MuratovAS/KiCadLibrary/Design/file-fAozOVlaFB.png

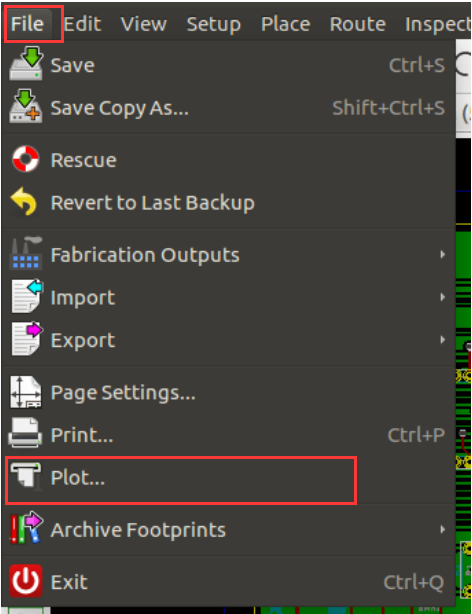
Design/file-fAozOVlaFB.png
