MuratovAS/KiCadLibrary/Design/file-UGBUPNOf6w.png

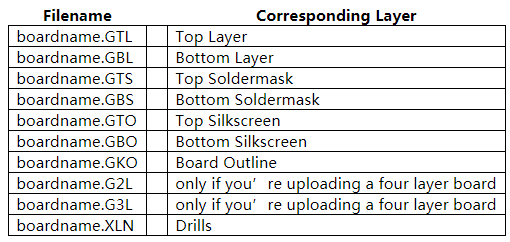
Design/file-UGBUPNOf6w.png
