MuratovAS/KiCadLibrary/Design/FjrqlNe.png

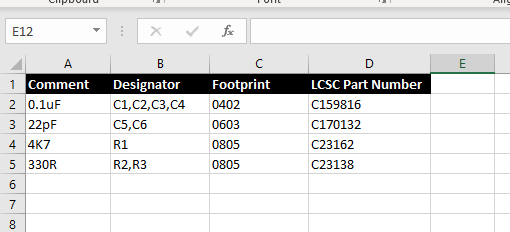
Design/FjrqlNe.png
