MuratovAS/KiCadLibrary/Design/image-20200629161657281.png

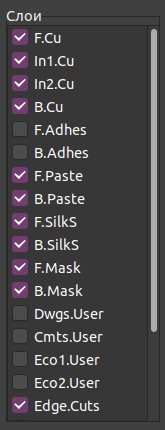
Design/image-20200629161657281.png
