MuratovAS/KiCadLibrary/Design/image-20200629163002211.png

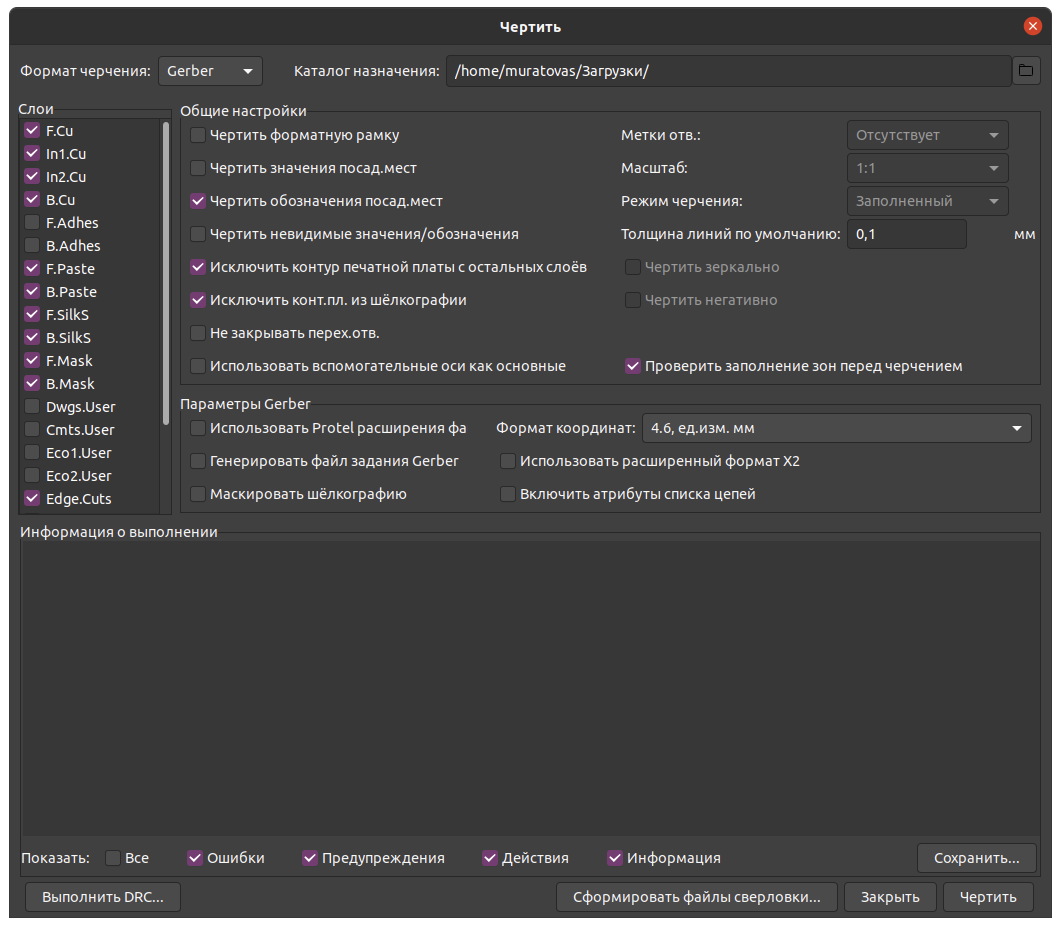
Design/image-20200629163002211.png
