MuratovAS/KiCadLibrary/Design/image-20200629163720507.png

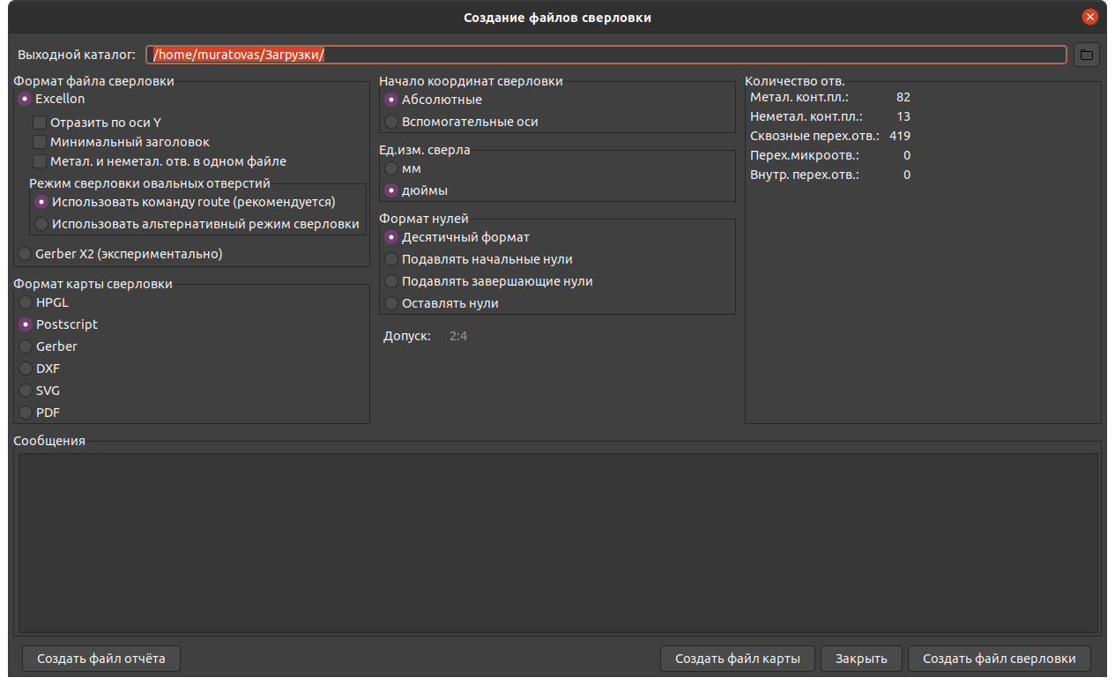
Design/image-20200629163720507.png
