MuratovAS/KiCadLibrary/Design/image-20200629165521541.png

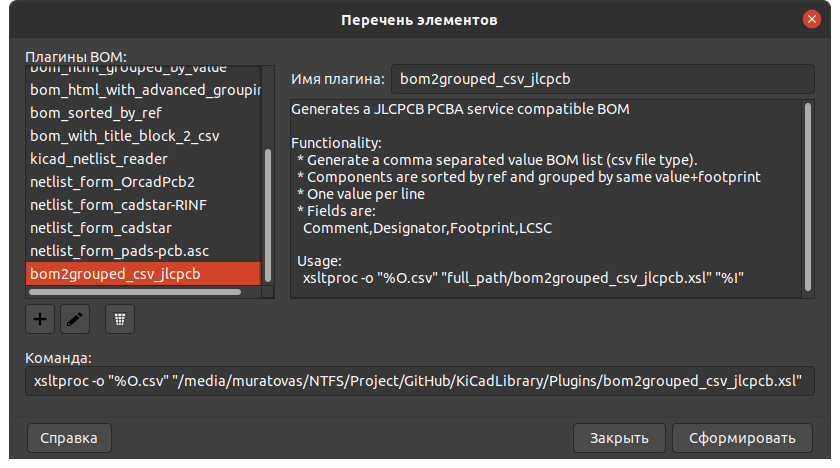
Design/image-20200629165521541.png
