MuratovAS/KiCadLibrary/Design/image-20200629165741140.png

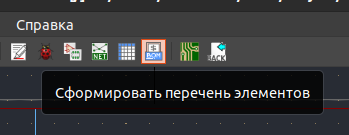
Design/image-20200629165741140.png
