MuratovAS/KiCadLibrary/Design/image-20200629170337778.png

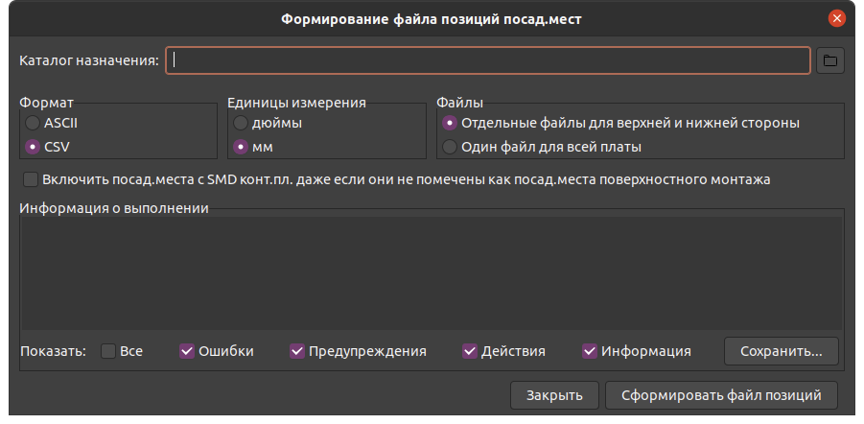
Design/image-20200629170337778.png
