MuratovAS/KiCadLibrary/Design/JpazXtn.png

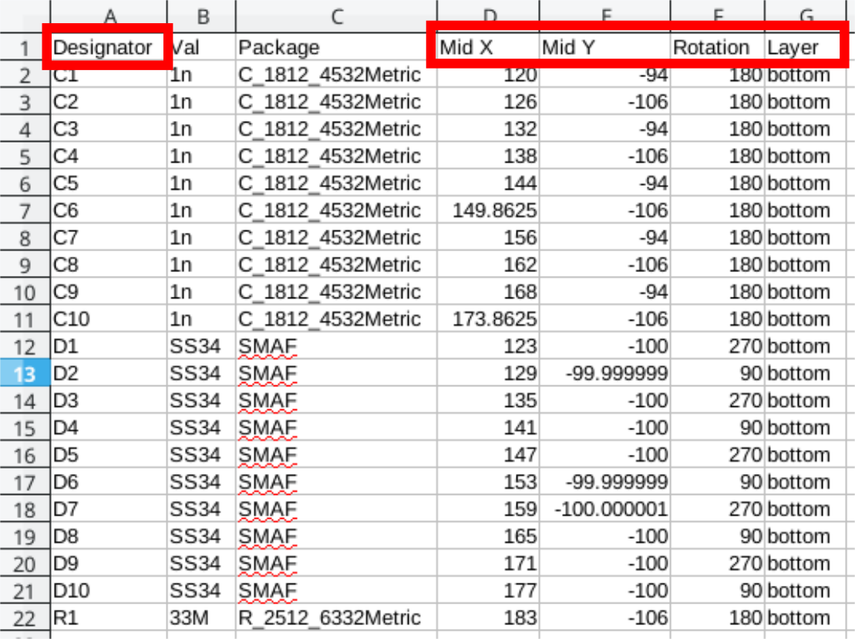
Design/JpazXtn.png
