MuratovAS/KiCadLibrary/MAS_3DModel/BUS_PCI_Express_Mini_cardFull.step

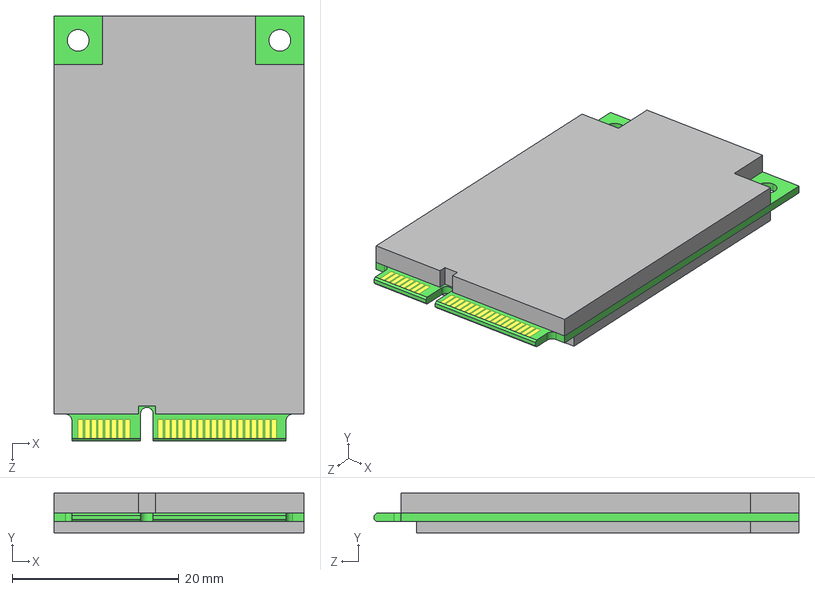
[picture p16: CAD file, 2023-09-08]
MAS_3DModel/BUS_PCI_Express_Mini_cardFull.step
30.0 x 4.75 x 51.0 mm
