MuratovAS/KiCadLibrary/MAS_3DModel/W9751G6NB.stp

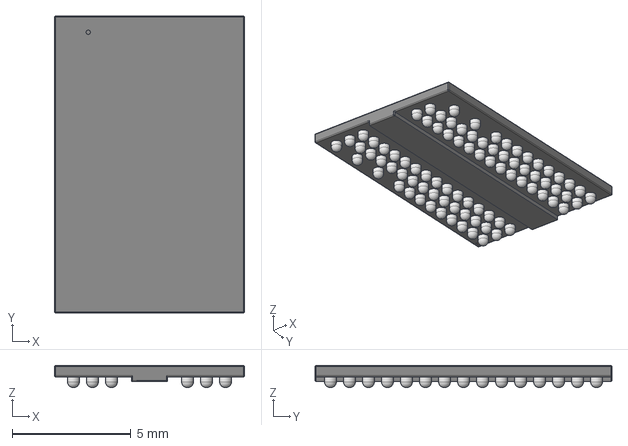
[picture p17: CAD file, 2026-10-26]
MAS_3DModel/W9751G6NB.stp
8.00 x 12.5 x 0.93 mm
