MuratovAS/KiCadLibrary/MAS_3DModel/CONB127P-2R-16W_TH.STEP

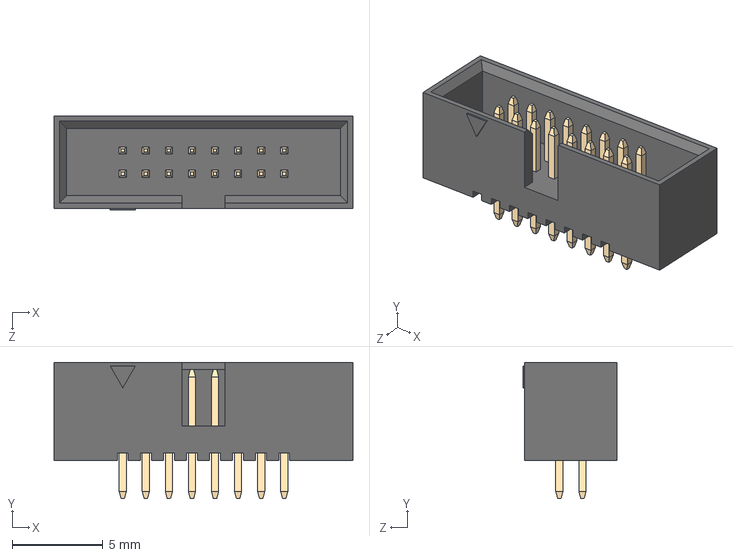
[picture p18: CAD file, 2026-10-22]
MAS_3DModel/CONB127P-2R-16W_TH.STEP
16.5 x 7.50 x 5.20 mm
