MuratovAS/KiCadLibrary/MAS_3DModel/CONB127P-2R-20W_TH.STEP

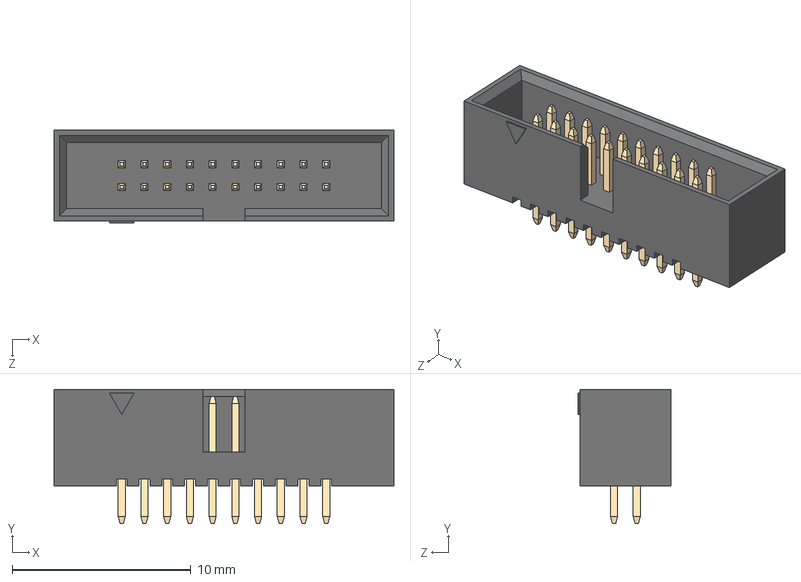
[picture p19: CAD file, 2026-10-22]
MAS_3DModel/CONB127P-2R-20W_TH.STEP
19.0 x 7.50 x 5.20 mm
