MuratovAS/KiCadLibrary/MAS_3DModel/CONB127P-2R-14W_TH.STEP

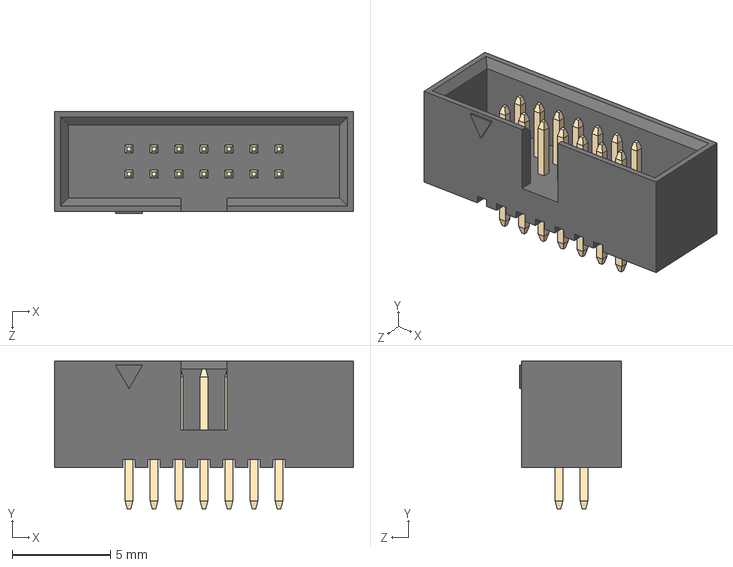
[picture p20: CAD file, 2026-10-22]
MAS_3DModel/CONB127P-2R-14W_TH.STEP
15.2 x 7.50 x 5.20 mm
