MuratovAS/KiCadLibrary/MAS_3DModel/CONB127P-2R-26W_TH.STEP

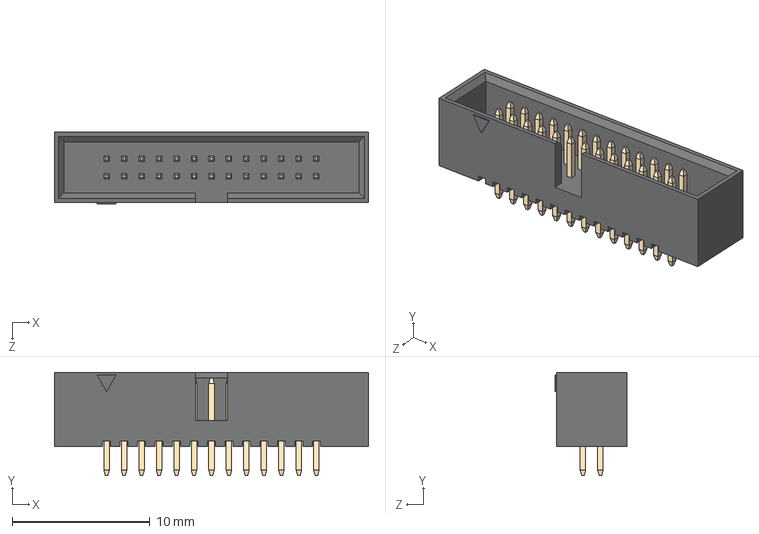
[picture p21: CAD file, 2026-10-22]
MAS_3DModel/CONB127P-2R-26W_TH.STEP
22.8 x 7.50 x 5.20 mm
