MuratovAS/KiCadLibrary/MAS_3DModel/MP_Wurth_WP-BUCF_7461086.stp

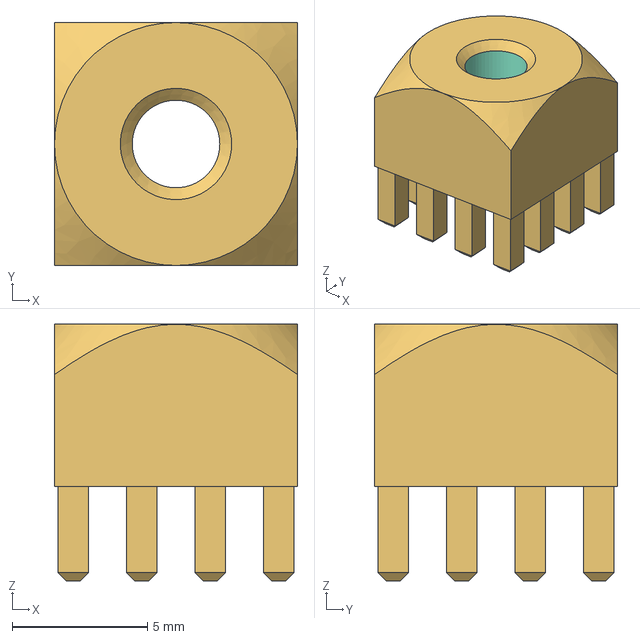
[picture p22: CAD file, 2026-10-15]
MAS_3DModel/MP_Wurth_WP-BUCF_7461086.stp
9.00 x 9.00 x 9.50 mm
