MuratovAS/KiCadLibrary/MAS_3DModel/SIP-8.stp

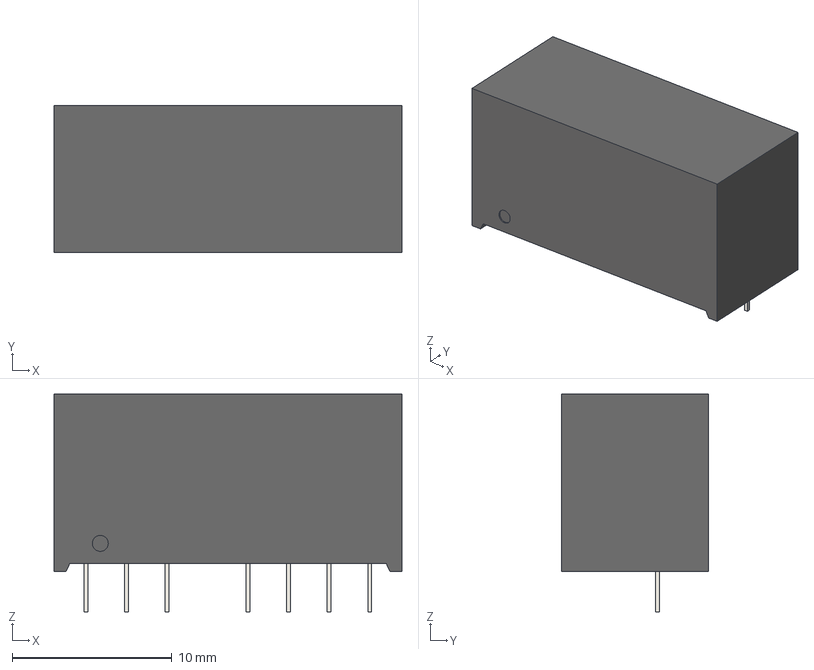
[picture p23: CAD file, 2026-09-12]
MAS_3DModel/SIP-8.stp
21.8 x 9.20 x 13.6 mm
SIP-8
SIP-001
SIP-002
SIP-003
SIP-004
SIP-005
SIP-006
SIP-007
