MuratovAS/KiCadLibrary/MAS_3DModel/TSSOP-28_7.5x10.5mm_P0.65mm.stp

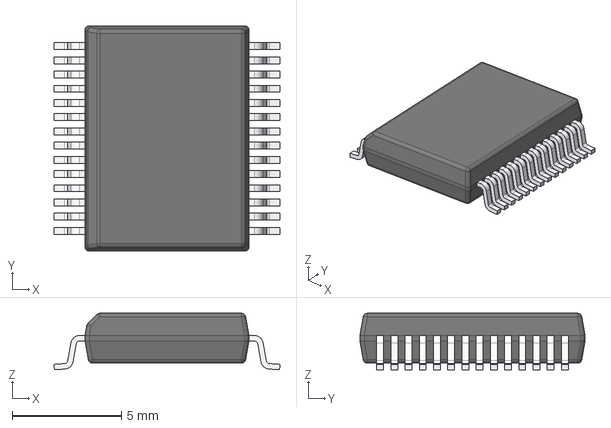
[picture p24: CAD file, 2026-09-12]
MAS_3DModel/TSSOP-28_7.5x10.5mm_P0.65mm.stp
10.3 x 10.3 x 2.59 mm
LEAD x 28
