MuratovAS/KiCadLibrary/MAS_3DModel/DG381-3.81-02P-14-00AH.STEP

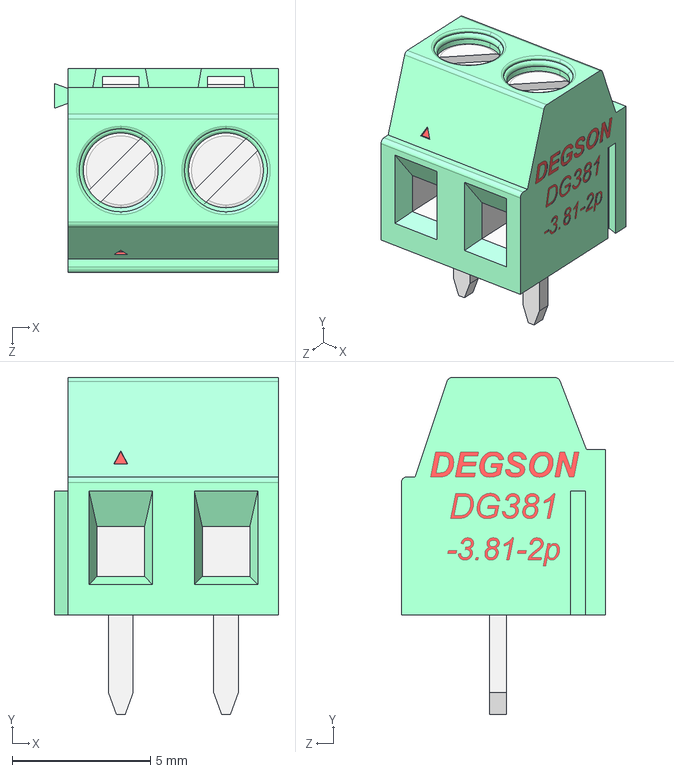
[picture p25: CAD file, 2026-08-06]
MAS_3DModel/DG381-3.81-02P-14-00AH.STEP
8.12 x 12.2 x 7.40 mm
