MuratovAS/KiCadLibrary/MAS_3DModel/15EDGRC-3.81-11P.stp

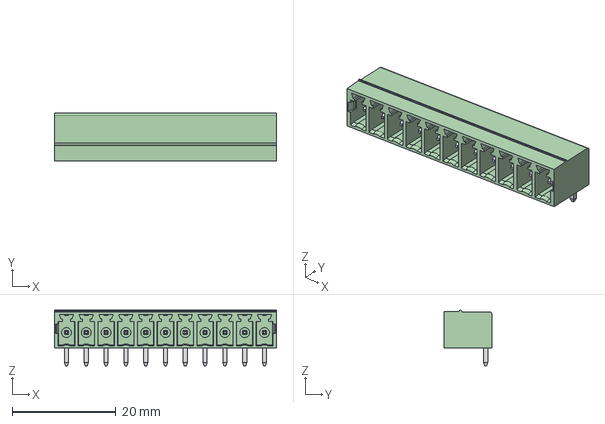
[picture p26: CAD file, 2026-08-06]
MAS_3DModel/15EDGRC-3.81-11P.stp
42.7 x 9.20 x 10.7 mm
15EDGxC-3.81-11P
15EDGRC_pin x 11
