MuratovAS/KiCadLibrary/MAS_3DModel/SCH16T.stp

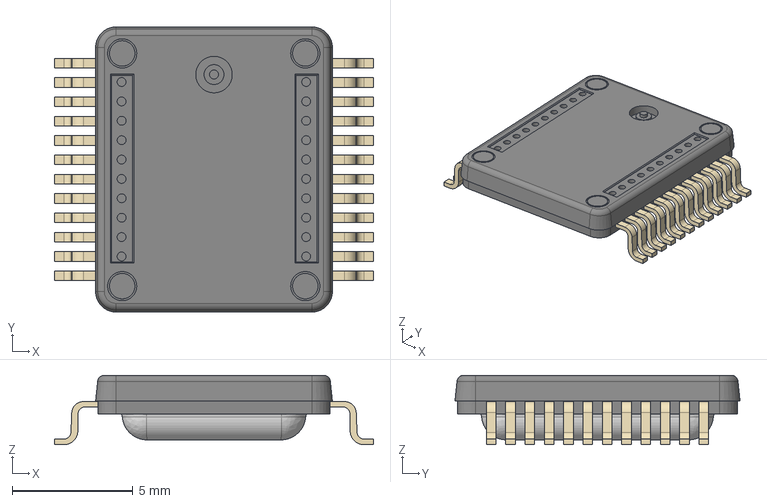
[picture p27: CAD file, 2026-07-28]
MAS_3DModel/SCH16T.stp
13.2 x 11.8 x 2.87 mm
