MuratovAS/KiCadLibrary/MAS_3DModel/TRACO_THR_40-72xWI.stp

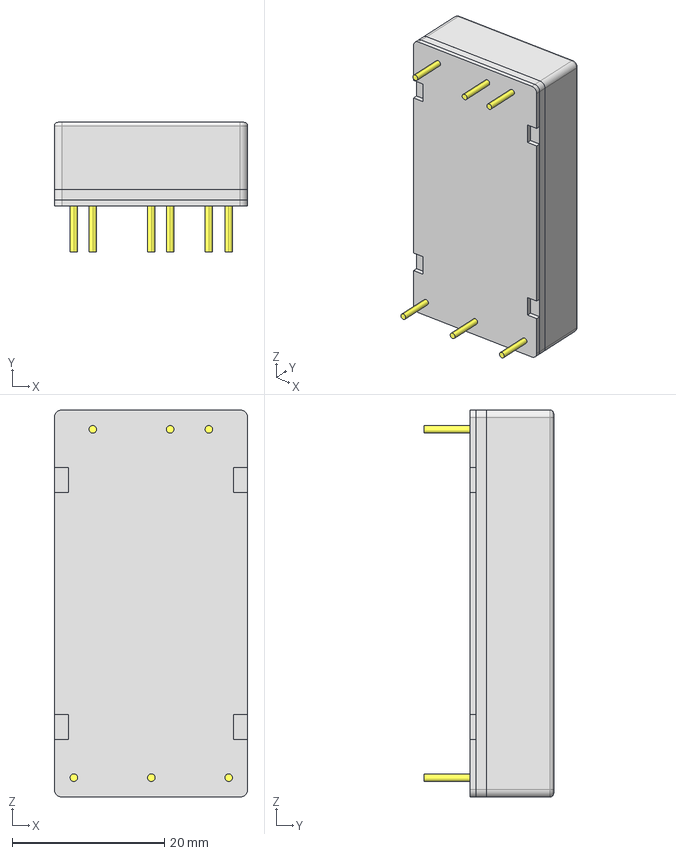
[picture p28: CAD file, 2026-07-25]
MAS_3DModel/TRACO_THR_40-72xWI.stp
25.4 x 17.0 x 50.8 mm
