MuratovAS/KiCadLibrary/MAS_3DModel/RJ45_AT-889X1-FSE_Vertical.step

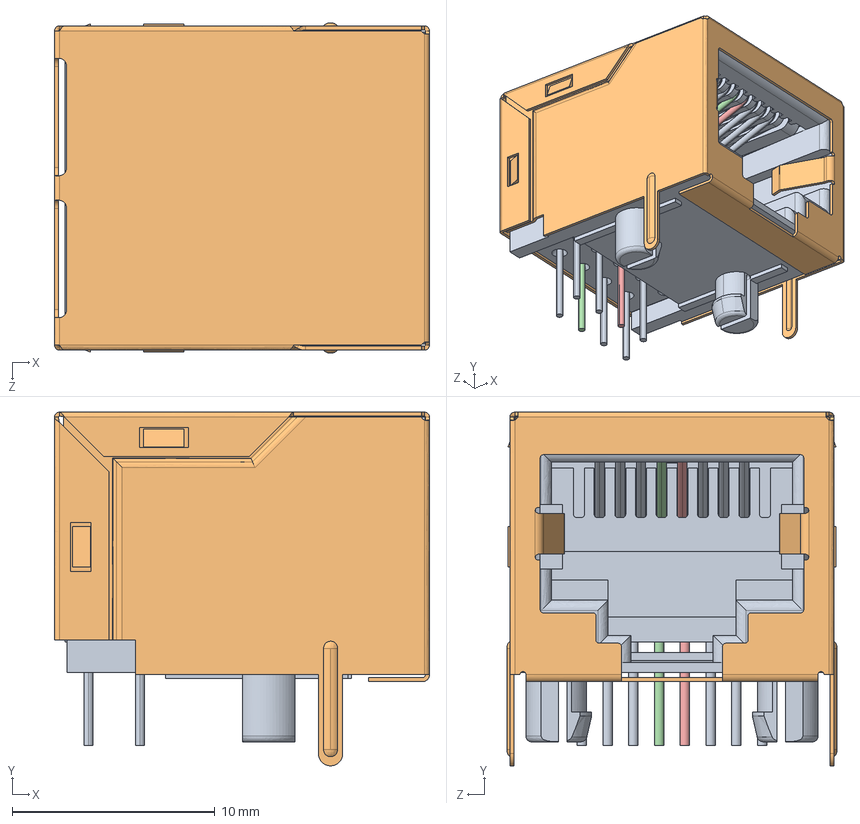
[picture p29: CAD file, 2026-07-22]
MAS_3DModel/RJ45_AT-889X1-FSE_Vertical.step
18.5 x 17.4 x 16.3 mm
