MuratovAS/KiCadLibrary/MAS_3DModel/RJ45_TE_100616-X_Vertical.stp

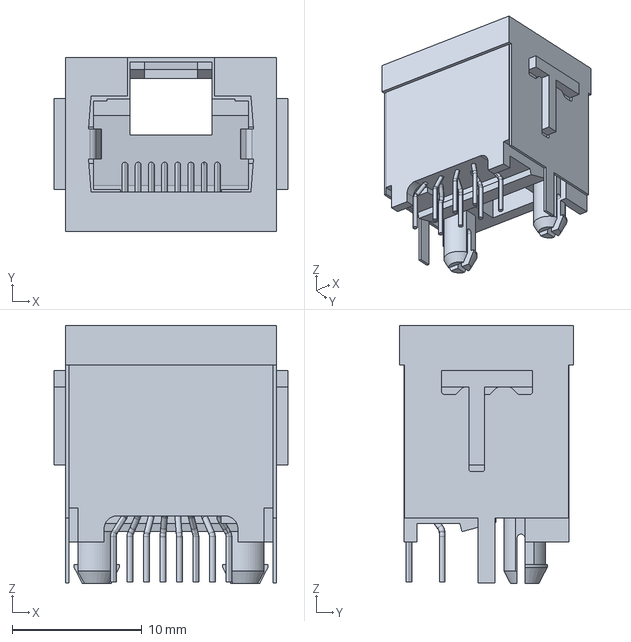
[picture p30: CAD file, 2026-07-03]
MAS_3DModel/RJ45_TE_100616-X_Vertical.stp
18.0 x 13.4 x 19.9 mm
