MuratovAS/KiCadLibrary/MAS_3DModel/Molex_Micro-Fit_3.0_43645-0400_1x04_P3.00mm.stp

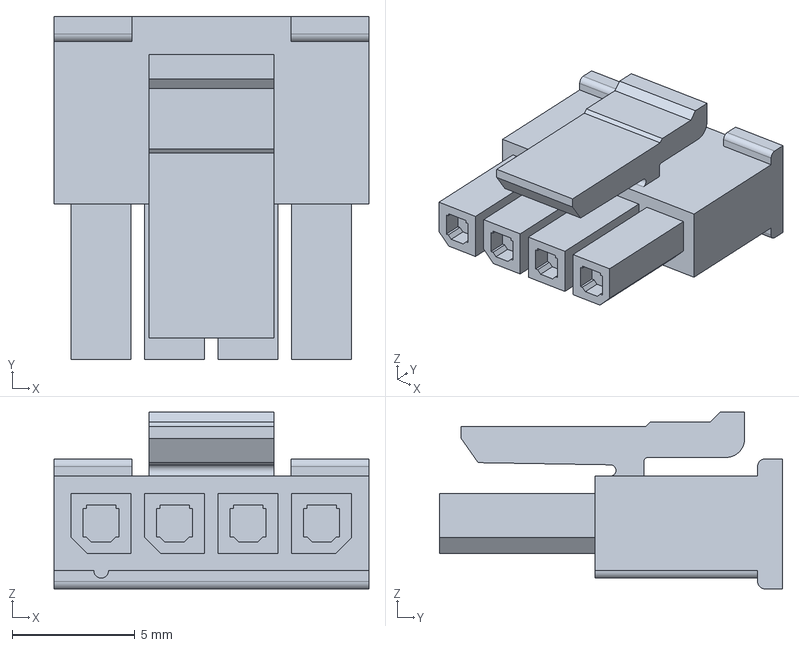
[picture p31: CAD file, 2026-07-01]
MAS_3DModel/Molex_Micro-Fit_3.0_43645-0400_1x04_P3.00mm.stp
12.8 x 14.0 x 7.21 mm
