MuratovAS/KiCadLibrary/MAS_3DModel/Molex_Micro-Fit_3.0_43650-0415_1x04_P3.00mm_Vertical.stp

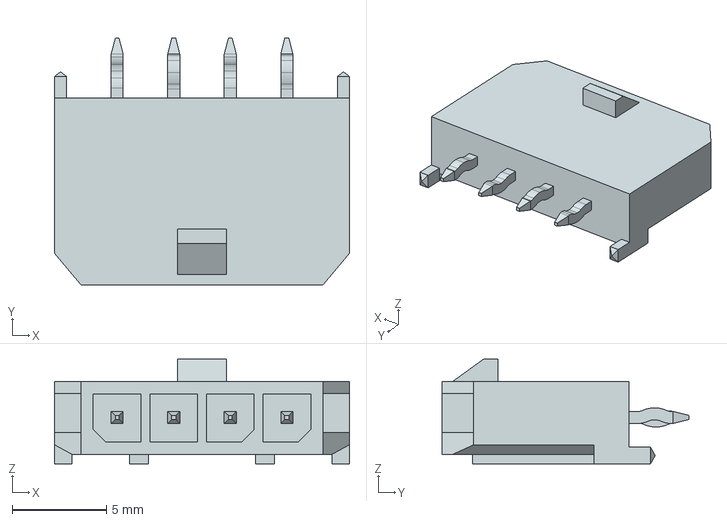
[picture p32: CAD file, 2026-07-01]
MAS_3DModel/Molex_Micro-Fit_3.0_43650-0415_1x04_P3.00mm_Vertical.stp
15.7 x 13.1 x 5.57 mm
