MuratovAS/KiCadLibrary/MAS_3DModel/RJ45_TE_1734577-1_Vertical.stp

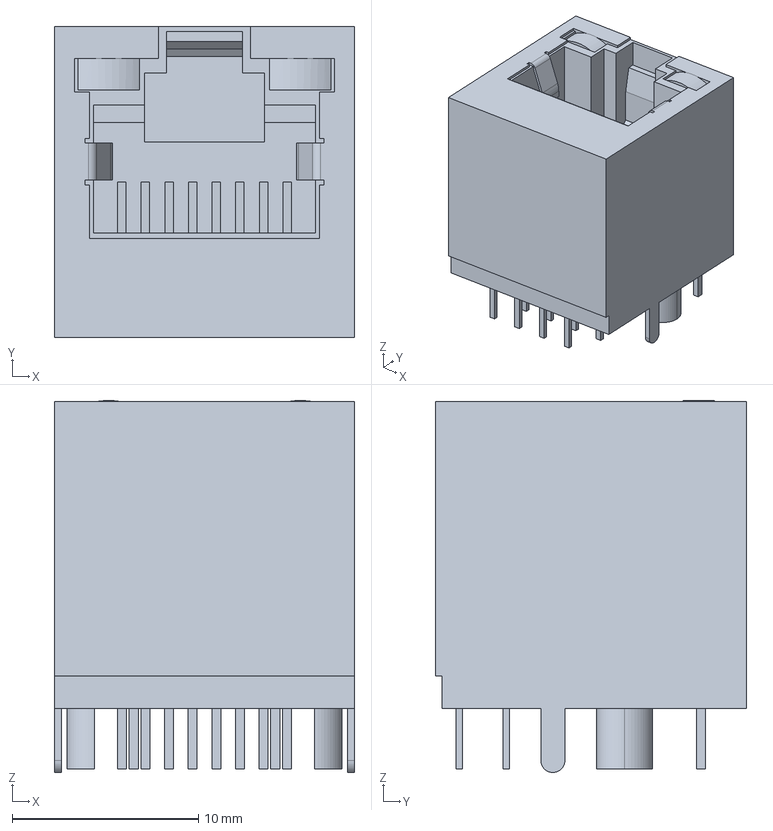
[picture p33: CAD file, 2026-07-01]
MAS_3DModel/RJ45_TE_1734577-1_Vertical.stp
16.1 x 16.7 x 20.0 mm
