MuratovAS/KiCadLibrary/MAS_3DModel/Fuse_2410.step

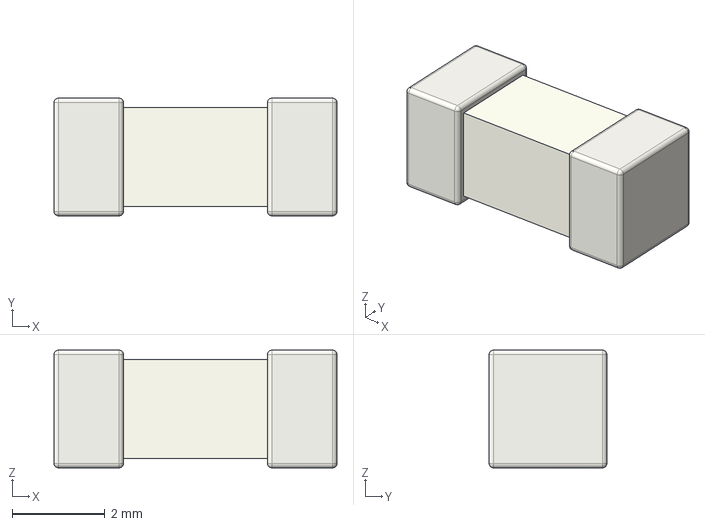
[picture p34: CAD file, 2026-05-28]
MAS_3DModel/Fuse_2410.step
6.10 x 2.54 x 2.54 mm
