MuratovAS/KiCadLibrary/MAS_3DModel/DFN-8L-1EP-S_3.3x3.3mm_P0.65mm_EP1.93x2.45mm.step

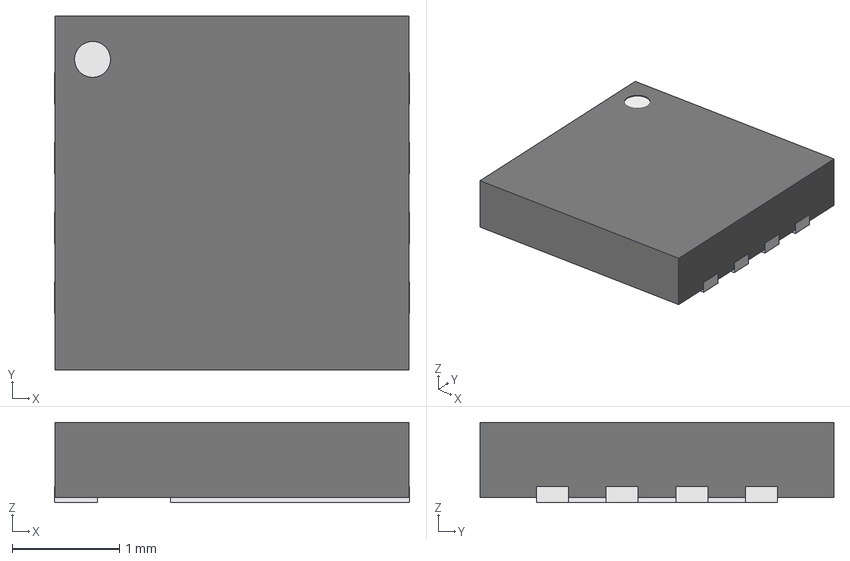
[picture p35: CAD file, 2026-05-27]
MAS_3DModel/DFN-8L-1EP-S_3.3x3.3mm_P0.65mm_EP1.93x2.45mm.step
3.31 x 3.30 x 0.75 mm
