MuratovAS/KiCadLibrary/MAS_3DModel/MBS.step

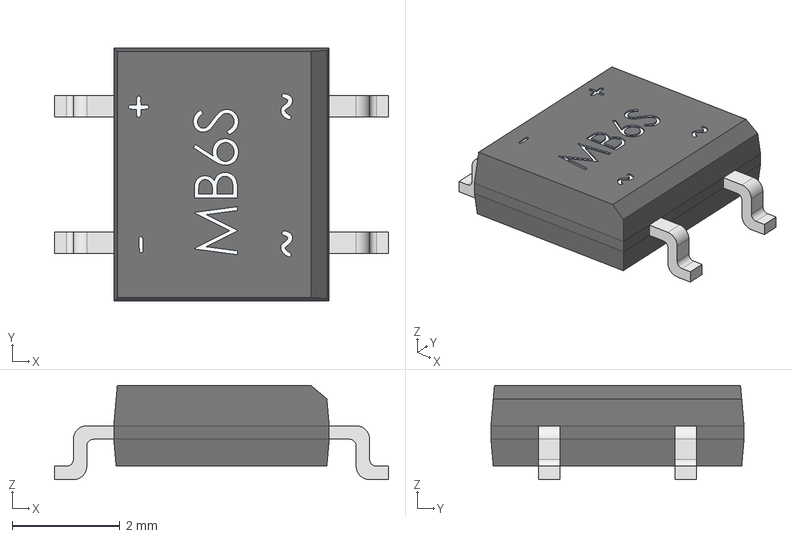
[picture p36: CAD file, 2026-05-25]
MAS_3DModel/MBS.step
6.20 x 4.70 x 1.75 mm
