MuratovAS/KiCadLibrary/MAS_3DModel/DFN-10-1EP_2x2mm_P0.4mm_EP0.9x1.5mm.step

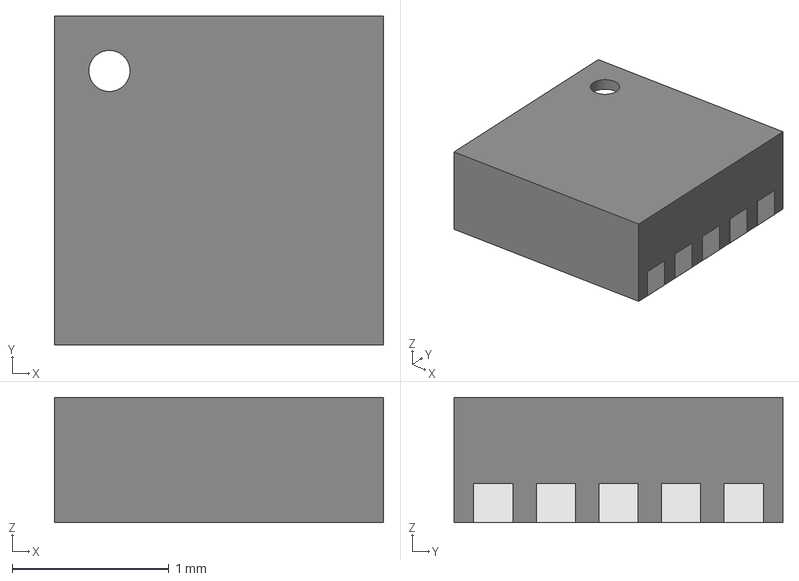
[picture p37: CAD file, 2026-05-06]
MAS_3DModel/DFN-10-1EP_2x2mm_P0.4mm_EP0.9x1.5mm.step
2.10 x 2.10 x 0.801 mm
Thermal Shape
