MuratovAS/KiCadLibrary/MAS_3DModel/ublox-NEO.step

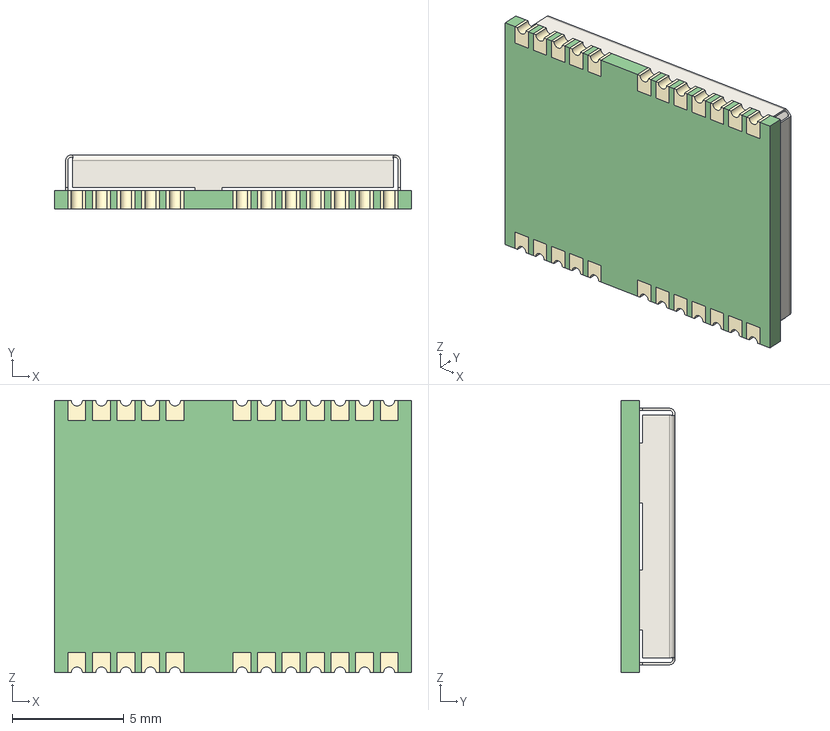
[picture p38: CAD file, 2026-05-06]
MAS_3DModel/ublox-NEO.step
16.0 x 2.42 x 12.2 mm
Board
Solder pads
