MuratovAS/KiCadLibrary/MAS_3DModel/DF40HC(3.0)-100DS-0.4V.step

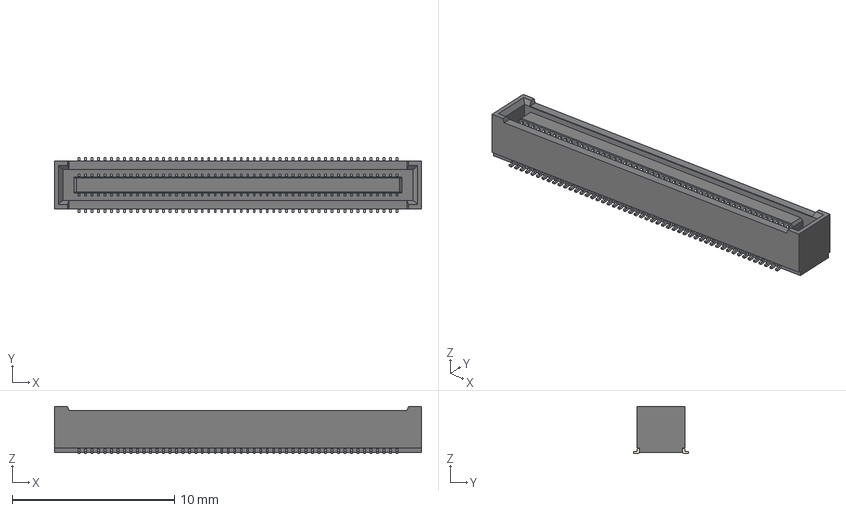
[picture p40: CAD file, 2026-03-02]
MAS_3DModel/DF40HC(3.0)-100DS-0.4V.step
22.6 x 3.38 x 2.90 mm
