MuratovAS/KiCadLibrary/MAS_3DModel/KLS2-EDR-5.08-02P-4.step

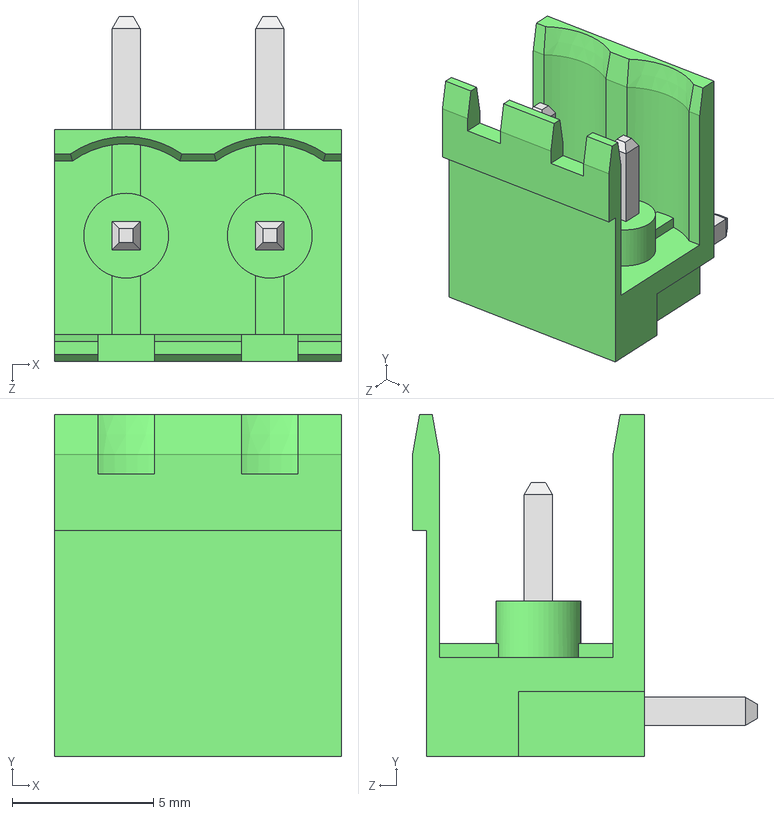
[picture p41: CAD file, 2026-02-09]
MAS_3DModel/KLS2-EDR-5.08-02P-4.step
10.2 x 12.1 x 12.2 mm
