MuratovAS/KiCadLibrary/MAS_3DModel/POGO_PIN_(C2842933).step

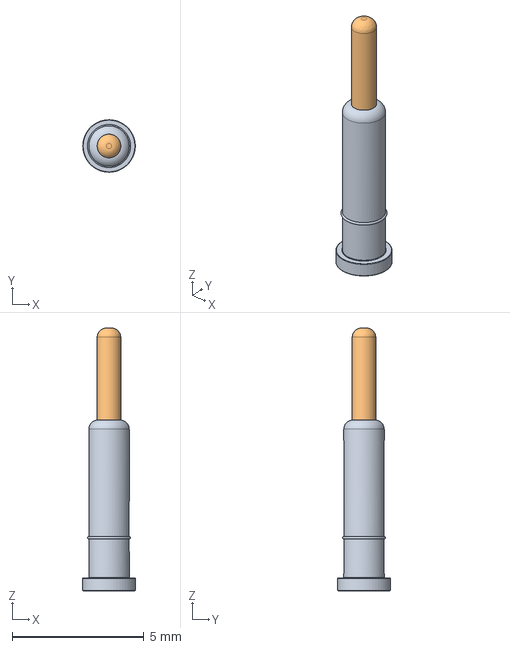
[picture p42: CAD file, 2026-01-09]
MAS_3DModel/POGO_PIN_(C2842933).step
2.00 x 2.00 x 10.0 mm
Base
Pin
