MuratovAS/KiCadLibrary/MAS_3DModel/TMH_2412S.STEP

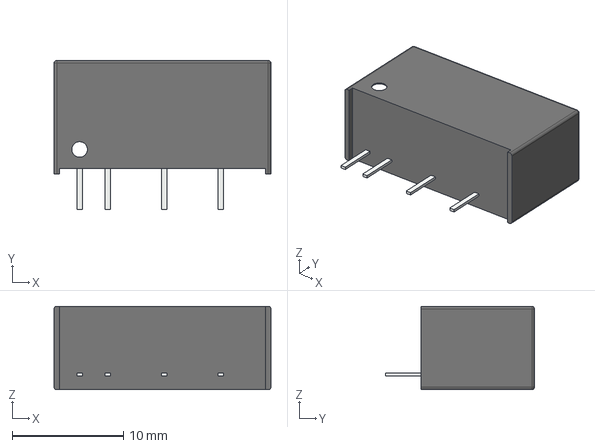
[picture p43: CAD file, 2025-12-05]
MAS_3DModel/TMH_2412S.STEP
19.5 x 13.4 x 7.50 mm
