MuratovAS/KiCadLibrary/MAS_3DModel/MX1016B-10.16-03P.step

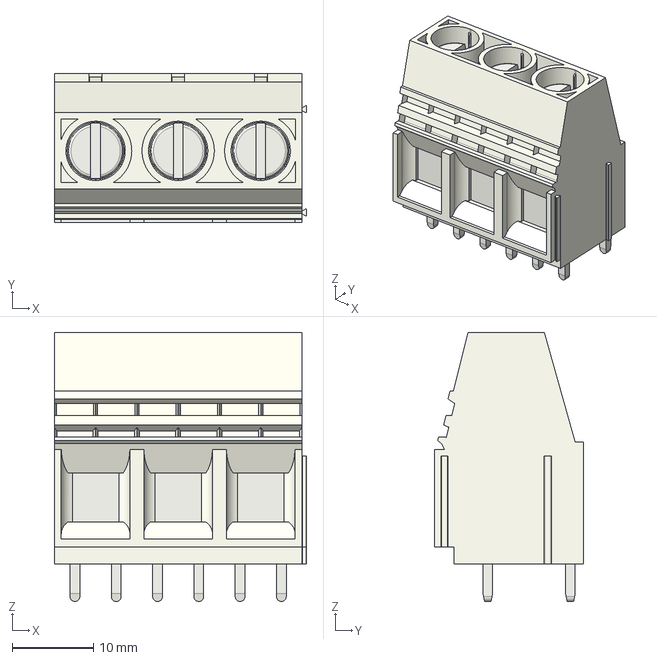
[picture p44: CAD file, 2025-11-14]
MAS_3DModel/MX1016B-10.16-03P.step
31.0 x 18.3 x 33.1 mm
