MuratovAS/KiCadLibrary/MAS_3DModel/MeanWell_IRM-30-x.step

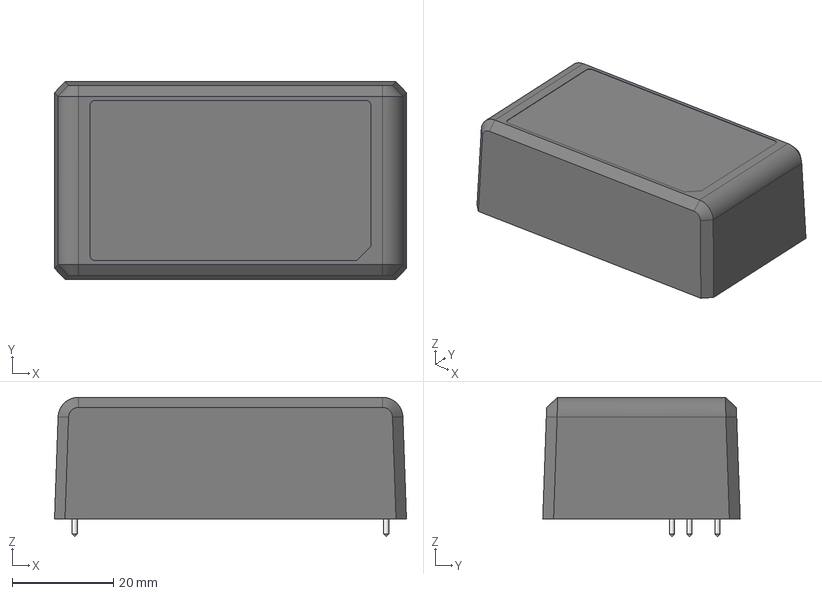
[picture p45: CAD file, 2025-11-11]
MAS_3DModel/MeanWell_IRM-30-x.step
69.5 x 39.0 x 27.5 mm
