MuratovAS/KiCadLibrary/MAS_3DModel/R_3920.STEP

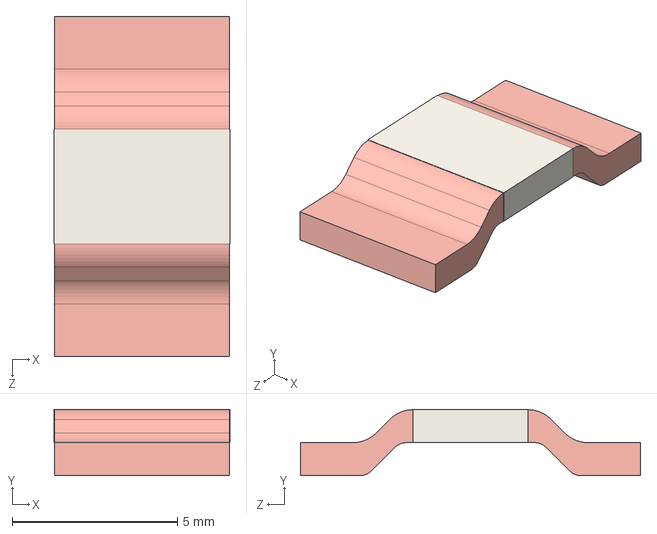
[picture p46: CAD file, 2025-11-05]
MAS_3DModel/R_3920.STEP
5.32 x 2.01 x 10.3 mm
