MuratovAS/KiCadLibrary/MAS_3DModel/BL-R8812AF1.step

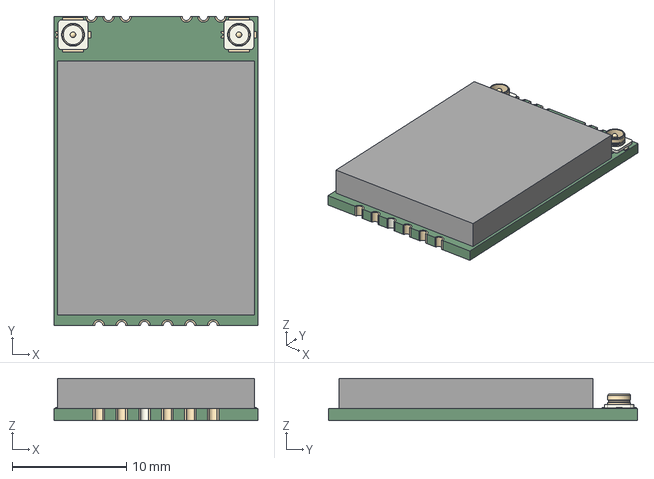
[picture p47: CAD file, 2025-10-19]
MAS_3DModel/BL-R8812AF1.step
17.8 x 27.0 x 3.68 mm
