MuratovAS/KiCadLibrary/MAS_3DModel/USL00-30L.step

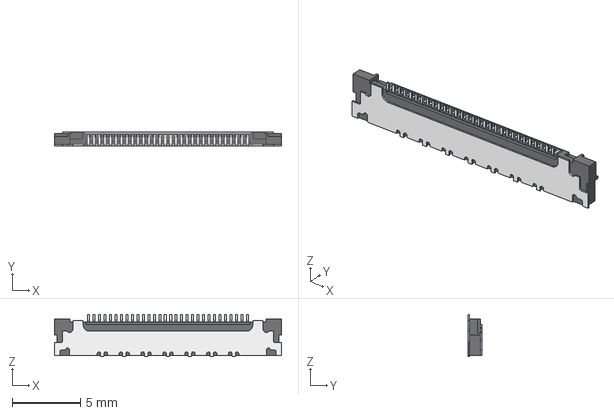
[picture p48: CAD file, 2025-06-16]
MAS_3DModel/USL00-30L.step
16.6 x 1.00 x 3.10 mm
