MuratovAS/KiCadLibrary/MAS_3DModel/USL00-30LC.step

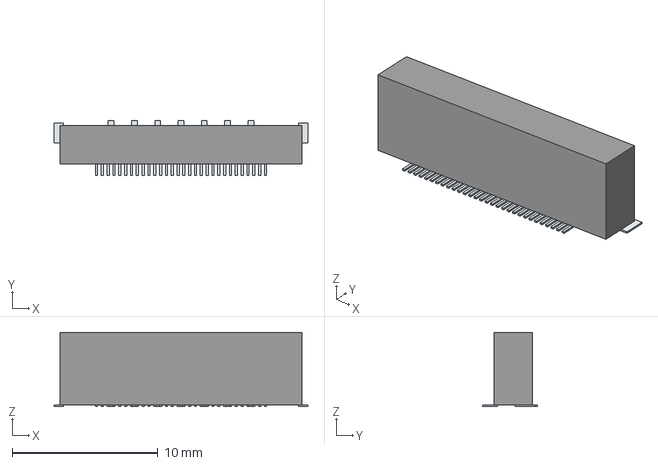
[picture p49: CAD file, 2025-06-16]
MAS_3DModel/USL00-30LC.step
17.4 x 3.81 x 5.10 mm
Pins
