MuratovAS/KiCadLibrary/MAS_3DModel/CF_0402_4pin.step

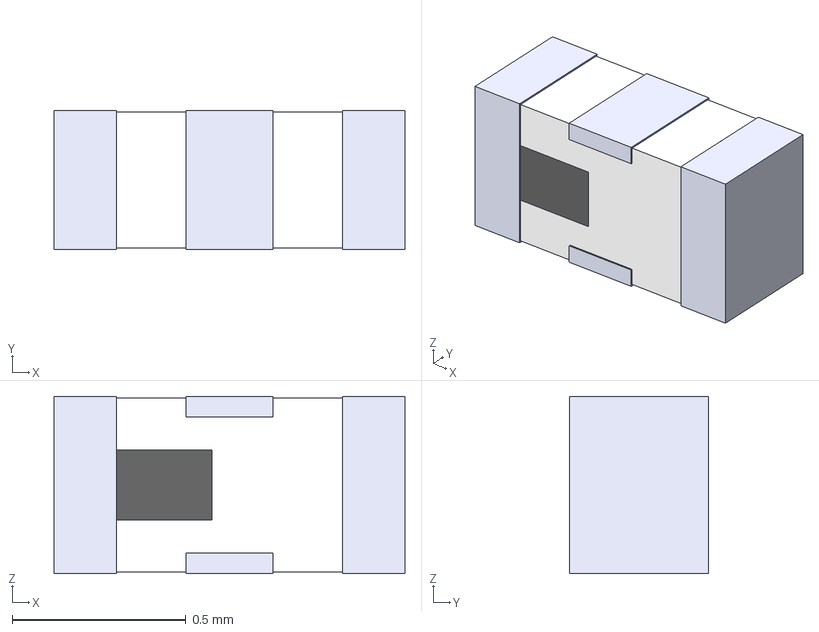
[picture p50: CAD file, 2025-03-28]
MAS_3DModel/CF_0402_4pin.step
1.01 x 0.4 x 0.51 mm
2450FM07A0029T
