MuratovAS/KiCadLibrary/MAS_3DModel/SMTSO3020.step

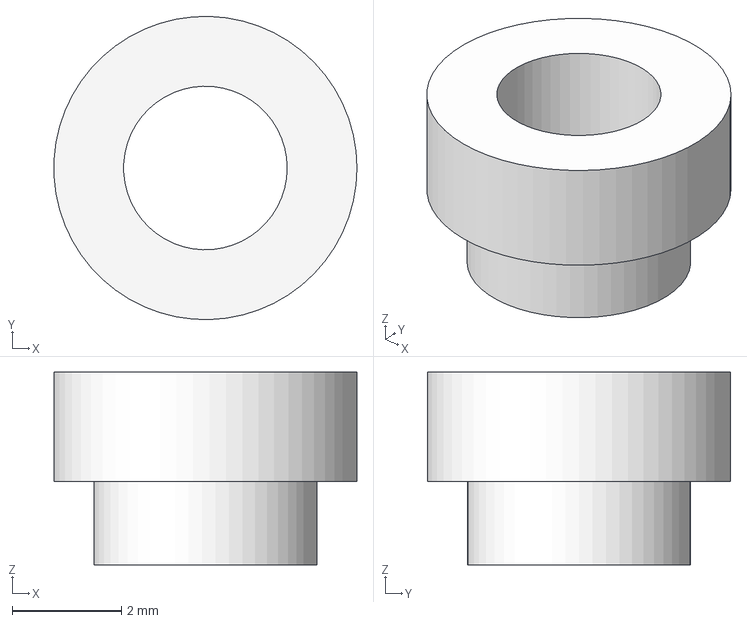
[picture p52: CAD file, 2025-03-26]
MAS_3DModel/SMTSO3020.step
5.56 x 5.56 x 3.53 mm
