MuratovAS/KiCadLibrary/MAS_3DModel/SMTSO3025.step

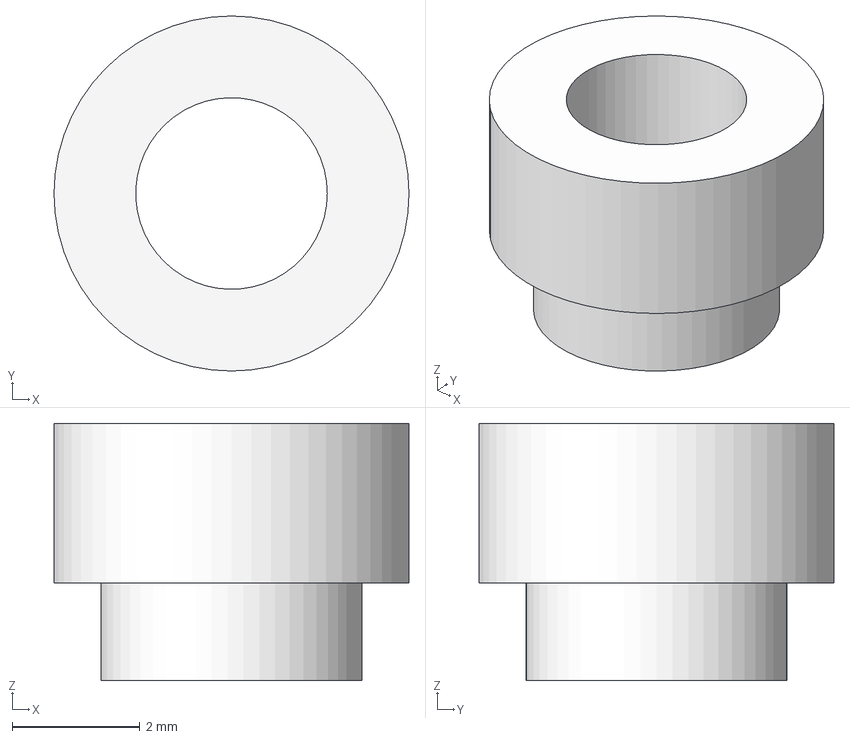
[picture p54: CAD file, 2025-03-26]
MAS_3DModel/SMTSO3025.step
5.56 x 5.56 x 4.03 mm
