MuratovAS/KiCadLibrary/MAS_3DModel/SMTSO3030.step

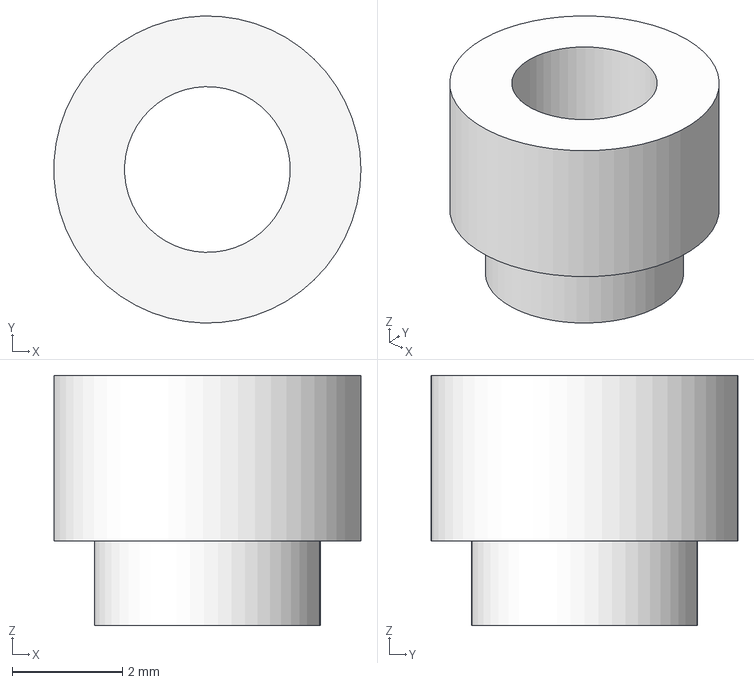
[picture p55: CAD file, 2025-03-26]
MAS_3DModel/SMTSO3030.step
5.56 x 5.56 x 4.53 mm
