MuratovAS/KiCadLibrary/MAS_3DModel/SMTSO3040.step

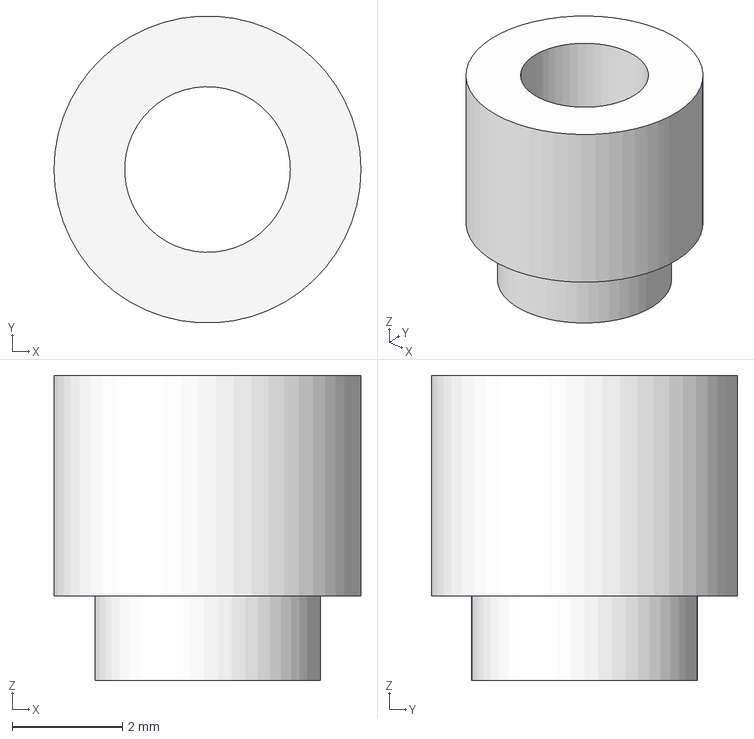
[picture p56: CAD file, 2025-03-26]
MAS_3DModel/SMTSO3040.step
5.56 x 5.55 x 5.53 mm
