MuratovAS/KiCadLibrary/MAS_3DModel/SMTSO3070.step

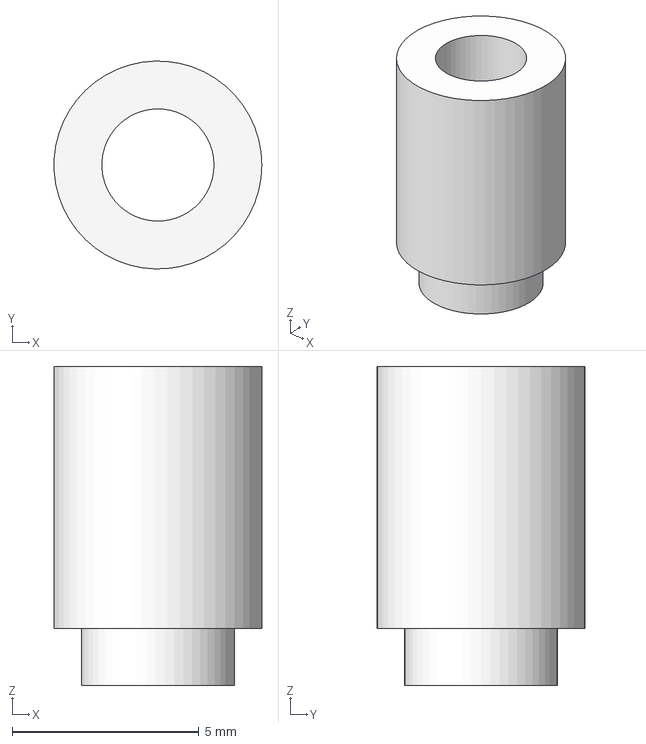
[picture p57: CAD file, 2025-03-26]
MAS_3DModel/SMTSO3070.step
5.55 x 5.56 x 8.53 mm
