MuratovAS/KiCadLibrary/MAS_3DModel/SMTSO3080.step

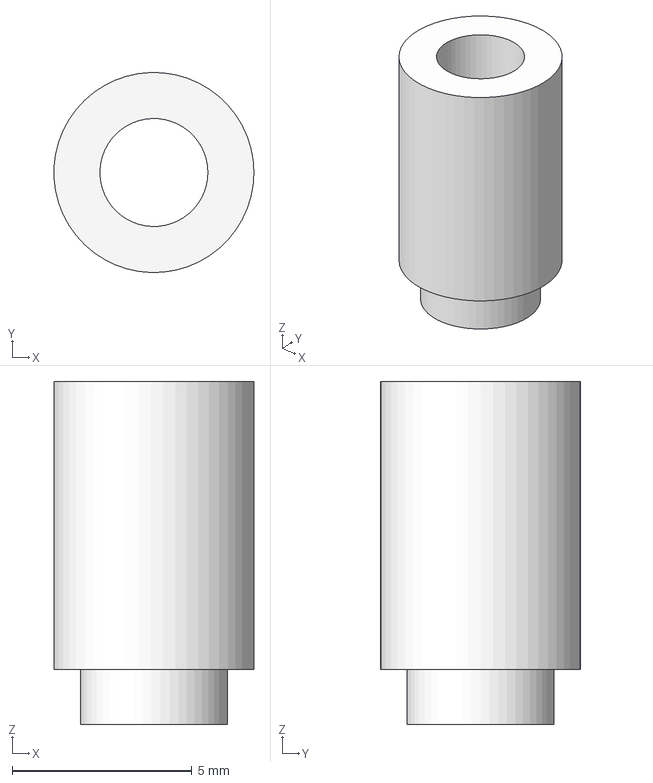
[picture p58: CAD file, 2025-03-26]
MAS_3DModel/SMTSO3080.step
5.55 x 5.56 x 9.53 mm
