MuratovAS/KiCadLibrary/MAS_3DModel/SMTSO3050.step

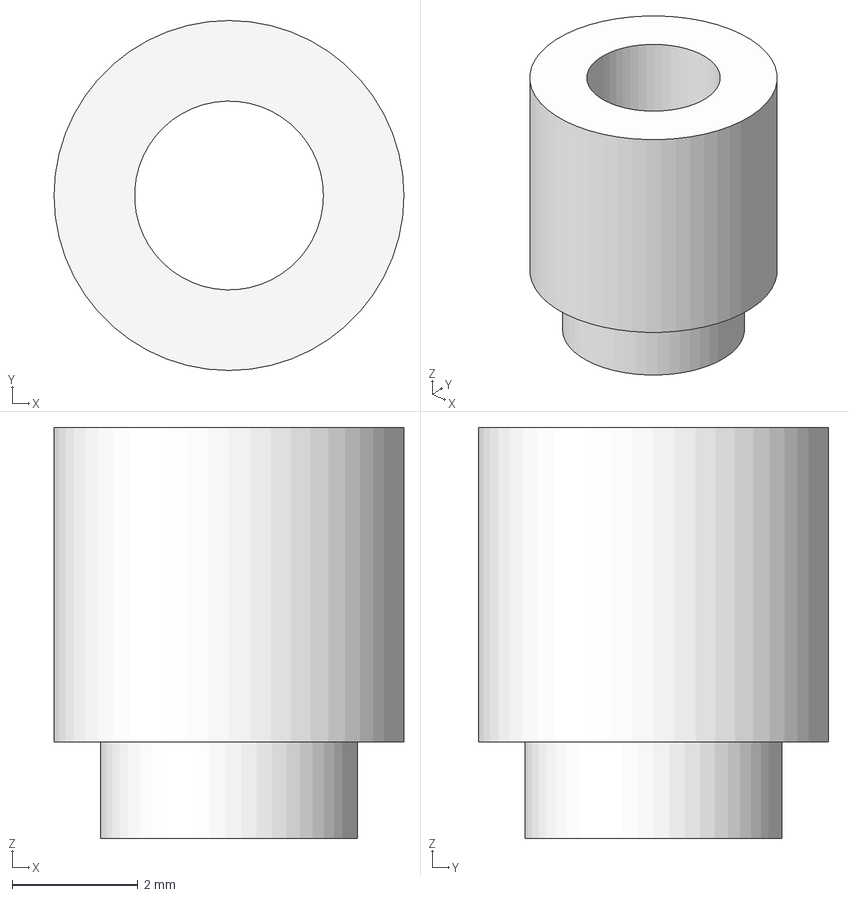
[picture p59: CAD file, 2025-03-26]
MAS_3DModel/SMTSO3050.step
5.56 x 5.56 x 6.53 mm
