MuratovAS/KiCadLibrary/MAS_3DModel/SMTSO3010.step

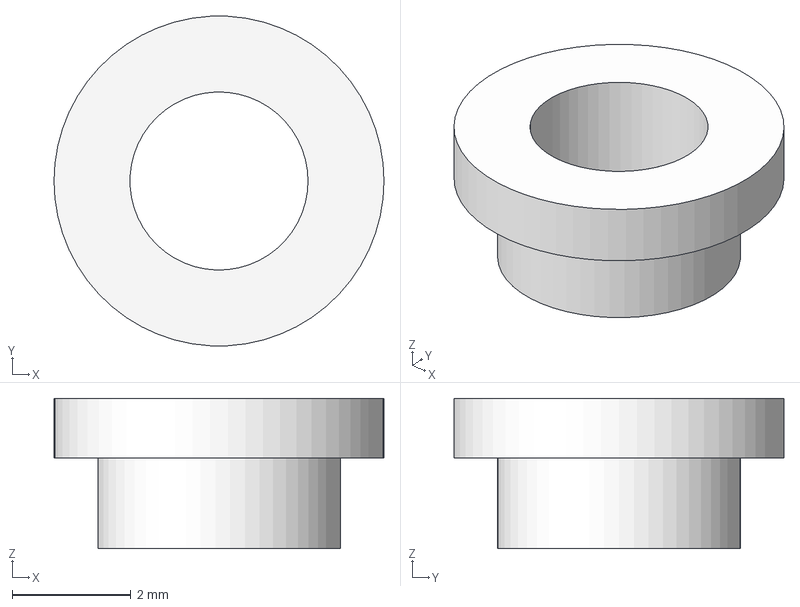
[picture p60: CAD file, 2025-03-26]
MAS_3DModel/SMTSO3010.step
5.56 x 5.55 x 2.53 mm
