MuratovAS/KiCadLibrary/MAS_3DModel/SMTSO3015.step

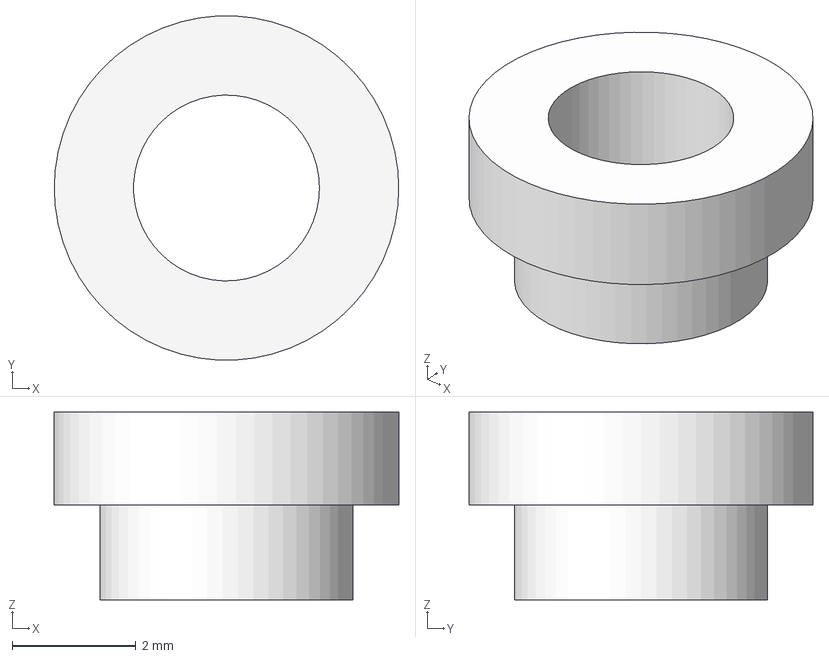
[picture p61: CAD file, 2025-03-26]
MAS_3DModel/SMTSO3015.step
5.56 x 5.55 x 3.03 mm
