MuratovAS/KiCadLibrary/MAS_3DModel/SMTSO3065.step

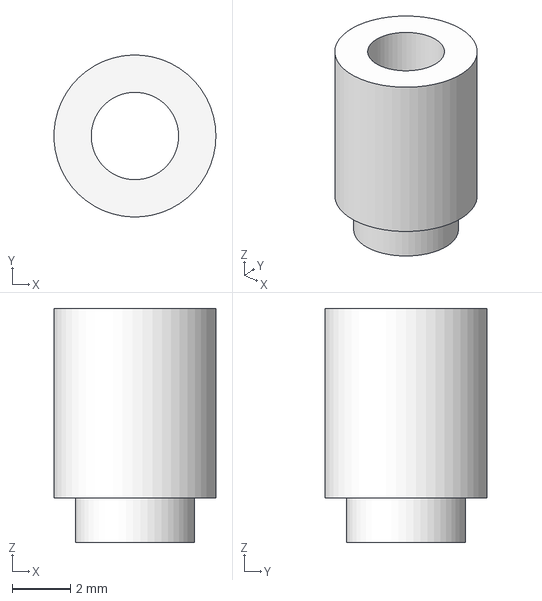
[picture p63: CAD file, 2025-03-26]
MAS_3DModel/SMTSO3065.step
5.55 x 5.56 x 8.03 mm
