MuratovAS/KiCadLibrary/MAS_3DModel/SMTSO3045.step

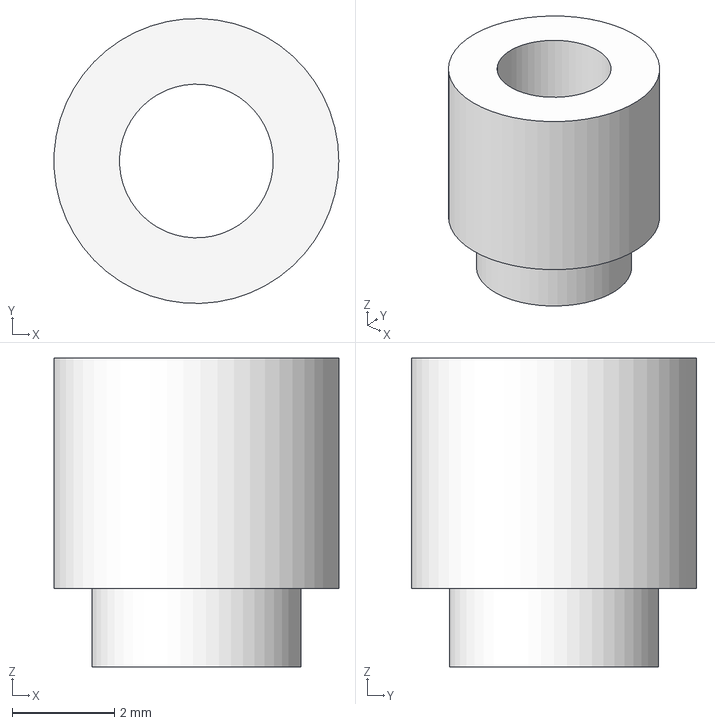
[picture p64: CAD file, 2025-03-26]
MAS_3DModel/SMTSO3045.step
5.56 x 5.56 x 6.03 mm
