MuratovAS/KiCadLibrary/MAS_3DModel/SMTSO3035.step

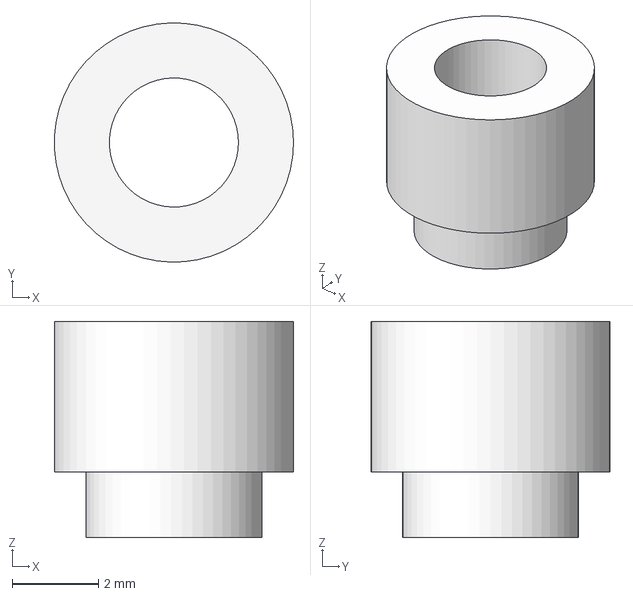
[picture p65: CAD file, 2025-03-26]
MAS_3DModel/SMTSO3035.step
5.56 x 5.56 x 5.03 mm
