MuratovAS/KiCadLibrary/MAS_3DModel/SMTSO3090.step

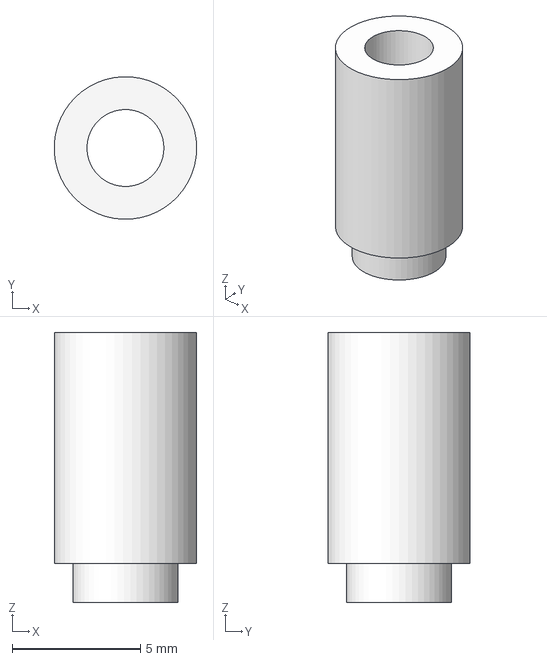
[picture p66: CAD file, 2025-03-26]
MAS_3DModel/SMTSO3090.step
5.55 x 5.56 x 10.5 mm
