MuratovAS/KiCadLibrary/MAS_3DModel/SMTSO2015.step

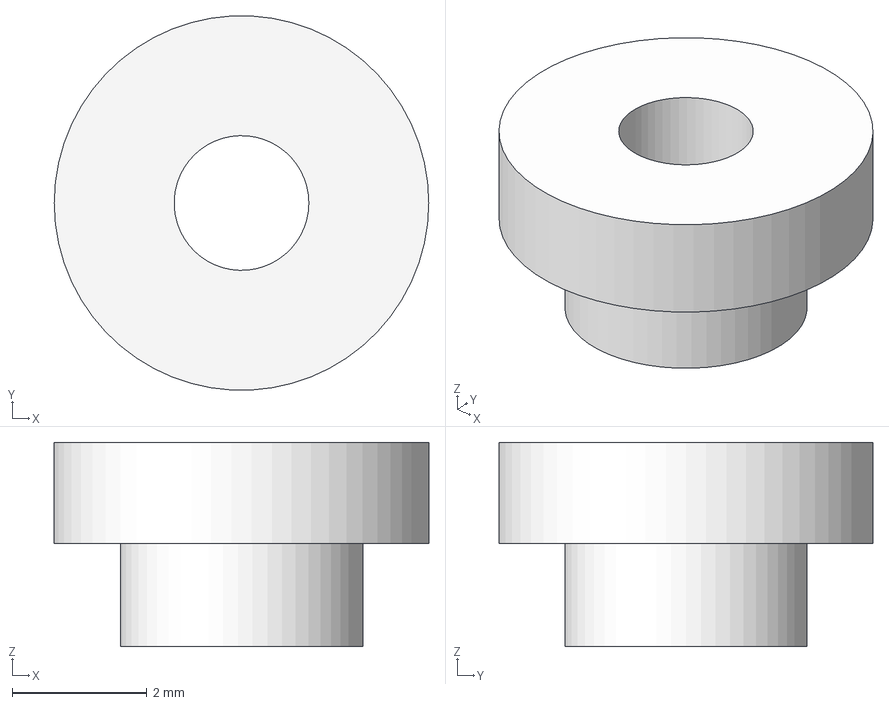
[picture p68: CAD file, 2025-03-26]
MAS_3DModel/SMTSO2015.step
5.56 x 5.55 x 3.03 mm
