MuratovAS/KiCadLibrary/MAS_3DModel/SMTSO2050.step

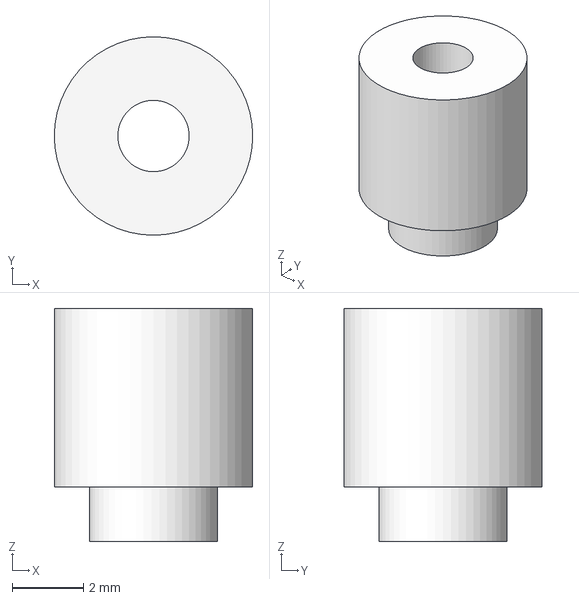
[picture p70: CAD file, 2025-03-26]
MAS_3DModel/SMTSO2050.step
5.56 x 5.56 x 6.53 mm
