MuratovAS/KiCadLibrary/MAS_3DModel/SMTSO2010.step

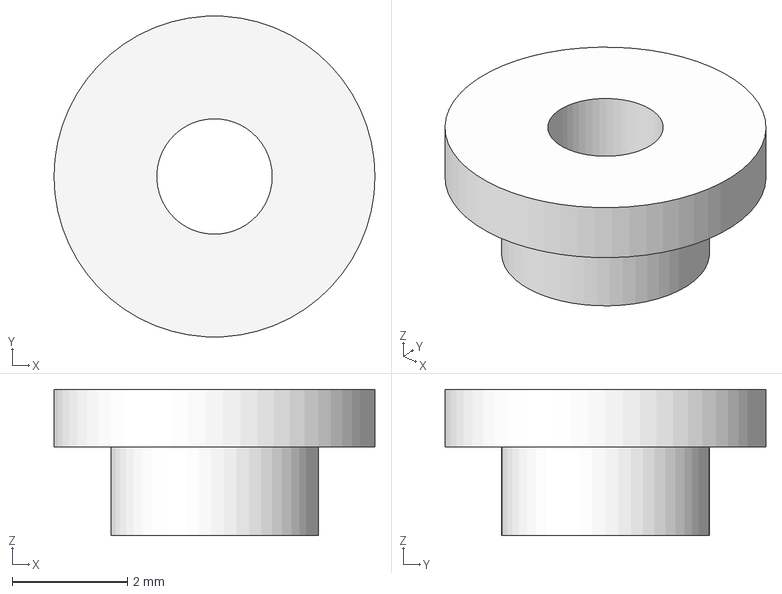
[picture p71: CAD file, 2025-03-26]
MAS_3DModel/SMTSO2010.step
5.56 x 5.55 x 2.53 mm
