MuratovAS/KiCadLibrary/MAS_3DModel/SMTSO20100.step

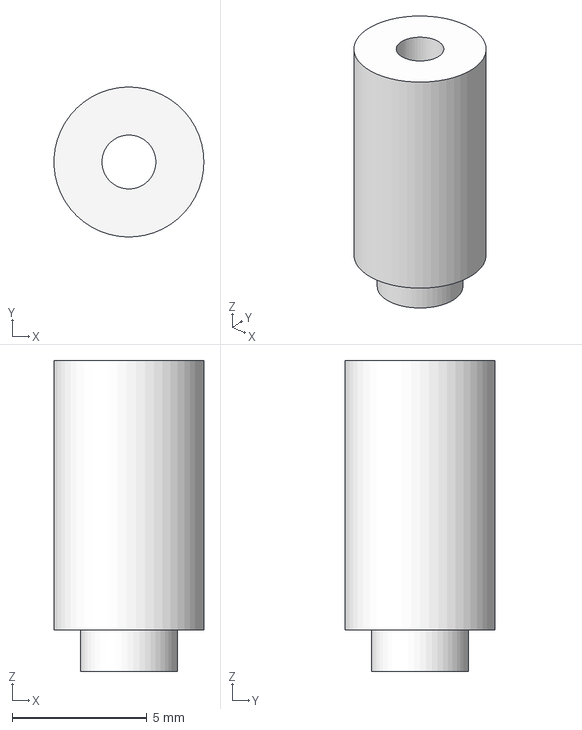
[picture p73: CAD file, 2025-03-26]
MAS_3DModel/SMTSO20100.step
5.55 x 5.56 x 11.5 mm
