MuratovAS/KiCadLibrary/MAS_3DModel/SMTSO2025.step

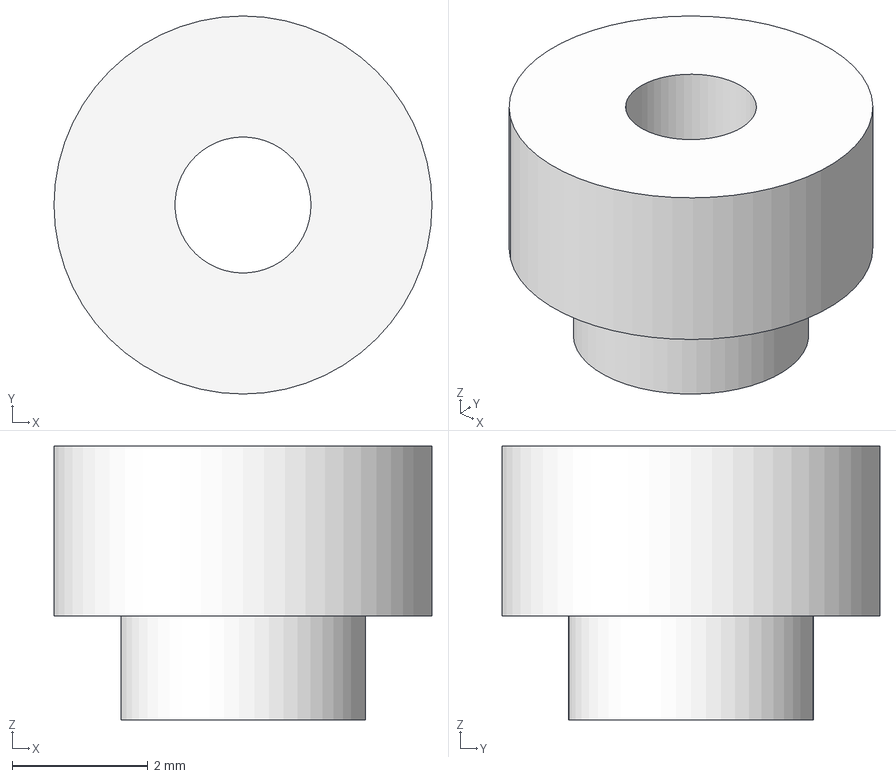
[picture p74: CAD file, 2025-03-26]
MAS_3DModel/SMTSO2025.step
5.56 x 5.56 x 4.03 mm
