MuratovAS/KiCadLibrary/MAS_3DModel/SMTSO2035.step

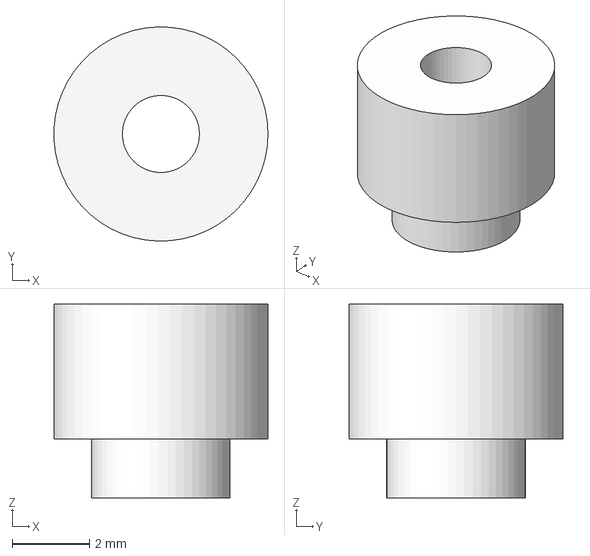
[picture p75: CAD file, 2025-03-26]
MAS_3DModel/SMTSO2035.step
5.56 x 5.56 x 5.03 mm
