MuratovAS/KiCadLibrary/MAS_3DModel/SMTSO2055.step

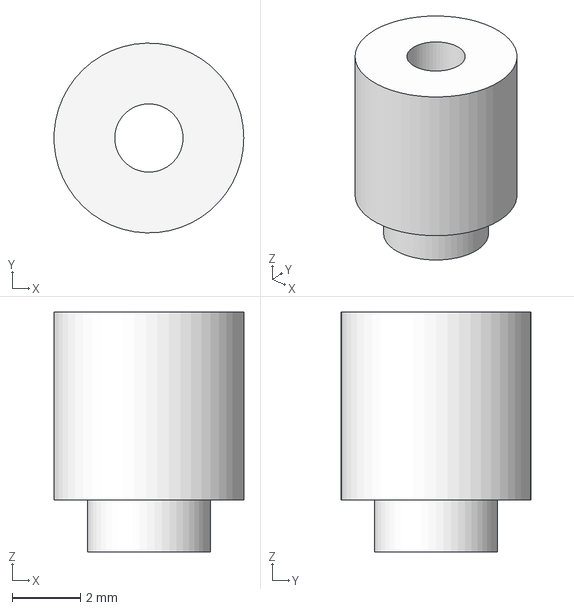
[picture p76: CAD file, 2025-03-26]
MAS_3DModel/SMTSO2055.step
5.55 x 5.56 x 7.03 mm
