MuratovAS/KiCadLibrary/MAS_3DModel/SMTSO2005.step

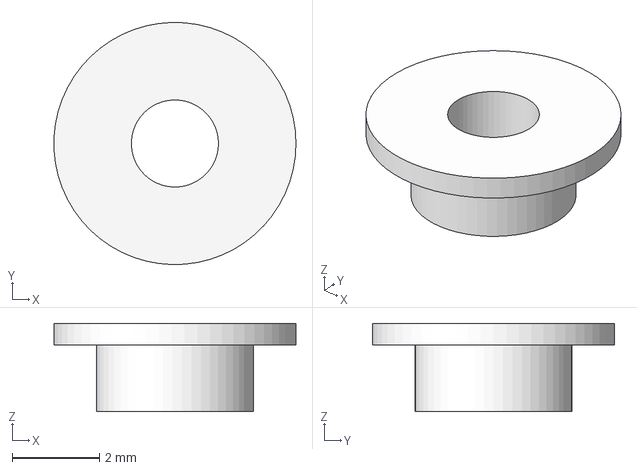
[picture p78: CAD file, 2025-03-26]
MAS_3DModel/SMTSO2005.step
5.56 x 5.56 x 2.03 mm
