MuratovAS/KiCadLibrary/MAS_3DModel/SMTSO2060.step

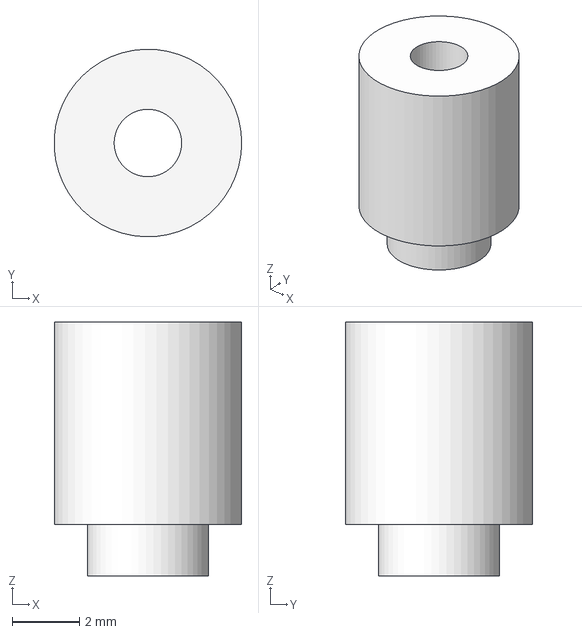
[picture p80: CAD file, 2025-03-26]
MAS_3DModel/SMTSO2060.step
5.55 x 5.56 x 7.53 mm
