MuratovAS/KiCadLibrary/MAS_3DModel/SMTSO2080.step

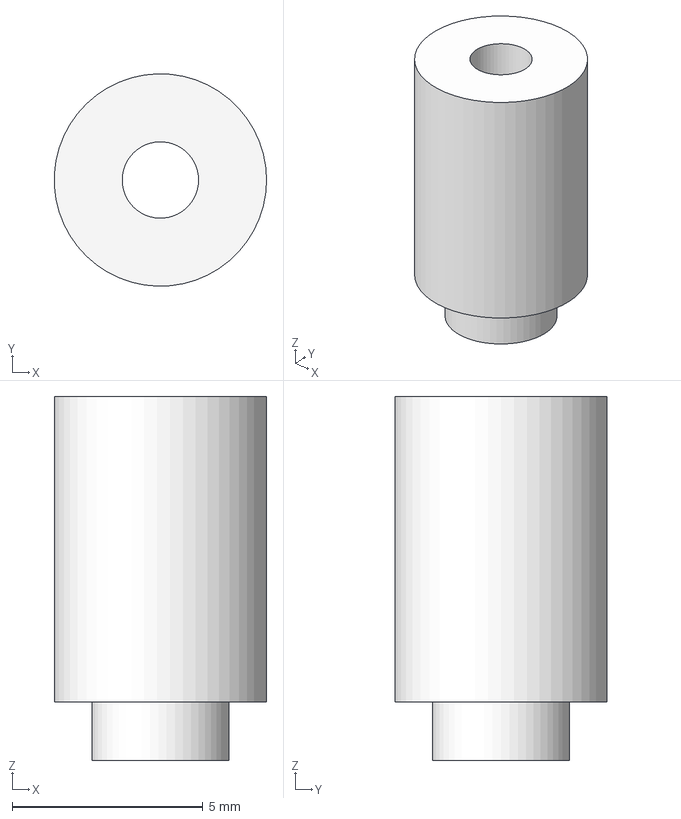
[picture p81: CAD file, 2025-03-26]
MAS_3DModel/SMTSO2080.step
5.55 x 5.56 x 9.53 mm
