MuratovAS/KiCadLibrary/MAS_3DModel/QSH-060-01-x-x.step

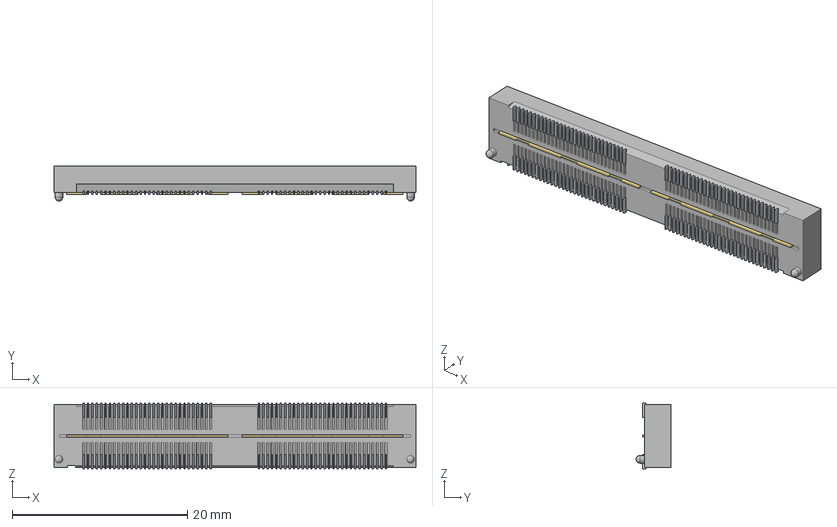
[picture p83: CAD file, 2025-02-28]
MAS_3DModel/QSH-060-01-x-x.step
41.3 x 4.00 x 7.49 mm
TQSH-060-01-D-A_terminal
T-1G2-01-060 x 2
C-126-21-060-D-L x 2
C-126-21-060-D-F2 x 2
