MuratovAS/KiCadLibrary/MAS_3DModel/QTH-060-01-x-x.step

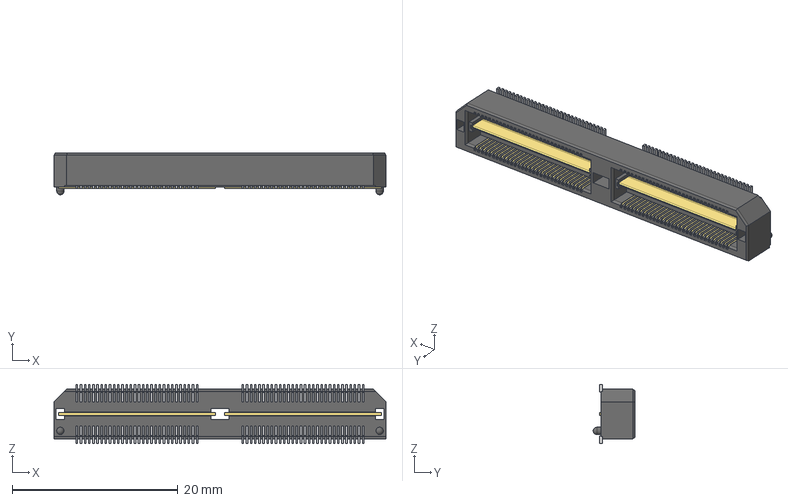
[picture p84: CAD file, 2025-02-28]
MAS_3DModel/QTH-060-01-x-x.step
40.0 x 5.03 x 7.11 mm
TQTH-060-01-L-D-A_terminal
T-1S39-01(-060-01-D-L)_pin x 2
T-1S39-01(-060-01-D)_pin2 x 2
T-1G1-01_imp x 2
