MuratovAS/KiCadLibrary/MAS_3DModel/WR-MCX_Wuerth_60612102111406_Vertical.step

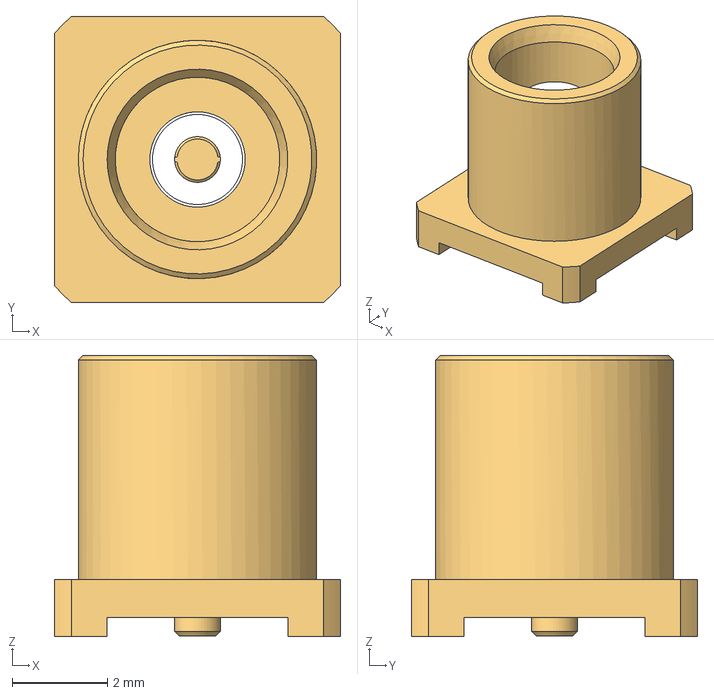
[picture p85: CAD file, 2025-02-19]
MAS_3DModel/WR-MCX_Wuerth_60612102111406_Vertical.step
6.00 x 6.00 x 5.90 mm
