MuratovAS/KiCadLibrary/MAS_3DModel/BL-M8812EU2.step

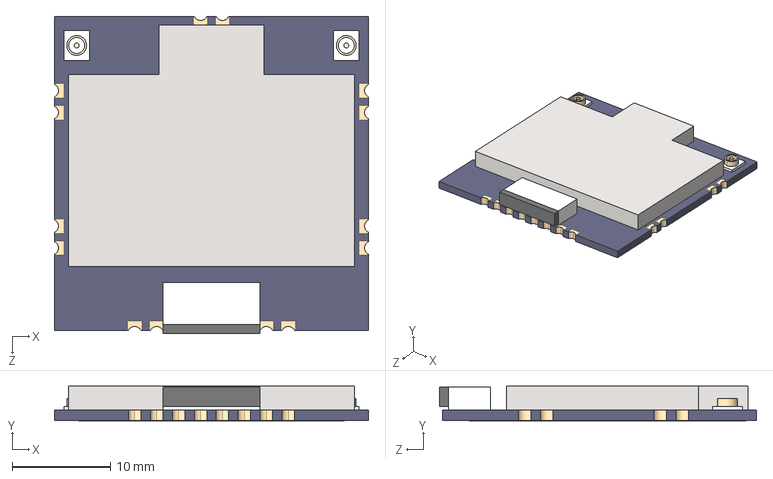
[picture p86: CAD file, 2025-01-21]
MAS_3DModel/BL-M8812EU2.step
32.0 x 3.53 x 32.3 mm
