MuratovAS/KiCadLibrary/MAS_3DModel/ANT_patch_25x25mm_4mm.step

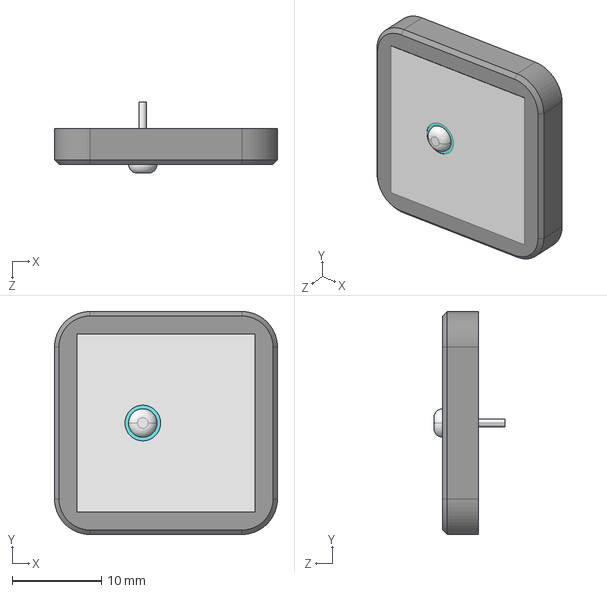
[picture p87: CAD file, 2025-01-16]
MAS_3DModel/ANT_patch_25x25mm_4mm.step
25.0 x 25.0 x 8.00 mm
