MuratovAS/KiCadLibrary/MAS_3DModel/sh1.0_9pin_hori.step

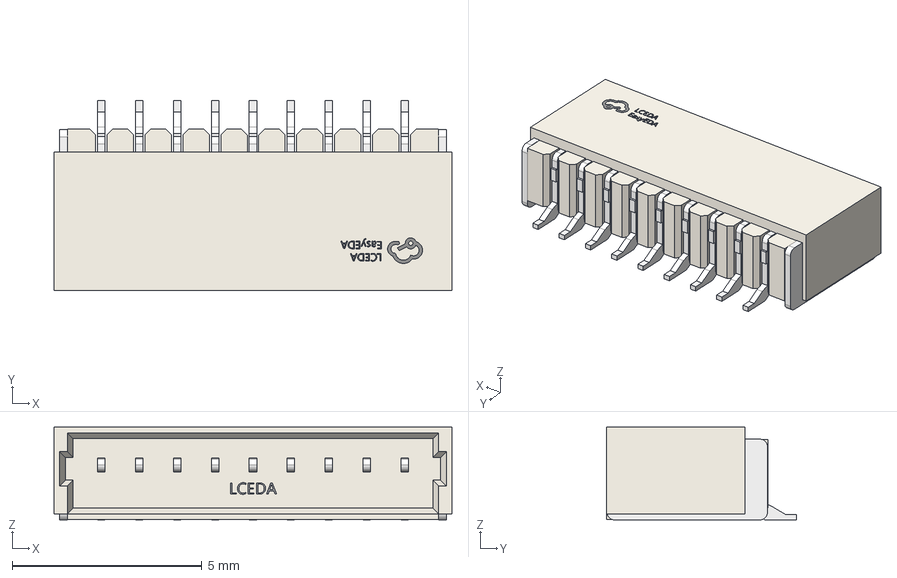
[picture p88: CAD file, 2025-01-05]
MAS_3DModel/sh1.0_9pin_hori.step
10.5 x 5.00 x 2.45 mm
