MuratovAS/KiCadLibrary/MAS_3DModel/sh1.0_8pin_hori.step

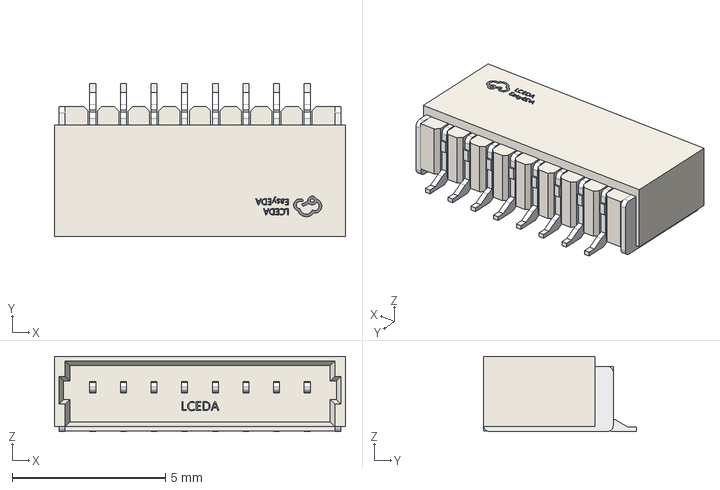
[picture p89: CAD file, 2025-01-05]
MAS_3DModel/sh1.0_8pin_hori.step
9.50 x 5.00 x 2.45 mm
