MuratovAS/KiCadLibrary/MAS_3DModel/sh1.0_5pin_hori.step

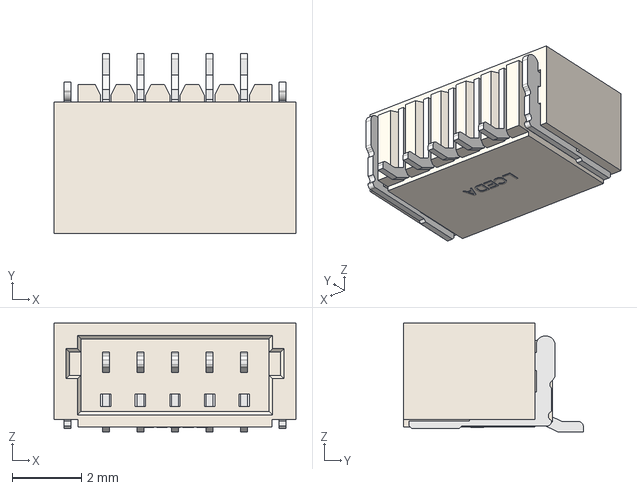
[picture p90: CAD file, 2025-01-05]
MAS_3DModel/sh1.0_5pin_hori.step
7.00 x 5.20 x 3.14 mm
