MuratovAS/KiCadLibrary/MAS_3DModel/sh1.0_6pin_hori.step

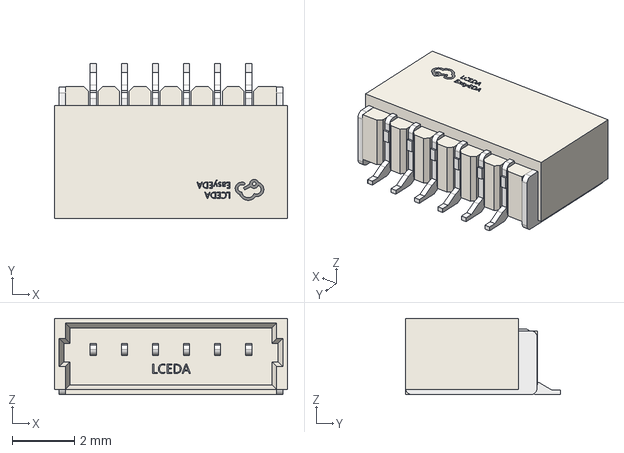
[picture p91: CAD file, 2025-01-05]
MAS_3DModel/sh1.0_6pin_hori.step
7.50 x 5.00 x 2.45 mm
