MuratovAS/KiCadLibrary/MAS_3DModel/sh1.0_3pin_hori.step

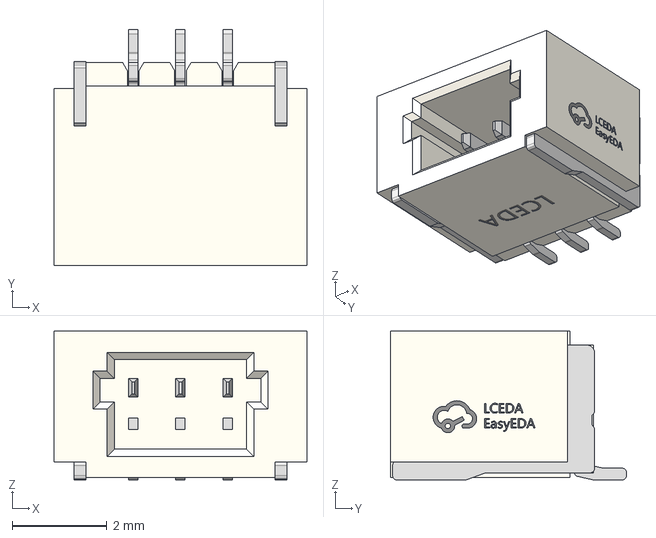
[picture p92: CAD file, 2025-01-05]
MAS_3DModel/sh1.0_3pin_hori.step
5.35 x 5.00 x 3.15 mm
