MuratovAS/KiCadLibrary/MAS_3DModel/sh1.0_2pin_hori.step

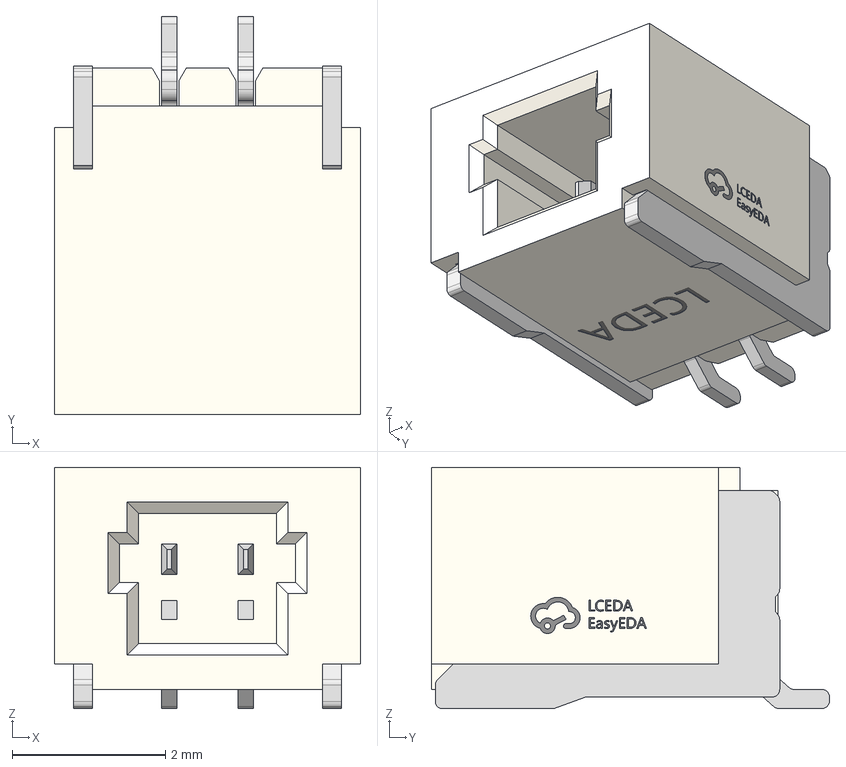
[picture p93: CAD file, 2025-01-05]
MAS_3DModel/sh1.0_2pin_hori.step
4.00 x 5.20 x 3.15 mm
