MuratovAS/KiCadLibrary/MAS_3DModel/sh1.0_4pin_hori.step

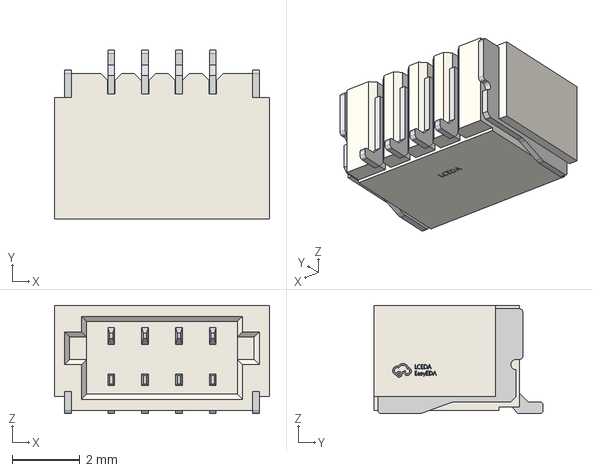
[picture p94: CAD file, 2025-01-05]
MAS_3DModel/sh1.0_4pin_hori.step
6.35 x 5.00 x 3.20 mm
