MuratovAS/KiCadLibrary/MAS_3DModel/LGA16_4.5x3mm_P0.5mm.step

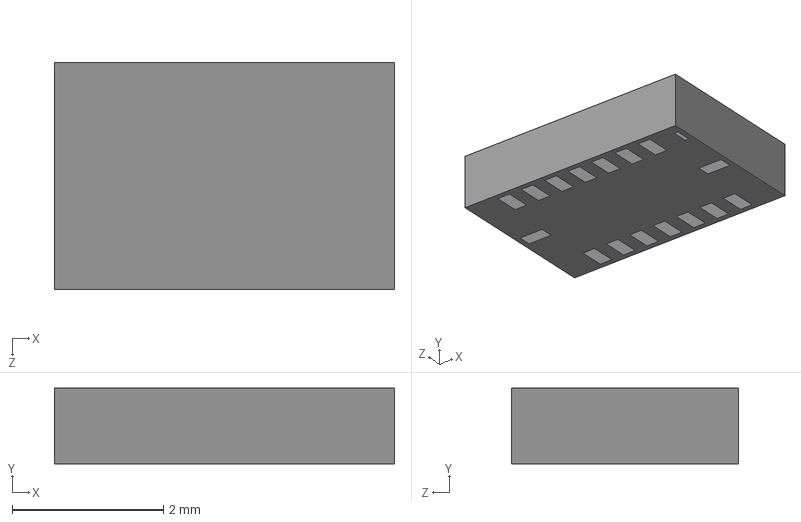
[picture p95: CAD file, 2025-01-04]
MAS_3DModel/LGA16_4.5x3mm_P0.5mm.step
4.50 x 1.00 x 3.00 mm
