MuratovAS/KiCadLibrary/MAS_3DModel/ublox-MAX.step

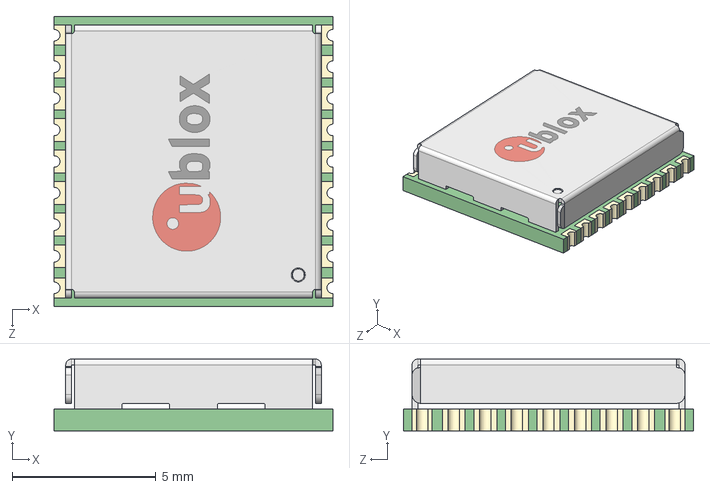
[picture p96: CAD file, 2024-11-24]
MAS_3DModel/ublox-MAX.step
9.70 x 2.50 x 10.1 mm
