MuratovAS/KiCadLibrary/MAS_3DModel/LED_WS2812B-2020_PLCC4_2.0x2.0mm.step

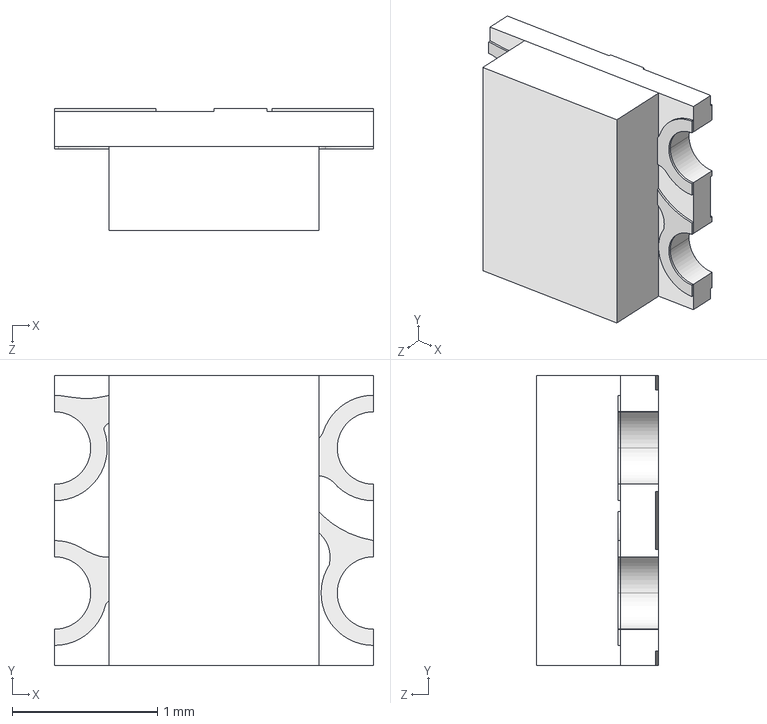
[picture p97: CAD file, 2024-11-24]
MAS_3DModel/LED_WS2812B-2020_PLCC4_2.0x2.0mm.step
2.20 x 2.00 x 0.84 mm
