MuratovAS/KiCadLibrary/MAS_3DModel/XT60PW-F.stp

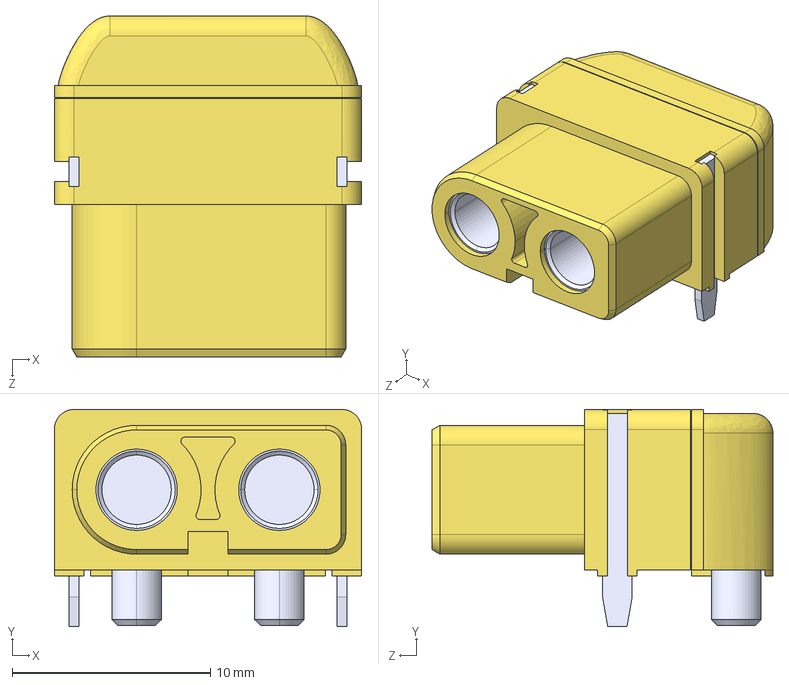
[picture p98: CAD file, 2024-10-01]
MAS_3DModel/XT60PW-F.stp
15.5 x 11.0 x 17.2 mm
