MuratovAS/KiCadLibrary/MAS_3DModel/XT60PW-M.stp

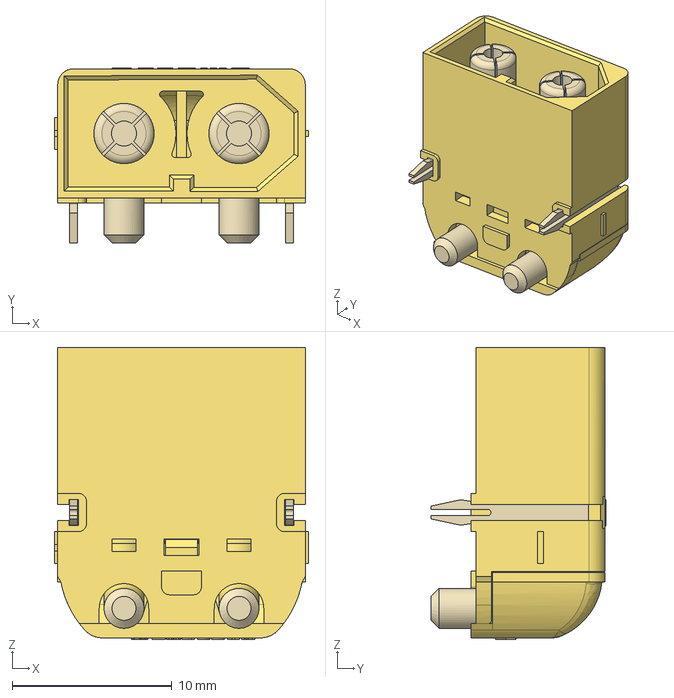
[picture p99: CAD file, 2024-10-01]
MAS_3DModel/XT60PW-M.stp
15.9 x 10.9 x 18.3 mm
