MuratovAS/KiCadLibrary/MAS_3DModel/QFN128_12.3x12.3_P0-35.step

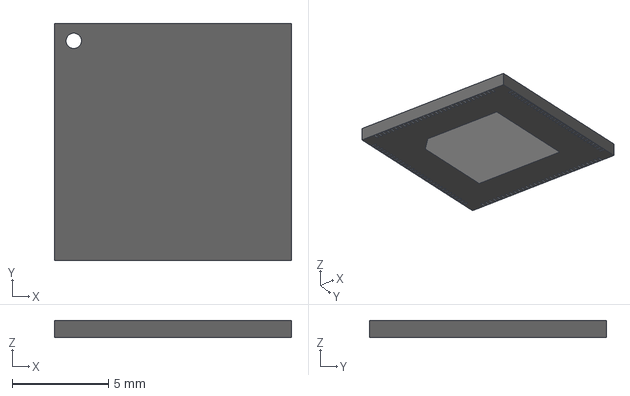
[picture p100: CAD file, 2024-09-30]
MAS_3DModel/QFN128_12.3x12.3_P0-35.step
12.3 x 12.3 x 0.9 mm
