MuratovAS/KiCadLibrary/MAS_3DModel/AP6XXX.step

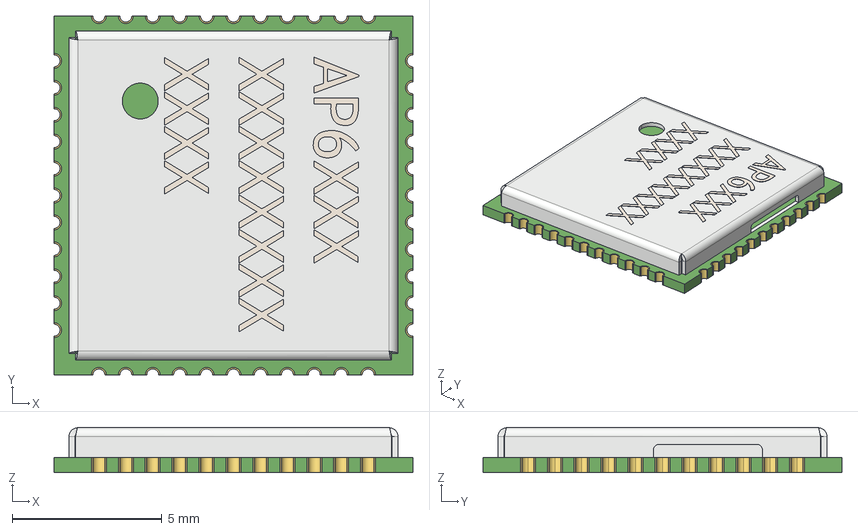
[picture p101: CAD file, 2024-09-30]
MAS_3DModel/AP6XXX.step
12.0 x 12.0 x 1.51 mm
185E063B-3784-4F4D-A59C-63DD5B6CB974
185E063B-3784-4F4D-A59C-63DD5B6CB975
185E063B-3784-4F4D-A59C-63DD5B6CB976
185E063B-3784-4F4D-A59C-63DD5B6CB977
185E063B-3784-4F4D-A59C-63DD5B6CB978
185E063B-3784-4F4D-A59C-63DD5B6CB979
185E063B-3784-4F4D-A59C-63DD5B6CB980
185E063B-3784-4F4D-A59C-63DD5B6CB981
185E063B-3784-4F4D-A59C-63DD5B6CB982
185E063B-3784-4F4D-A59C-63DD5B6CB983
185E063B-3784-4F4D-A59C-63DD5B6CB984
185E063B-3784-4F4D-A59C-63DD5B6CB985
185E063B-3784-4F4D-A59C-63DD5B6CB986
185E063B-3784-4F4D-A59C-63DD5B6CB987
185E063B-3784-4F4D-A59C-63DD5B6CB988
185E063B-3784-4F4D-A59C-63DD5B6CB989
185E063B-3784-4F4D-A59C-63DD5B6CB990
185E063B-3784-4F4D-A59C-63DD5B6CB991
185E063B-3784-4F4D-A59C-63DD5B6CB992
185E063B-3784-4F4D-A59C-63DD5B6CB993
185E063B-3784-4F4D-A59C-63DD5B6CB994
185E063B-3784-4F4D-A59C-63DD5B6CB995
185E063B-3784-4F4D-A59C-63DD5B6CB996
185E063B-3784-4F4D-A59C-63DD5B6CB997
185E063B-3784-4F4D-A59C-63DD5B6CB998
185E063B-3784-4F4D-A59C-63DD5B6CB999
185E063B-3784-4F4D-A59C-63DD5B6CB1000
185E063B-3784-4F4D-A59C-63DD5B6CB1001
185E063B-3784-4F4D-A59C-63DD5B6CB1002
185E063B-3784-4F4D-A59C-63DD5B6CB1003
185E063B-3784-4F4D-A59C-63DD5B6CB1004
185E063B-3784-4F4D-A59C-63DD5B6CB1005
185E063B-3784-4F4D-A59C-63DD5B6CB1006
185E063B-3784-4F4D-A59C-63DD5B6CB1007
185E063B-3784-4F4D-A59C-63DD5B6CB1008
185E063B-3784-4F4D-A59C-63DD5B6CB1009
185E063B-3784-4F4D-A59C-63DD5B6CB1010
185E063B-3784-4F4D-A59C-63DD5B6CB1011
185E063B-3784-4F4D-A59C-63DD5B6CB1012
185E063B-3784-4F4D-A59C-63DD5B6CB1013
185E063B-3784-4F4D-A59C-63DD5B6CB1014
185E063B-3784-4F4D-A59C-63DD5B6CB1015
185E063B-3784-4F4D-A59C-63DD5B6CB1016
185E063B-3784-4F4D-A59C-63DD5B6CB1017
185E063B-3784-4F4D-A59C-63DD5B6CB1018
185E063B-3784-4F4D-A59C-63DD5B6CB1025
