MuratovAS/KiCadLibrary/MAS_3DModel/HDMI_A_horizontal.step

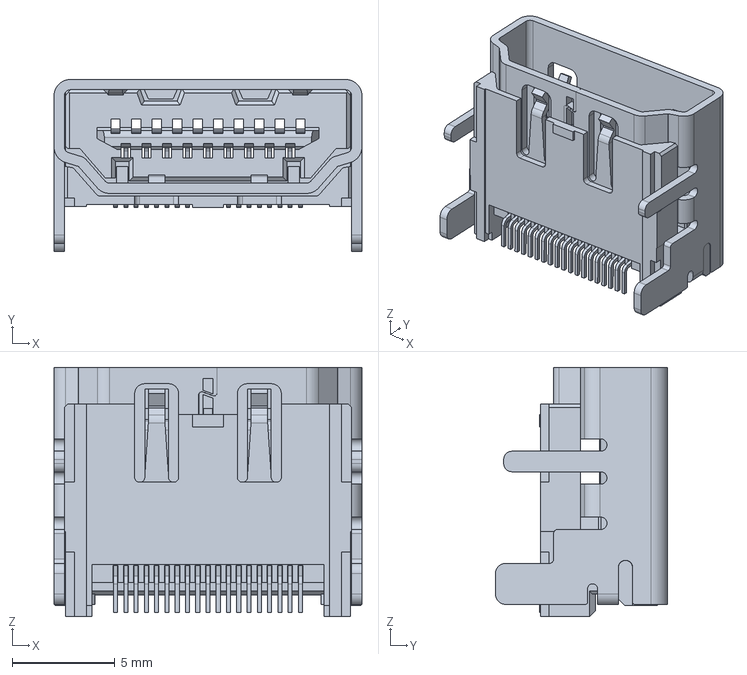
[picture p102: CAD file, 2024-09-29]
MAS_3DModel/HDMI_A_horizontal.step
15.0 x 8.38 x 12.2 mm
