MuratovAS/KiCadLibrary/MAS_3DModel/USB_A_XUNPU_Horizontal_Stacked.step

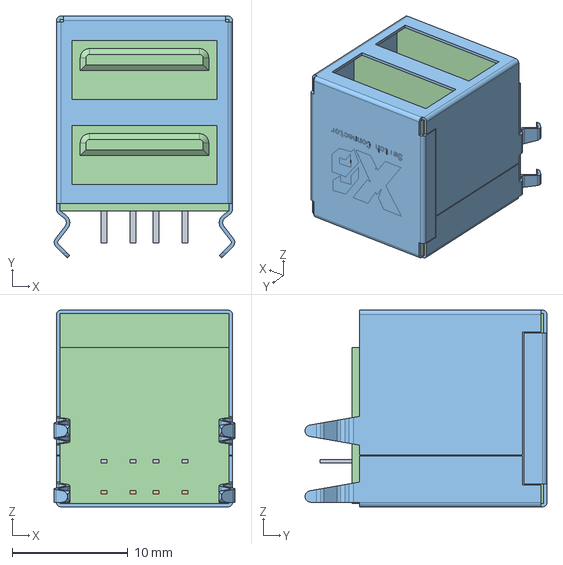
[picture p103: CAD file, 2024-09-24]
MAS_3DModel/USB_A_XUNPU_Horizontal_Stacked.step
15.6 x 20.9 x 17.0 mm
