MuratovAS/KiCadLibrary/MAS_3DModel/DF40C_24DS_0-4V.step

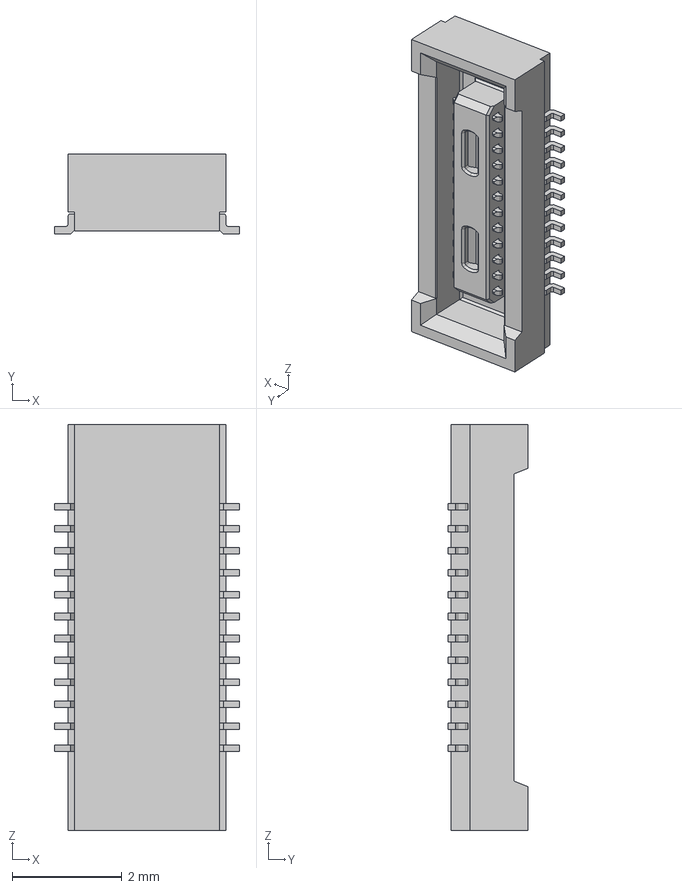
[picture p104: CAD file, 2024-08-24]
MAS_3DModel/DF40C_24DS_0-4V.step
3.38 x 1.45 x 7.40 mm
