MuratovAS/KiCadLibrary/MAS_3DModel/DF40C_24DP_0-4V.step

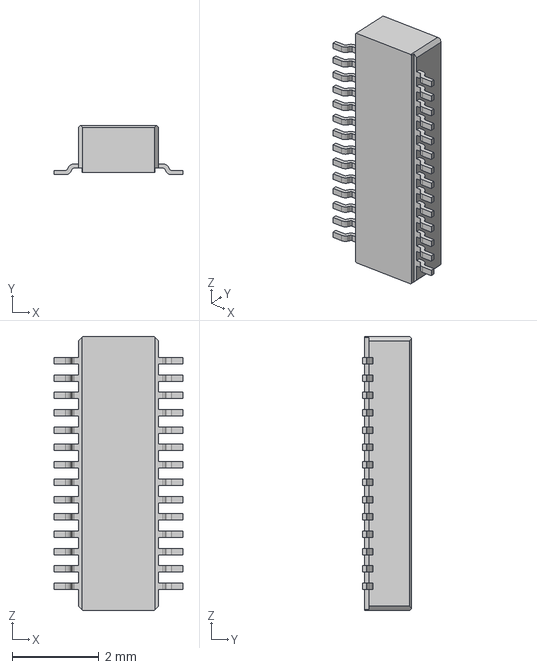
[picture p105: CAD file, 2024-08-24]
MAS_3DModel/DF40C_24DP_0-4V.step
2.97 x 1.14 x 6.32 mm
