MuratovAS/KiCadLibrary/MAS_3DModel/HLK-7688A.step

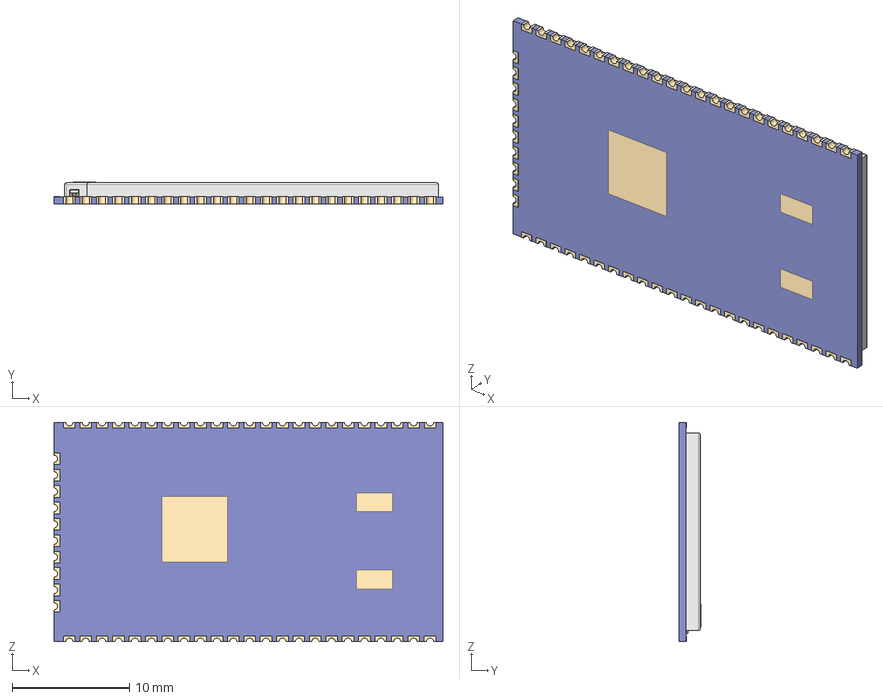
[picture p107: CAD file, 2024-06-27]
MAS_3DModel/HLK-7688A.step
33.2 x 1.87 x 18.7 mm
u.Fl Antenna Connector - 523-A-1JB
