MuratovAS/KiCadLibrary/MAS_3DModel/PinSocket_2x04_P2.00mm_Horizontal_SMD.stp

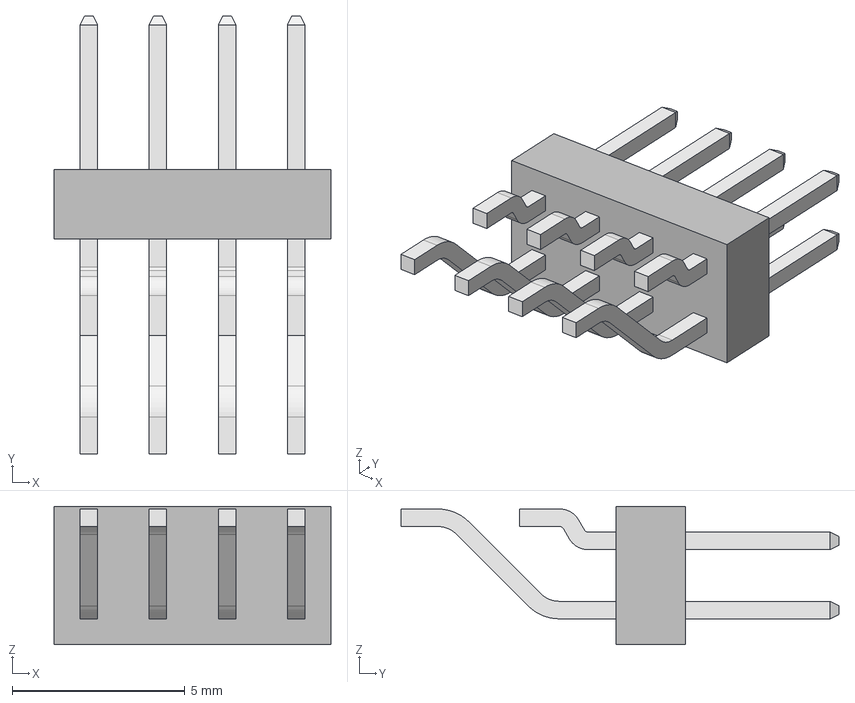
[picture p108: CAD file, 2024-05-16]
MAS_3DModel/PinSocket_2x04_P2.00mm_Horizontal_SMD.stp
8.00 x 12.7 x 4.00 mm
MMT-104-02-T-DH_pins
MMT-104-02-T-DH_body
MMT-104-02-T-DH_PIN2
