MuratovAS/KiCadLibrary/MAS_3DModel/DF40HC(4.0)-60DS.step

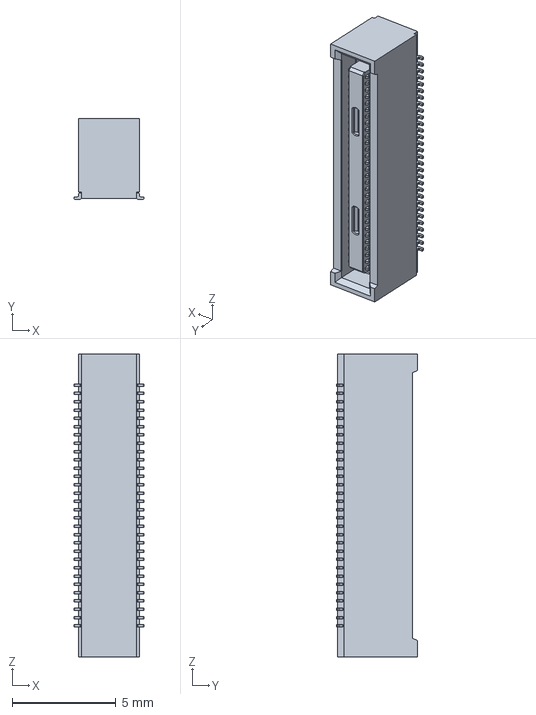
[picture p109: CAD file, 2024-05-15]
MAS_3DModel/DF40HC(4.0)-60DS.step
3.38 x 3.90 x 14.6 mm
