MuratovAS/KiCadLibrary/MAS_3DModel/xt30u-m.step

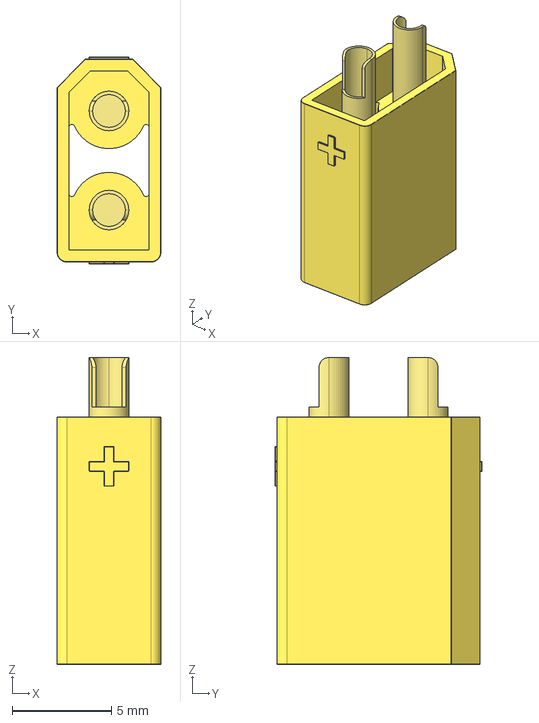
[picture p110: CAD file, 2024-04-22]
MAS_3DModel/xt30u-m.step
5.25 x 10.4 x 15.5 mm
