MuratovAS/KiCadLibrary/MAS_3DModel/xt30u-f.step

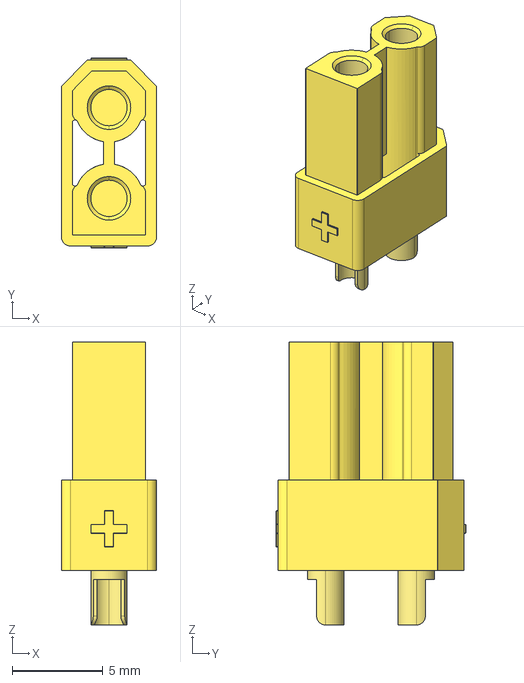
[picture p111: CAD file, 2024-04-22]
MAS_3DModel/xt30u-f.step
5.25 x 10.4 x 15.6 mm
