MuratovAS/KiCadLibrary/MAS_3DModel/Molex_Mini-Fit_Jr_15-24-7043_2x02_P4.20mm_Vertical.stp

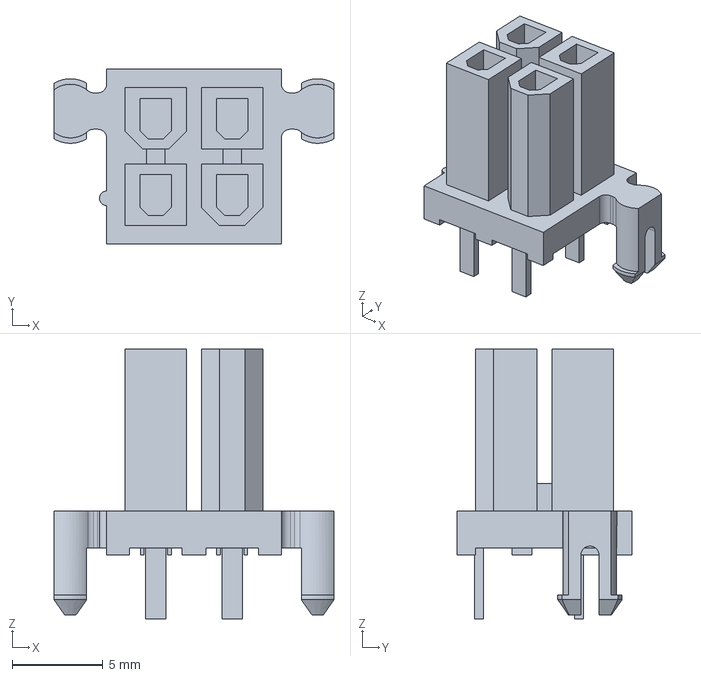
[picture p112: CAD file, 2024-03-20]
MAS_3DModel/Molex_Mini-Fit_Jr_15-24-7043_2x02_P4.20mm_Vertical.stp
15.4 x 9.60 x 14.8 mm
