MuratovAS/KiCadLibrary/MAS_3DModel/Molex_Micro-Fit_3.0_44769-0401_2x02_P3.00mm_Vertical.stp

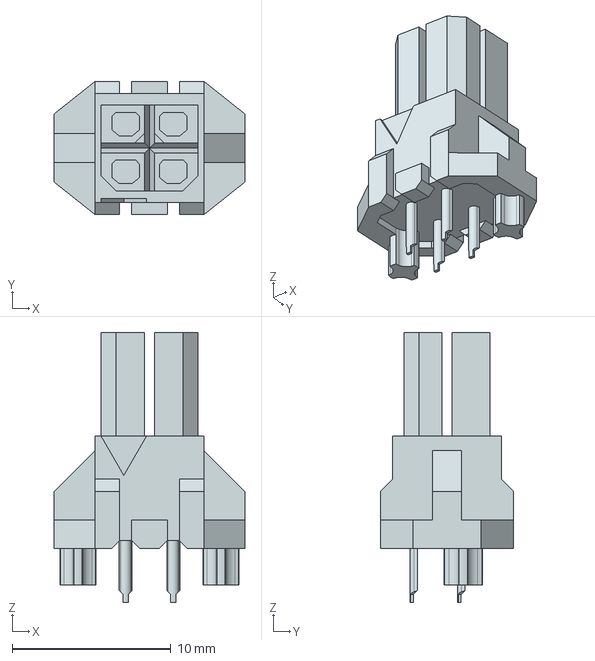
[picture p113: CAD file, 2024-03-20]
MAS_3DModel/Molex_Micro-Fit_3.0_44769-0401_2x02_P3.00mm_Vertical.stp
12.0 x 8.40 x 17.0 mm
