MuratovAS/KiCadLibrary/MAS_3DModel/AYZ0202AGRLC.STEP

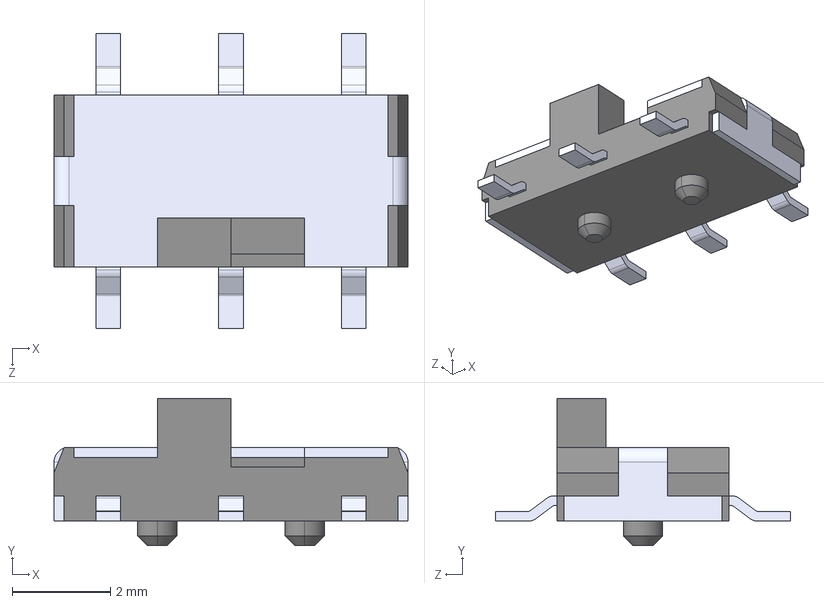
[picture p114: CAD file, 2024-03-18]
MAS_3DModel/AYZ0202AGRLC.STEP
7.20 x 3.00 x 6.00 mm
