MuratovAS/KiCadLibrary/MAS_3DModel/HDMI_A_Kycon_KDMIX-SL1-NS-WS-B15_VerticalRightAngle.step

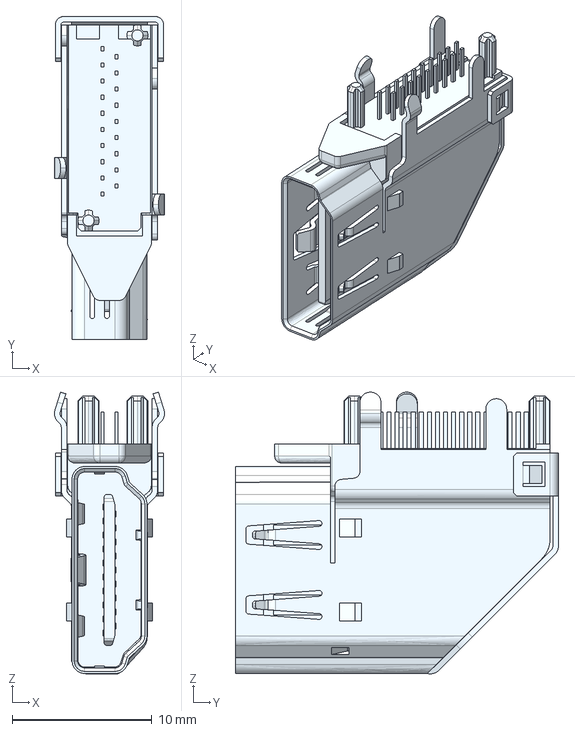
[picture p115: CAD file, 2024-03-11]
MAS_3DModel/HDMI_A_Kycon_KDMIX-SL1-NS-WS-B15_VerticalRightAngle.step
7.88 x 23.1 x 20.1 mm
