MuratovAS/KiCadLibrary/MAS_3DModel/HDC1080.step

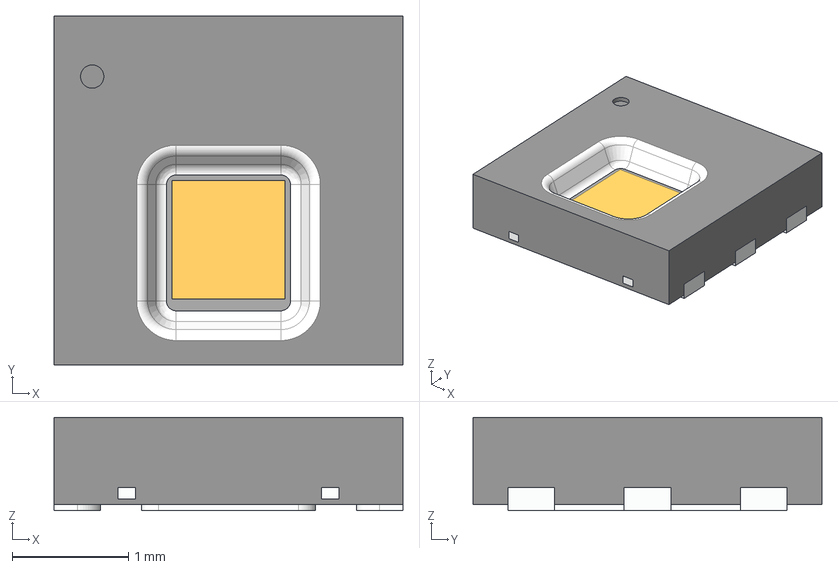
[picture p116: CAD file, 2024-02-19]
MAS_3DModel/HDC1080.step
3.00 x 3.00 x 0.8 mm
BODY-SON_118_1
FRAME-DMB0006A_77_1_1
FRAME-DMB0006A_77_2_1
FRAME-DMB0006A_77_3_1
FRAME-DMB0006A_77_4_1
FRAME-DMB0006A_77_5_1
FRAME-DMB0006A_77_6_1
FRAME-DMB0006A_77_7_1
DIE_1_1
