MuratovAS/KiCadLibrary/MAS_3DModel/PinSocket_2x05_P2.00mm_End.step

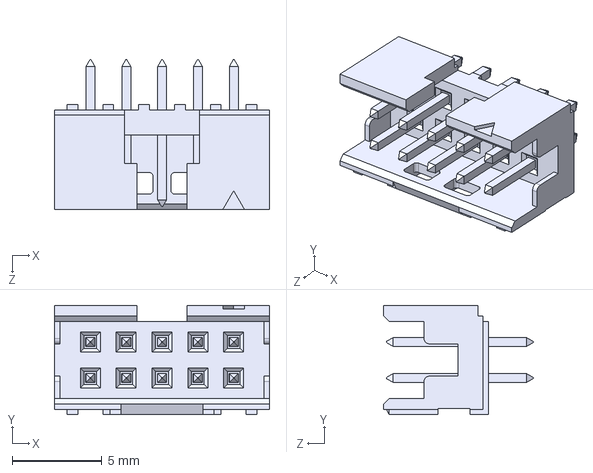
[picture p117: CAD file, 2024-02-19]
MAS_3DModel/PinSocket_2x05_P2.00mm_End.step
12.0 x 6.10 x 8.35 mm
