MuratovAS/KiCadLibrary/MAS_3DModel/VPT87D.step

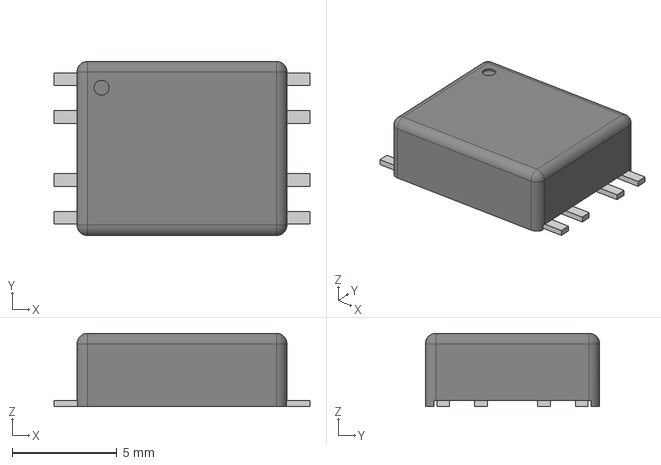
[picture p118: CAD file, 2024-02-10]
MAS_3DModel/VPT87D.step
12.2 x 8.30 x 3.50 mm
