MuratovAS/KiCadLibrary/MAS_3DModel/Piez_9.6x9.6mm.step

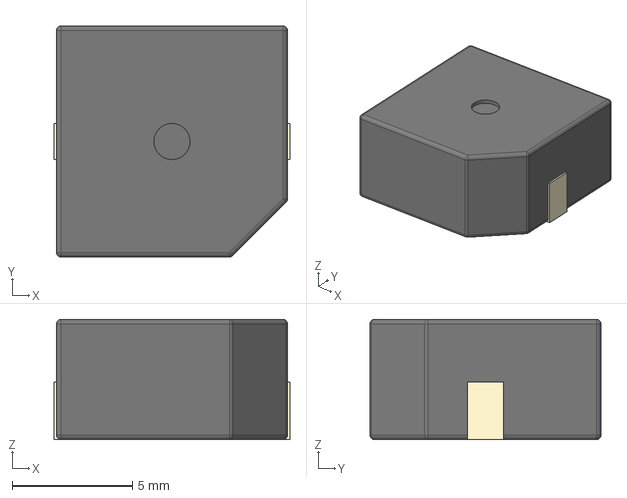
[picture p119: CAD file, 2024-02-08]
MAS_3DModel/Piez_9.6x9.6mm.step
9.80 x 9.60 x 5.00 mm
Pins
