MuratovAS/KiCadLibrary/MAS_3DModel/WJ25C-B-7.62-6P.step

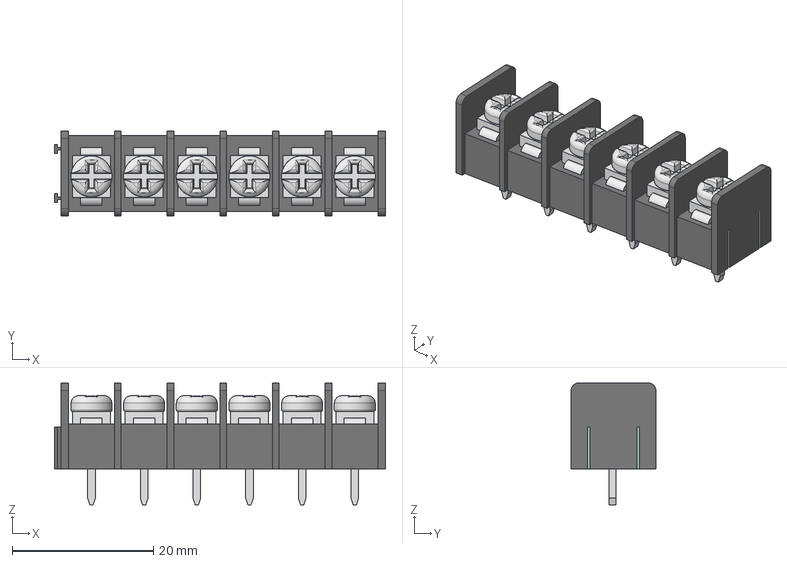
[picture p120: CAD file, 2024-01-08]
MAS_3DModel/WJ25C-B-7.62-6P.step
46.9 x 12.0 x 17.3 mm
