MuratovAS/KiCadLibrary/MAS_3DModel/JUSHUO_AFC07-S10ECC-00_1x10-1MP_P0.50mm_Horizontal.step

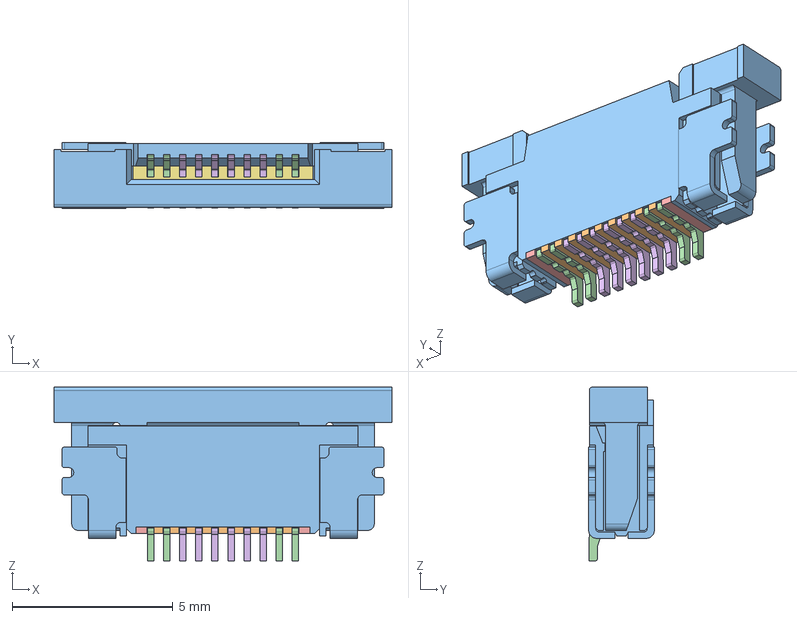
[picture p121: CAD file, 2023-11-28]
MAS_3DModel/JUSHUO_AFC07-S10ECC-00_1x10-1MP_P0.50mm_Horizontal.step
10.5 x 2.04 x 5.40 mm
