MuratovAS/KiCadLibrary/MAS_3DModel/SQP25.STEP

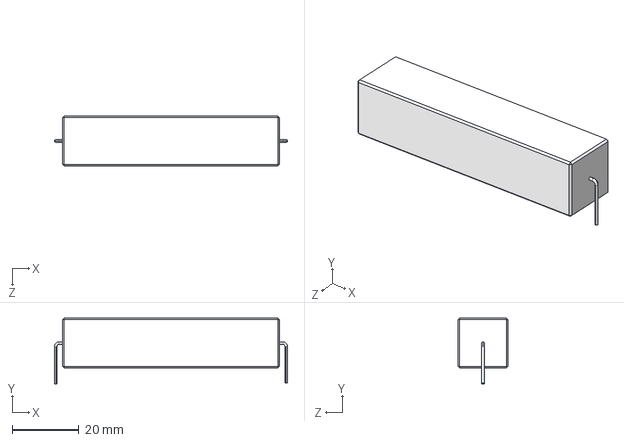
[picture p122: CAD file, 2023-10-29]
MAS_3DModel/SQP25.STEP
69.8 x 19.7 x 15.0 mm
