MuratovAS/KiCadLibrary/MAS_3DModel/ADIS1647x.step

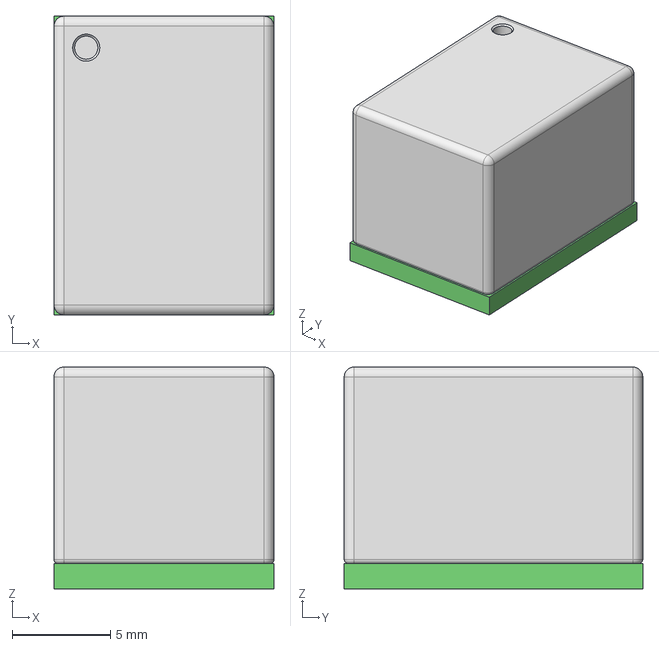
[picture p123: CAD file, 2023-10-25]
MAS_3DModel/ADIS1647x.step
11.2 x 15.2 x 11.3 mm
