MuratovAS/KiCadLibrary/MAS_3DModel/LGA-10_2x2x0.75mm_P0.5mm.step

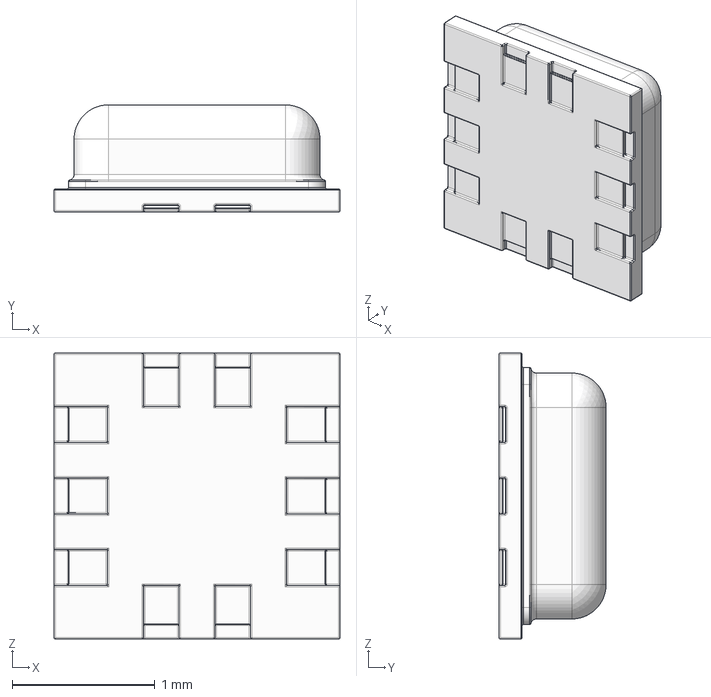
[picture p124: CAD file, 2023-10-25]
MAS_3DModel/LGA-10_2x2x0.75mm_P0.5mm.step
2.00 x 0.75 x 2.00 mm
