MuratovAS/KiCadLibrary/MAS_3DModel/PinHeader_3x1_P2.54mm_Horizontal.step

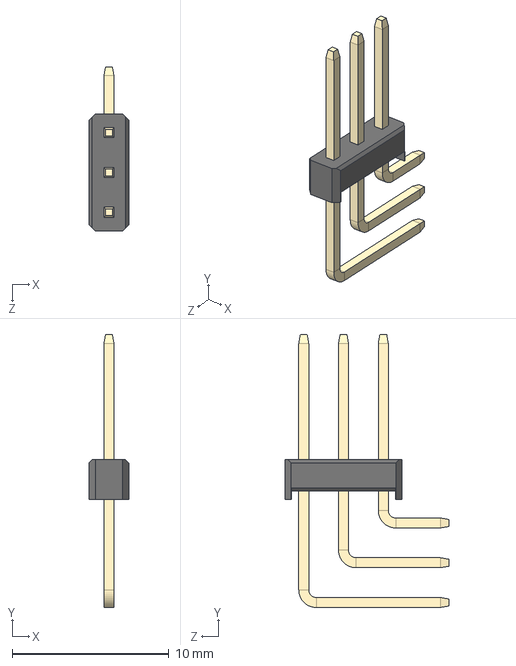
[picture p125: CAD file, 2023-10-08]
MAS_3DModel/PinHeader_3x1_P2.54mm_Horizontal.step
2.55 x 17.4 x 10.5 mm
