MuratovAS/KiCadLibrary/MAS_3DModel/PinHeader_3x15_P2.54mm_Horizontal.step

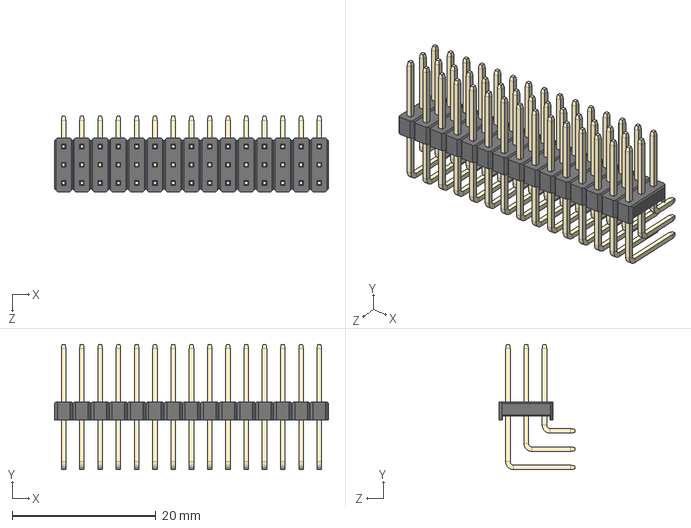
[picture p126: CAD file, 2023-10-08]
MAS_3DModel/PinHeader_3x15_P2.54mm_Horizontal.step
38.1 x 17.4 x 10.5 mm
