MuratovAS/KiCadLibrary/MAS_3DModel/Slide-SW_SPDT.step

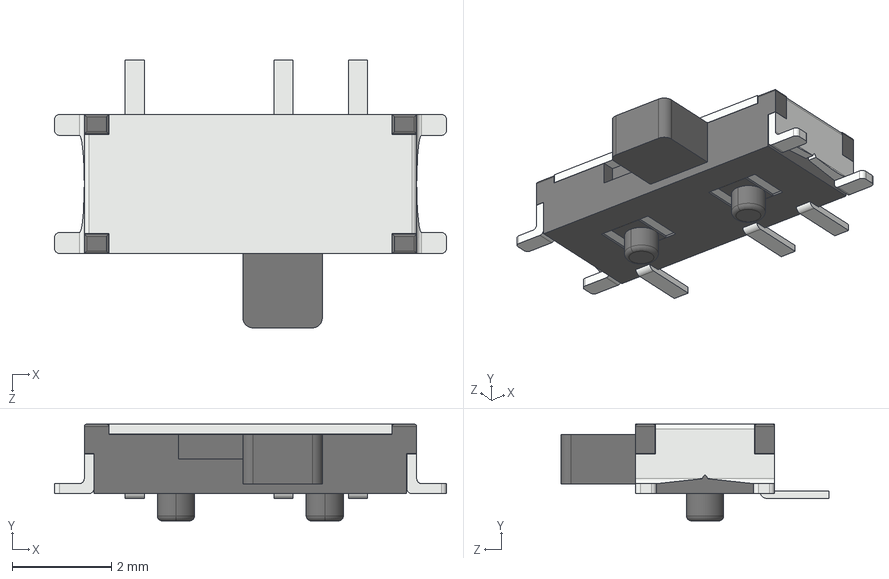
[picture p127: CAD file, 2023-10-03]
MAS_3DModel/Slide-SW_SPDT.step
7.90 x 1.95 x 5.39 mm
