MuratovAS/KiCadLibrary/MAS_3DModel/Potentiometer_Bourns_3224W_Vertical.step

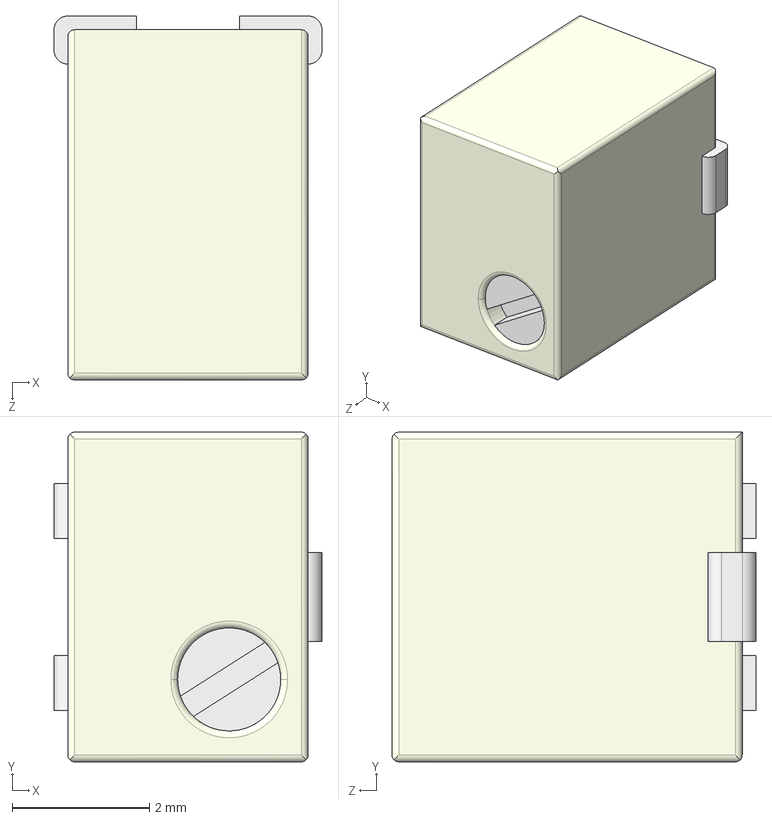
[picture p128: CAD file, 2023-10-03]
MAS_3DModel/Potentiometer_Bourns_3224W_Vertical.step
3.90 x 4.80 x 5.30 mm
