MuratovAS/KiCadLibrary/MAS_3DModel/DF40C_100DP_0-4V.step

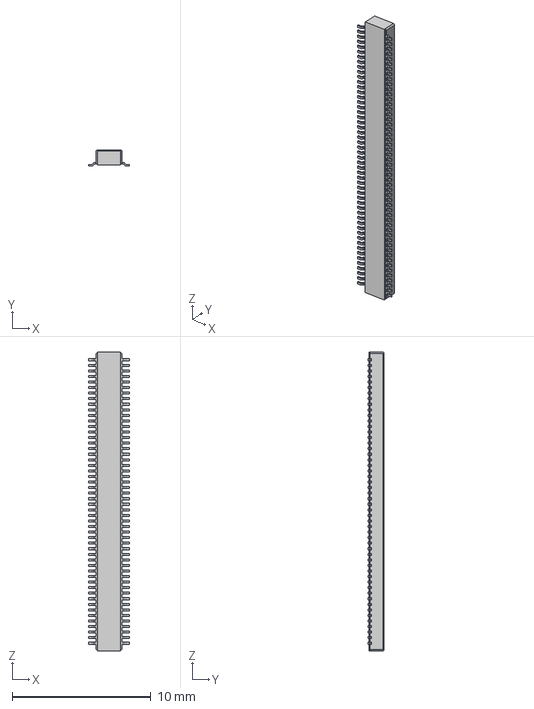
[picture p131: CAD file, 2023-09-25]
MAS_3DModel/DF40C_100DP_0-4V.step
2.97 x 1.14 x 21.5 mm
