MuratovAS/KiCadLibrary/MAS_3DModel/DF40C_70DS_0-4V.step

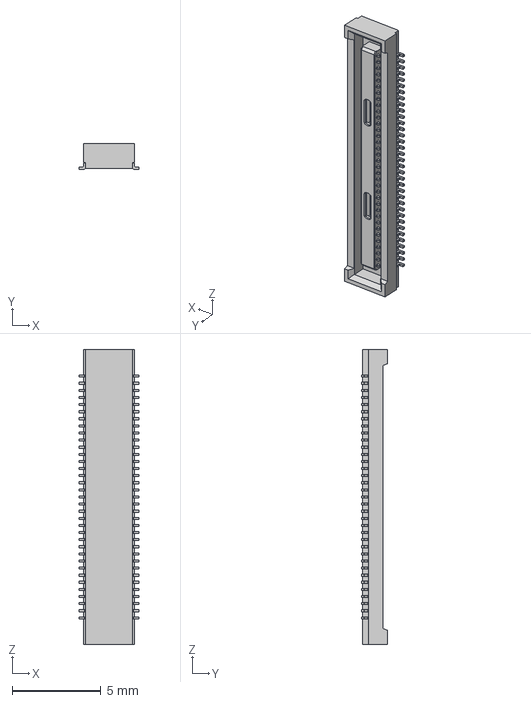
[picture p132: CAD file, 2023-09-25]
MAS_3DModel/DF40C_70DS_0-4V.step
3.38 x 1.45 x 16.6 mm
