MuratovAS/KiCadLibrary/MAS_3DModel/DF40C_50DP_0-4V.step

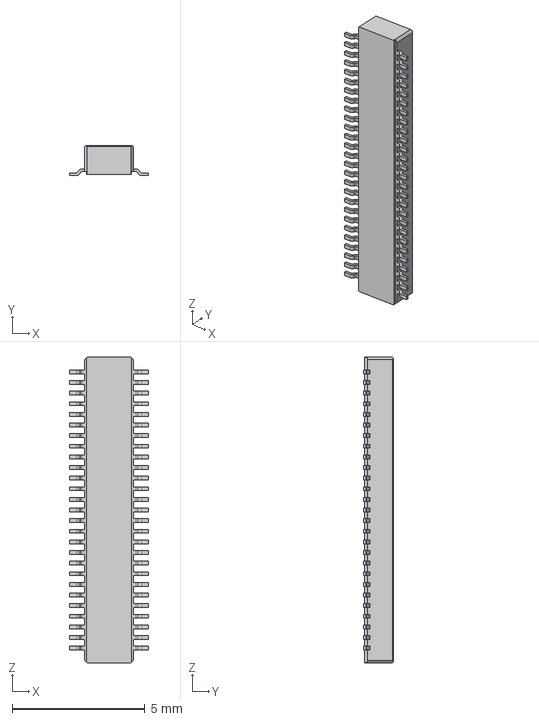
[picture p133: CAD file, 2023-09-25]
MAS_3DModel/DF40C_50DP_0-4V.step
2.97 x 1.14 x 11.5 mm
