MuratovAS/KiCadLibrary/MAS_3DModel/DF40C_30DS_0-4V.step

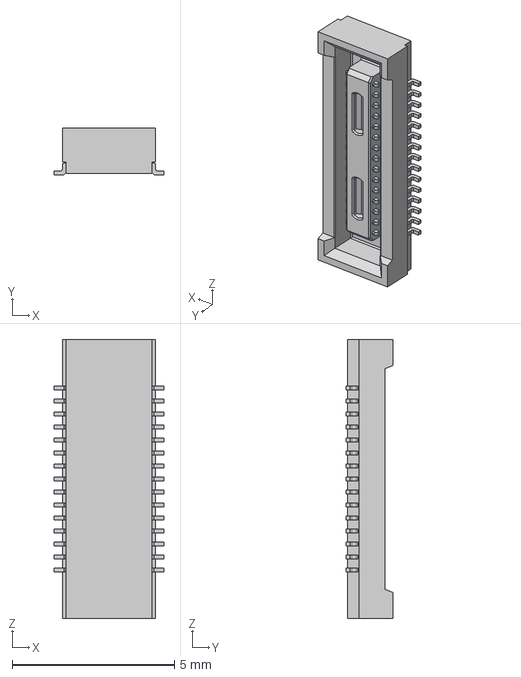
[picture p134: CAD file, 2023-09-25]
MAS_3DModel/DF40C_30DS_0-4V.step
3.38 x 1.45 x 8.60 mm
