MuratovAS/KiCadLibrary/MAS_3DModel/DF40C_60DS_0-4V.step

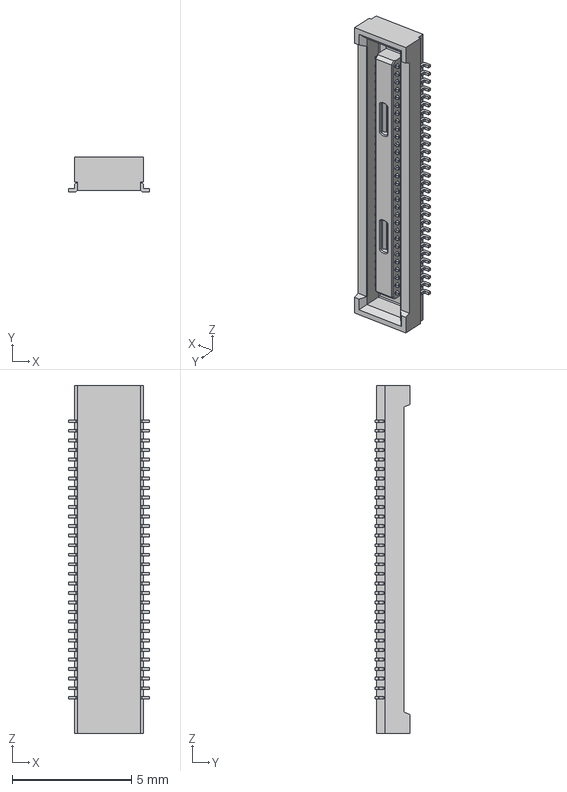
[picture p136: CAD file, 2023-09-25]
MAS_3DModel/DF40C_60DS_0-4V.step
3.38 x 1.45 x 14.6 mm
