MuratovAS/KiCadLibrary/MAS_3DModel/DF40C_30DP_0-4V.step

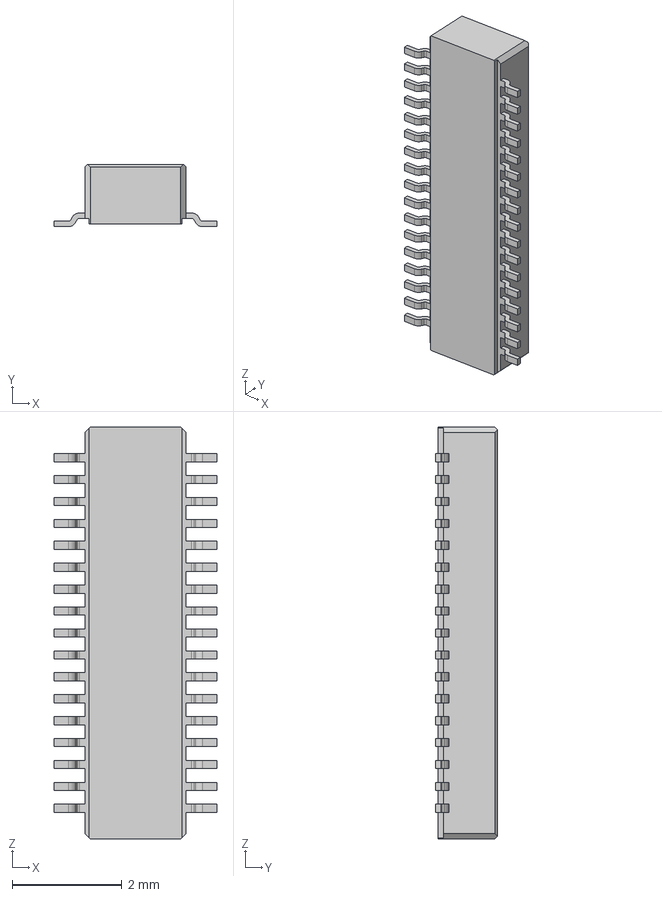
[picture p138: CAD file, 2023-09-25]
MAS_3DModel/DF40C_30DP_0-4V.step
2.97 x 1.14 x 7.52 mm
