MuratovAS/KiCadLibrary/MAS_3DModel/DF40C_90DS_0-4V.step

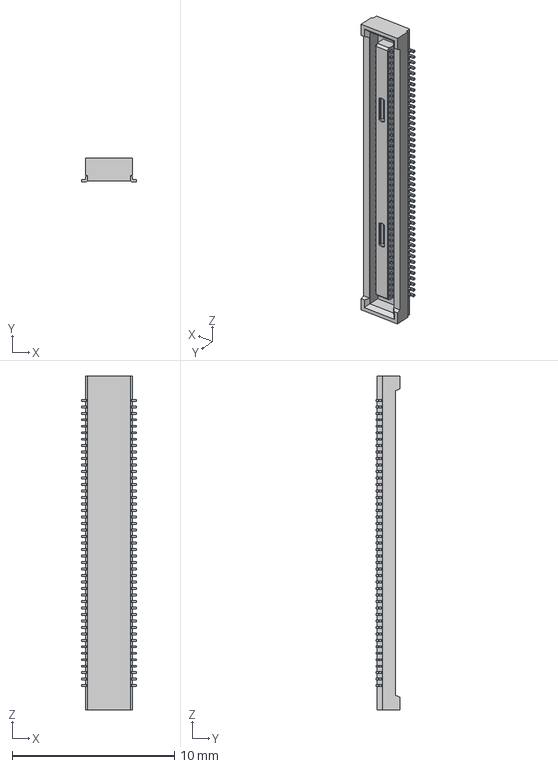
[picture p141: CAD file, 2023-09-25]
MAS_3DModel/DF40C_90DS_0-4V.step
3.38 x 1.45 x 20.6 mm
