MuratovAS/KiCadLibrary/MAS_3DModel/RTL8188CUS.step

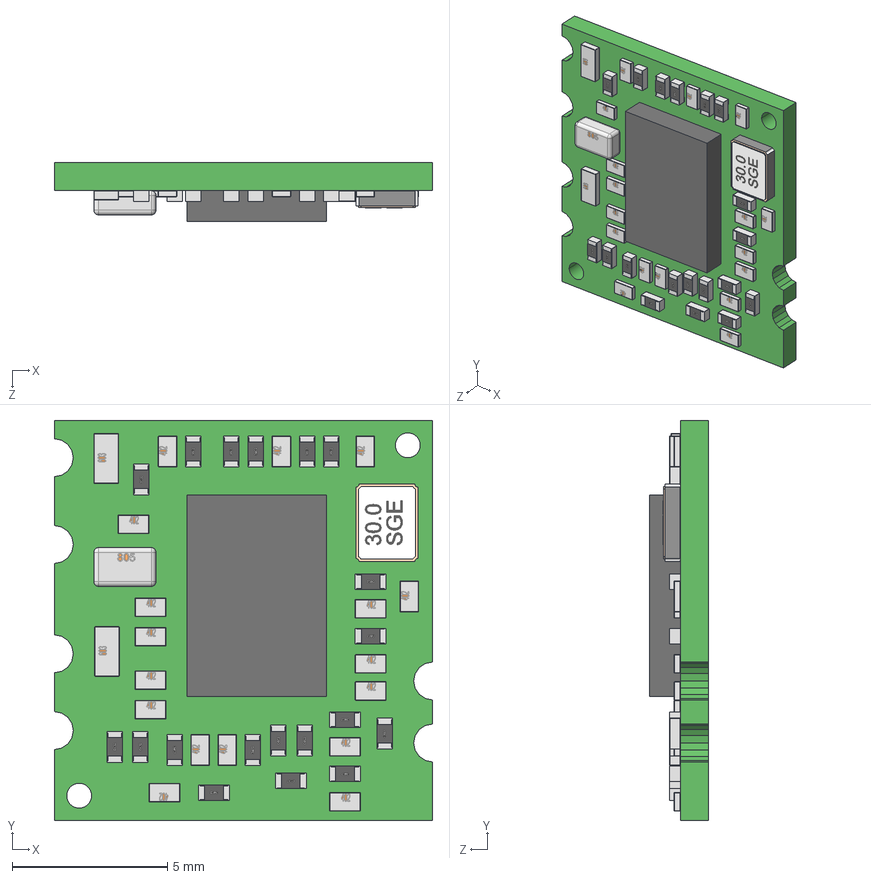
[picture p142: CAD file, 2023-09-23]
MAS_3DModel/RTL8188CUS.step
12.2 x 12.9 x 1.89 mm
Board
CAP0402 x 17
RES0402 x 19
CAP0603 x 2
CAP0805
SX-2520
Extruded
