MuratovAS/KiCadLibrary/MAS_3DModel/U_FL-R-SMT-1.step

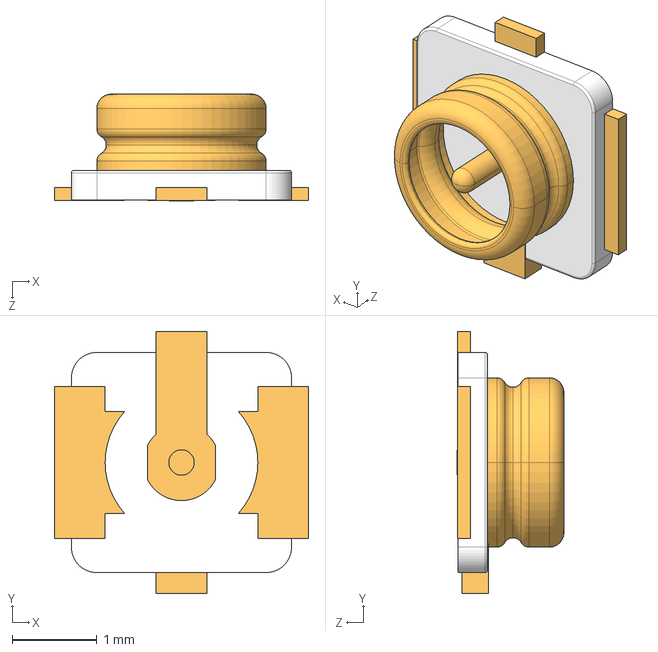
[picture p143: CAD file, 2023-09-23]
MAS_3DModel/U_FL-R-SMT-1.step
3.00 x 3.10 x 1.26 mm
