MuratovAS/KiCadLibrary/MAS_3DModel/WQFN-24-1EP_4x4mm_P0.5mm_EP2.45x2.45mm.step

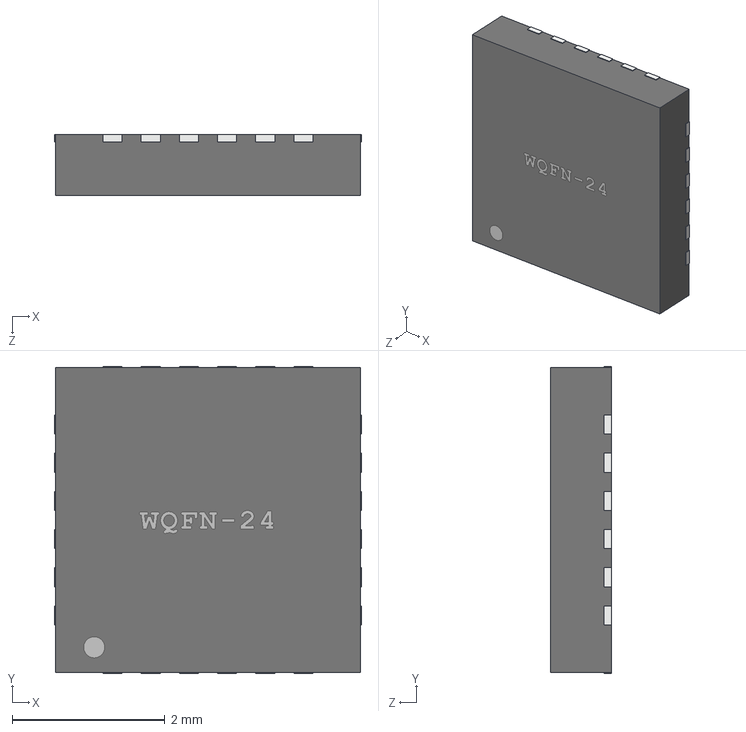
[picture p144: CAD file, 2023-09-23]
MAS_3DModel/WQFN-24-1EP_4x4mm_P0.5mm_EP2.45x2.45mm.step
4.02 x 4.02 x 0.801 mm
