MuratovAS/KiCadLibrary/MAS_3DModel/DHVQFN-20-1EP_3.5x4.5mm_P0.5mm_EP2x3mm.step

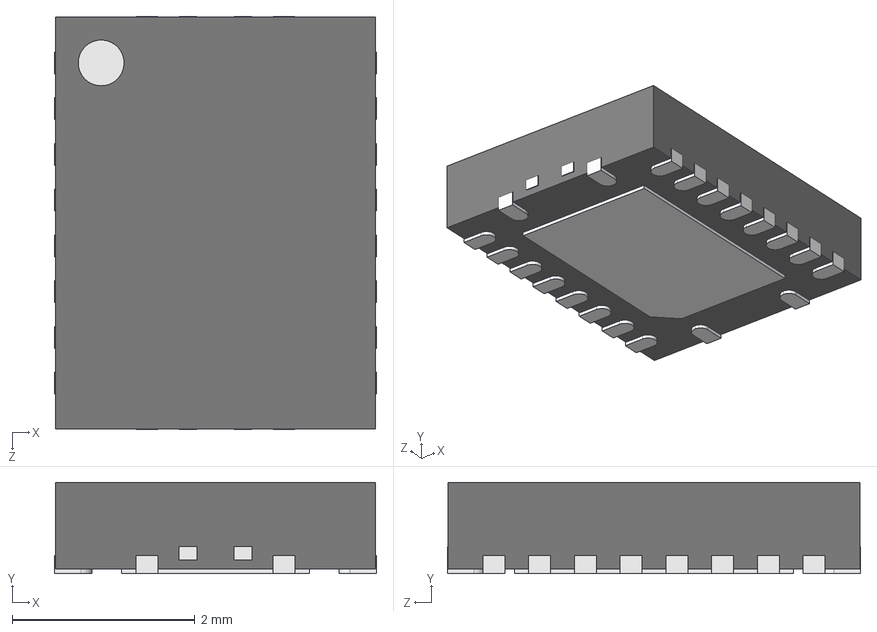
[picture p145: CAD file, 2023-09-20]
MAS_3DModel/DHVQFN-20-1EP_3.5x4.5mm_P0.5mm_EP2x3mm.step
3.52 x 1.00 x 4.52 mm
