MuratovAS/KiCadLibrary/MAS_3DModel/BUS_PCI_Express_Mini_cardHalf.step

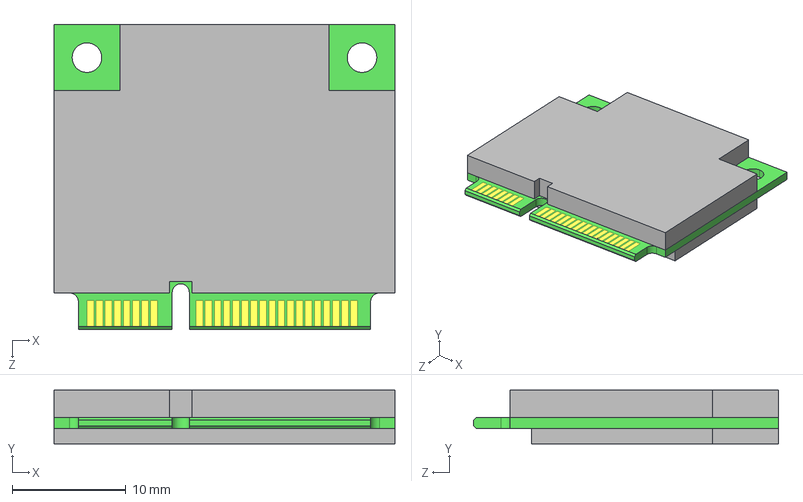
[picture p147: CAD file, 2023-09-08]
MAS_3DModel/BUS_PCI_Express_Mini_cardHalf.step
30.0 x 4.75 x 26.8 mm
