MuratovAS/KiCadLibrary/MAS_3DModel/BUS_PCI_Express_Mini_con2.step

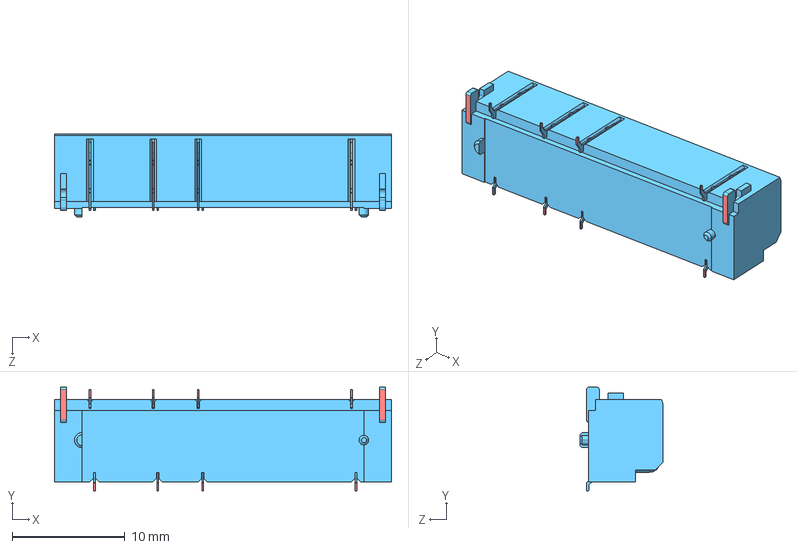
[picture p148: CAD file, 2023-09-08]
MAS_3DModel/BUS_PCI_Express_Mini_con2.step
29.9 x 9.20 x 7.40 mm
