MuratovAS/KiCadLibrary/MAS_3DModel/BUS_M2_2242_B_M.step

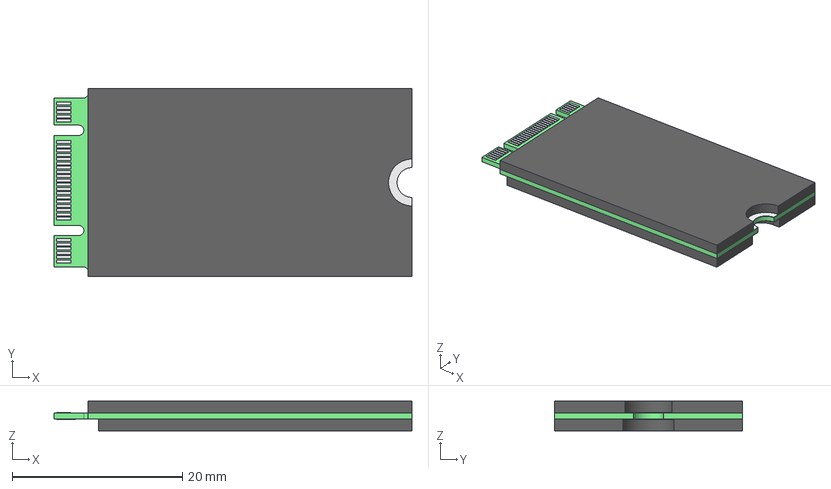
[picture p149: CAD file, 2023-09-08]
MAS_3DModel/BUS_M2_2242_B_M.step
42.0 x 22.0 x 3.50 mm
PCB
Pin_TOP
GND_TOP
GND_BOTTOM
Pin_Bottom
Component_Area_TOP
Component_Area_BOTTOM
