MuratovAS/KiCadLibrary/MAS_3DModel/BUS_PCI_Express_Mini_con.step

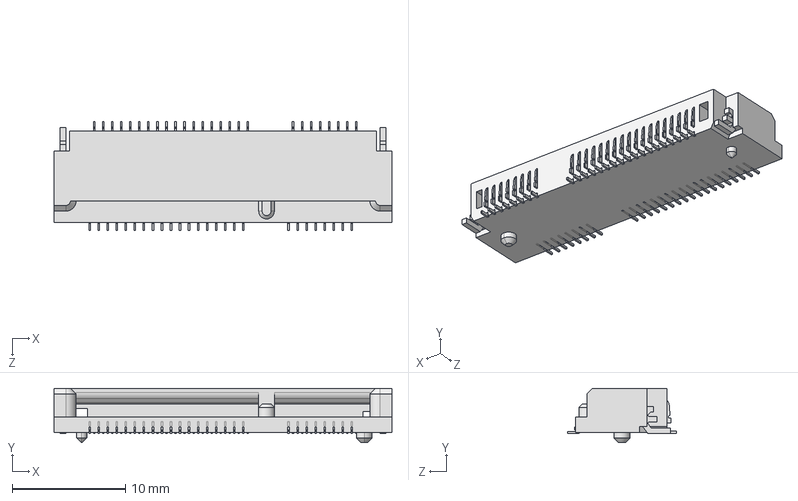
[picture p150: CAD file, 2023-09-08]
MAS_3DModel/BUS_PCI_Express_Mini_con.step
29.9 x 4.80 x 9.60 mm
