MuratovAS/KiCadLibrary/MAS_3DModel/Transformer_Ethernet_Halo_N5_SO-16_7.11x12.7mm.step

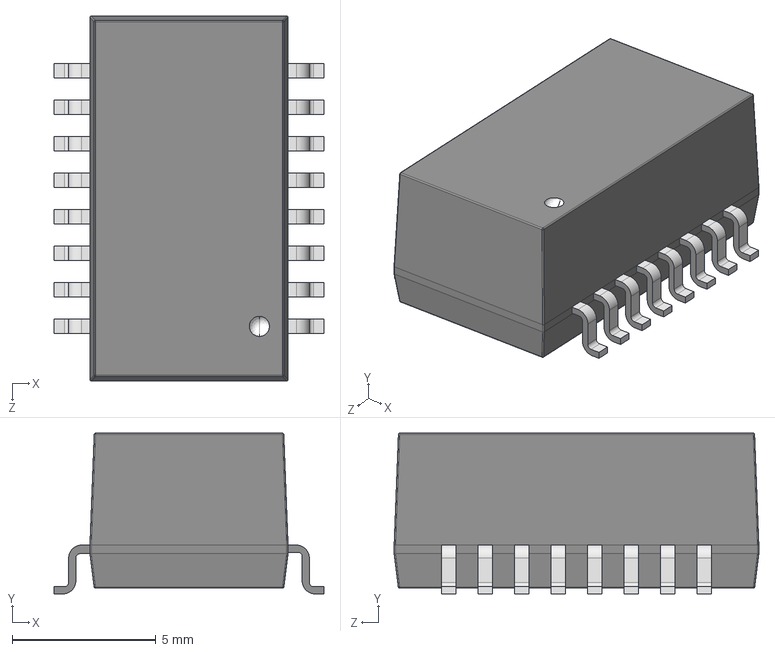
[picture p151: CAD file, 2023-07-06]
MAS_3DModel/Transformer_Ethernet_Halo_N5_SO-16_7.11x12.7mm.step
9.40 x 5.60 x 12.7 mm
