MuratovAS/KiCadLibrary/MAS_3DModel/JUSHUO_AFC07-S50ECC-00_1x50-1MP_P0.5mm_Horizontal.stp

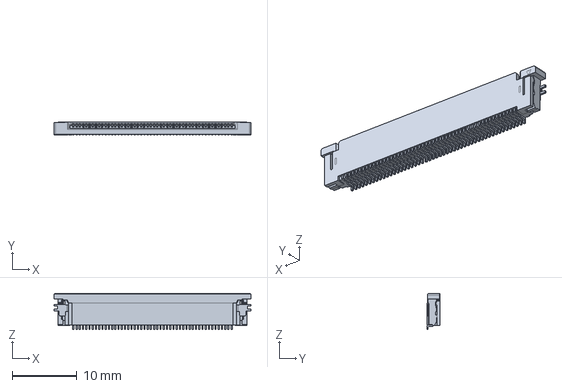
[picture p152: CAD file, 2023-07-02]
MAS_3DModel/JUSHUO_AFC07-S50ECC-00_1x50-1MP_P0.5mm_Horizontal.stp
30.5 x 2.05 x 5.60 mm
