MuratovAS/KiCadLibrary/MAS_3DModel/microSD_XKB_XKTF-015-x.step

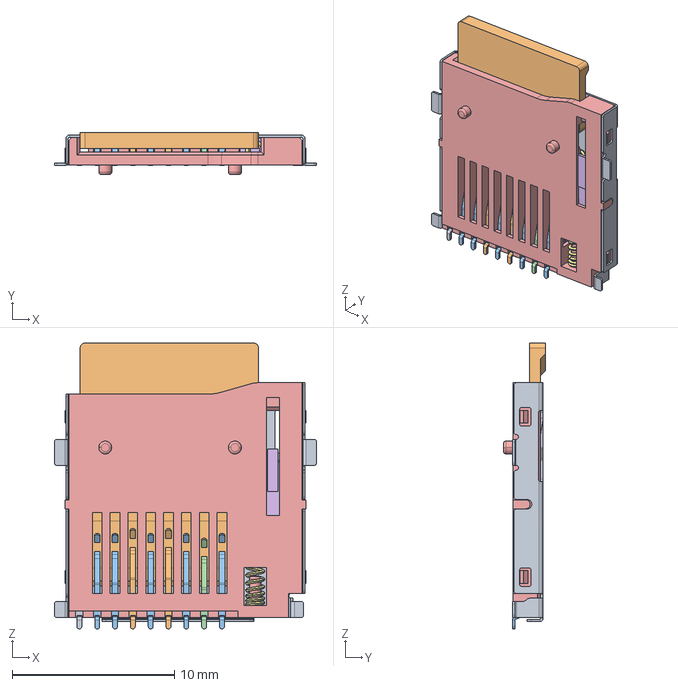
[picture p153: CAD file, 2023-07-02]
MAS_3DModel/microSD_XKB_XKTF-015-x.step
16.2 x 2.60 x 17.7 mm
