MuratovAS/KiCadLibrary/MAS_3DModel/jst-5-2.54.stp

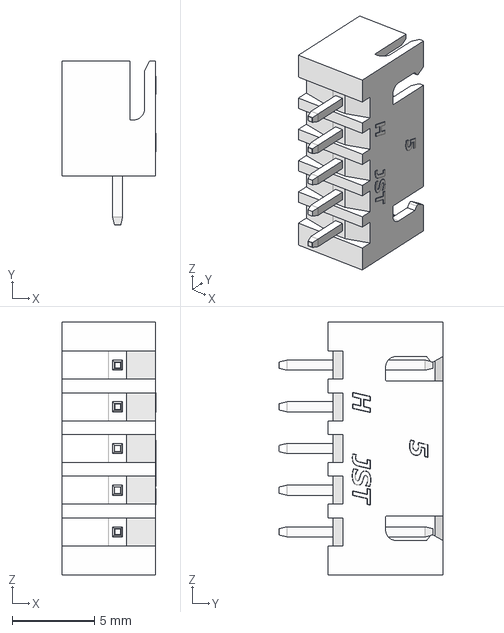
[picture p155: CAD file, 2023-07-01]
MAS_3DModel/jst-5-2.54.stp
5.73 x 10.0 x 15.4 mm
