MuratovAS/KiCadLibrary/MAS_3DModel/jst-2-2.54.stp

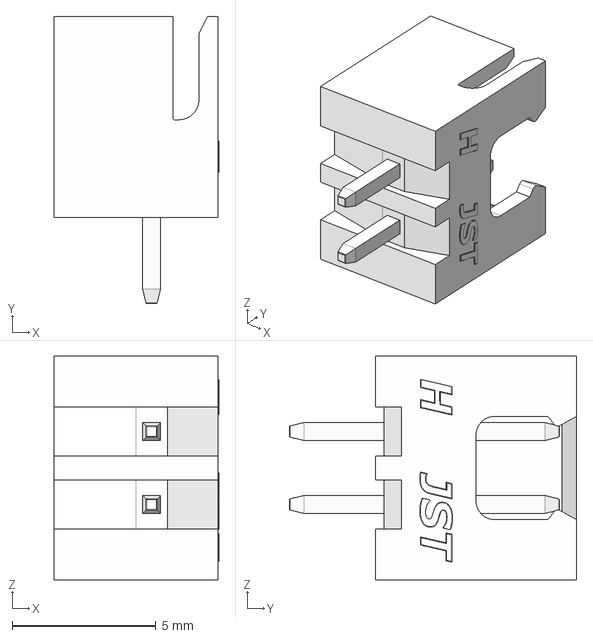
[picture p157: CAD file, 2023-07-01]
MAS_3DModel/jst-2-2.54.stp
5.73 x 10.0 x 7.80 mm
