MuratovAS/KiCadLibrary/MAS_3DModel/Crystal_SMD_5032-2Pin_5.0x3.2mm.step

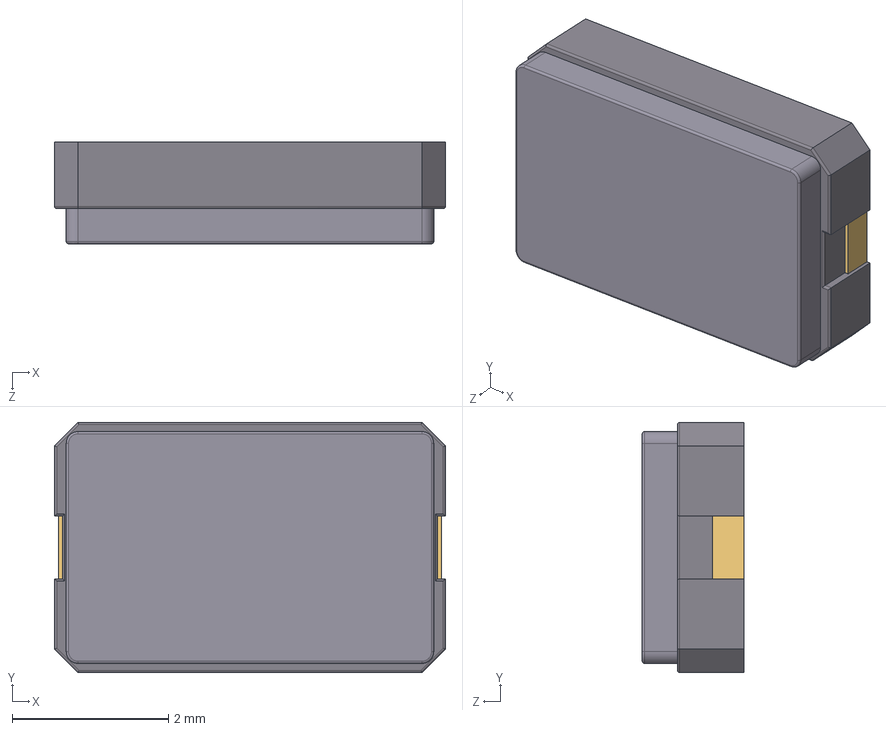
[picture p158: CAD file, 2023-07-01]
MAS_3DModel/Crystal_SMD_5032-2Pin_5.0x3.2mm.step
5.00 x 3.20 x 1.30 mm
