MuratovAS/KiCadLibrary/MAS_3DModel/jst-8-2.54.stp

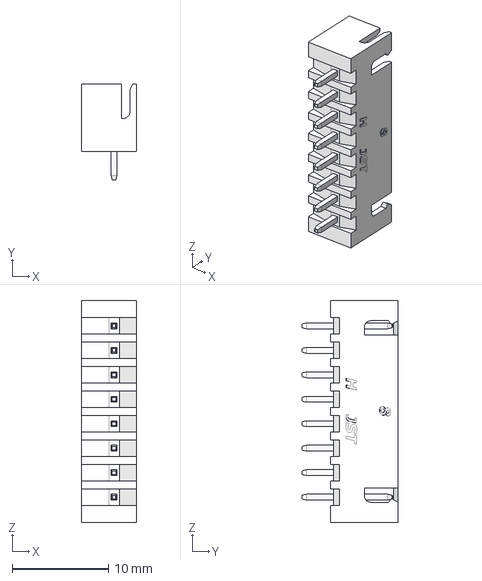
[picture p159: CAD file, 2023-07-01]
MAS_3DModel/jst-8-2.54.stp
5.73 x 10.0 x 23.0 mm
