MuratovAS/KiCadLibrary/MAS_3DModel/jst-3-2.54.stp

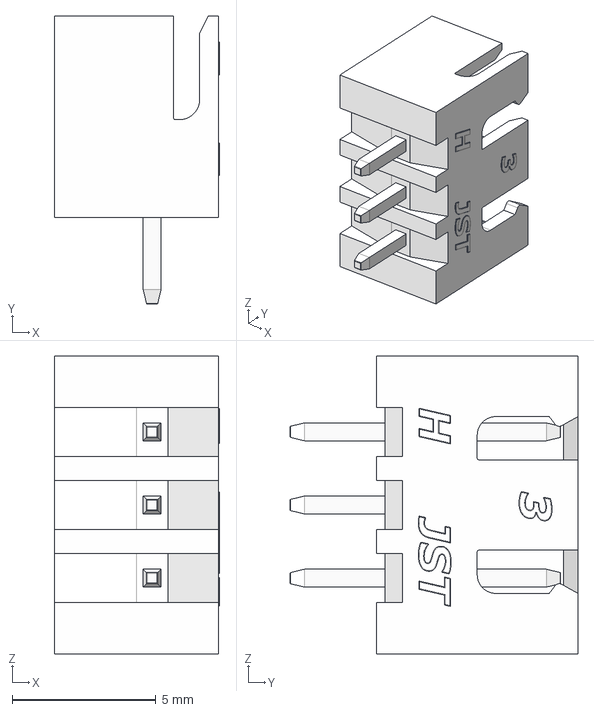
[picture p161: CAD file, 2023-07-01]
MAS_3DModel/jst-3-2.54.stp
5.73 x 10.0 x 10.3 mm
