MuratovAS/KiCadLibrary/(list of files, cad)

Other CAD files:
MAS_3DModel/MP_Wurth_WP-BUCF_7460408.step
MAS_3DModel/SMTSO2020.step
MAS_3DModel/DF40HC(3.0)-100DS.step
MAS_3D/B82726S2163.STEP
MAS_3DModel/0430450200.stp
MAS_3DModel/10-PowerVFQFN.step
MAS_3DModel/1042240820.stp
MAS_3DModel/11-10C405S.stp
MAS_3DModel/18650-smd.step
MAS_3DModel/3314G-1.stp
MAS_3DModel/430451214.stp
MAS_3DModel/475710001.stp
MAS_3DModel/5016_Keystone.stp
MAS_3DModel/8-wson 8x6_v1.step
MAS_3DModel/98414-X06-04XX.step
MAS_3DModel/98414-X06-06XX.step
MAS_3DModel/98414-X06-08XX.step
MAS_3DModel/98414-X06-10XX.step
MAS_3DModel/ACM2012-2P.step
MAS_3DModel/ADIS1647x.FCStd
MAS_3DModel/ALT4532M.step
MAS_3DModel/AM1LS.stp
MAS_3DModel/Allegro_CB_PFF.step
MAS_3DModel/B32652A3474J000.STEP
MAS_3DModel/B32654.step
MAS_3DModel/B43640C5227M000.STEP
MAS_3DModel/B57237.STEP
MAS_3DModel/B66283-G-X187.STEP
MAS_3DModel/B66285-G-X187.STEP
MAS_3DModel/B82464G4105M.STEP
MAS_3DModel/CDRH104R.STEP
MAS_3DModel/Coilcraft_150.STEP
MAS_3DModel/Crystal_SMD_3215-2Pin_3.2x1.5mm.step
MAS_3DModel/DG308-2.54-03P-14-00AH.STEP
MAS_3DModel/DIP8_SMD.step
MAS_3DModel/DKA30.STEP
MAS_3DModel/DRD16E04.STEP
MAS_3DModel/EC11-THT-15F-green.step
MAS_3DModel/EC11-THT-15F-thread-green.step
MAS_3DModel/EC11-THT-15K-green.step
MAS_3DModel/EC11-THT-15K-thread-green.step
MAS_3DModel/EC11-THT-15R-green.step
MAS_3DModel/EC11-THT-15R-thread-green.step
MAS_3DModel/EC11-THT-20F-green.step
MAS_3DModel/EC11-THT-20F-thread-green.step
MAS_3DModel/EC11-THT-20K-green.step
MAS_3DModel/EC11-THT-20K-thread-green.step
MAS_3DModel/EC11-THT-20R-green.step
MAS_3DModel/EC11-THT-20R-thread-green.step
MAS_3DModel/EC11-THT-25F-green.step
MAS_3DModel/EC11-THT-25F-thread-green.step
MAS_3DModel/EC11-THT-25K-green.step
MAS_3DModel/EC11-THT-25K-thread-green.step
MAS_3DModel/EC11-THT-25R-green.step
MAS_3DModel/EC11-THT-25R-thread-green.step
MAS_3DModel/EECS0HD334H.STEP
MAS_3DModel/EK950V-02P.STEP
MAS_3DModel/EK950V-03P.STEP
MAS_3DModel/Econopack4.STEP
MAS_3DModel/FH-101C.stp
MAS_3DModel/FUSE-2920.step
MAS_3DModel/Fuse_1032.step
MAS_3DModel/G2405CE.stp
MAS_3DModel/G5002CG.step
MAS_3DModel/H2450G.step
MAS_3DModel/HFD27.stp
MAS_3DModel/HR911130A.step
MAS_3DModel/HRO_TYPE-C-31-M-12.step
MAS_3DModel/HS_115-100.STEP
MAS_3DModel/JYC3D332MBF.STEP
MAS_3DModel/KLS12-TL051-1x1-GY-1-03.STEP
MAS_3DModel/KLS2-301-5.00-02P-2S.STEP
MAS_3DModel/KLS2-EDR-5.08-03P-4.step
MAS_3DModel/KLS2-EDV-5.08-02P-4.STEP
MAS_3DModel/KLS2-EDV-5.08-03P-4.STEP
MAS_3DModel/KMB-0231.step
MAS_3DModel/LGA10_2_0X2_0X0_95_BOS.step
MAS_3DModel/LIttleFuse_1812L.step
MAS_3DModel/LRS1575.STEP
MAS_3DModel/Littelfuse-Fuse Holders-MINI-FL1.stp
MAS_3DModel/M80-54004XX.step
MAS_3DModel/MS4525DO-DS5x.step
MAS_3DModel/Molex_Micro-Fit_3.0_43045-0400_2x02_P3.00mm_Horizontal.stp
MAS_3DModel/Molex_Micro-Fit_3.0_43045-0412_2x02_P3.00mm_Vertical.stp
MAS_3DModel/Molex_Micro-Fit_3.0_43045-0600_2x03_P3.00mm_Horizontal.stp
MAS_3DModel/Molex_Micro-Fit_3.0_43045-0612_2x03_P3.00mm_Vertical.stp
MAS_3DModel/Molex_Micro-Fit_3.0_43045-0800_2x04_P3.00mm_Horizontal.stp
MAS_3DModel/Molex_Micro-Fit_3.0_43045-0812_2x04_P3.00mm_Vertical.stp
MAS_3DModel/Molex_Micro-Fit_3.0_43650-0200_1x02_P3.00mm_Horizontal.stp
MAS_3DModel/Molex_Micro-Fit_3.0_43650-0215_1x02_P3.00mm_Vertical.stp
MAS_3DModel/Molex_Micro-Fit_3.0_43650-0300_1x03_P3.00mm_Horizontal.stp
MAS_3DModel/Molex_Micro-Fit_3.0_43650-0315_1x03_P3.00mm_Vertical.stp
MAS_3DModel/Molex_Mini-Fit_Jr_5566-04A_2x02_P4.20mm_Vertical.stp
MAS_3DModel/Molex_Mini-Fit_Jr_5569-04A2_2x02_P4.20mm_Horizontal.stp
MAS_3DModel/Murata_MGJ2_v1.step
MAS_3DModel/NRP-07-C-05D.STEP
MAS_3DModel/PG-DSO-8_7.6x6.4mm_P1.27.step
MAS_3DModel/PN13101.stp
MAS_3DModel/PN13104.stp
MAS_3DModel/PVM4.stp
MAS_3DModel/PinSocket_2x02_P2.00mm_Vertical_SMD.step
MAS_3DModel/PinSocket_2x03_P2.00mm_Vertical_SMD.step
MAS_3DModel/PinSocket_2x04_P2.00mm_Vertical_SMD.step
MAS_3DModel/PinSocket_2x05_P2.00mm_Vertical_SMD.step
MAS_3DModel/PinSocket_2x06_P2.00mm_Vertical_SMD.step
MAS_3DModel/Power_inductor_SMD_0530.STEP
MAS_3DModel/QAW0x.step
MAS_3DModel/QFN-56-1EP_7x7mm_P0.4mm_EP5.6x5.6mm.step
MAS_3DModel/QFN-88-1EP_10x10mm_P0.4mm.step
MAS_3DModel/QFN16_4x4.STEP
MAS_3DModel/R-PDSO-G8.step
MAS_3DModel/RC01812.step
MAS_3DModel/RJ12_Amphenol_54601.step
MAS_3DModel/RJ12_Vertical.stp
MAS_3DModel/RJ45_DS1128-09-S8B8X.STEP
MAS_3DModel/SCT1.0A.STEP
MAS_3DModel/SIP-4.STEP
MAS_3DModel/SK-12D02-G040.step
MAS_3DModel/SMD3225-4P.step
MAS_3DModel/SMMS0650.stp
MAS_3DModel/SO-8C.step
MAS_3DModel/SOIC-4_4.55x3.7mm_P2.54mm.step
MAS_3DModel/SOIC-8_7.5x5.85mm_P1.27mm.step
MAS_3DModel/SQP_10W.STEP
MAS_3DModel/SRP1040.STP
MAS_3DModel/SRR0604.step
MAS_3DModel/SRR1208.stp
MAS_3DModel/SSD1306-oled-0.91.stp
MAS_3DModel/SSD1306-oled-0.96.stp
MAS_3DModel/SSD1306_china_1_3.step
MAS_3DModel/TEN50WI.stp
MAS_3DModel/TFBGA-387_11.7x13.6mm_P0.65mm.step
MAS_3DModel/TMH_2415D.STEP
MAS_3DModel/TO-247_recumbent.step
MAS_3DModel/TS02002J474KSB0F0R.STEP
MAS_3DModel/TSFN1SM.stp
MAS_3DModel/VPT87D.FCStd
MAS_3DModel/XT60Female.step
MAS_3DModel/XT60Male.step
MAS_3DModel/YDS-Tech_82FB-02NL.stp
MAS_3DModel/ZMPT107 -1.step
MAS_3DModel/cube-2x2mm.step
MAS_3DModel/epcos_n87_16x9x6.STEP
MAS_3DModel/jst-10-2.54.stp
MAS_3DModel/jst-11-2.54.stp
MAS_3DModel/jst-4-2.54.stp
MAS_3DModel/jst-7-2.54.stp
MAS_3DModel/microSD_HC_Wuerth_693072010801.stp
MAS_3DModel/micro_usb_vetical.step
MAS_3DModel/mt7688_v1.step
MAS_3DModel/potentiometer_THT.STEP
MAS_3DModel/sma-901-143-6RFX.step
