MuratovAS/KiCadLibrary/(threads)

Thread 3 (2025-03-13):

Создать компонент kicad  `GW2A-LV18PG256C8I7`

MuratovAS, 2025-03-13:
Что требуется:
- Создать УГО в полном соответствие со схемой [Tang_Primer_20K_SOM-3961_Schematic.pdf](https://dl.sipeed.com/shareURL/TANG/Primer_20K/02_Schematic)
- Определить наименования УГО и ФП (описания прицепов в конце [документа](https://github.com/Artel-Inc/faq/blob/main/general_naming_guid.md))
- Подобрать FP из стандартной библиотеки, если оный отсутствует, создать.

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

Требования к структуре (внизу статьи):
https://github.com/MuratovAS/KiCadLibrary

Рекомендации по оформлению (внизу статьи):
https://github.com/Artel-Inc/faq/blob/main/hardware_kicad_schematic.md
https://github.com/Artel-Inc/faq/blob/main/hardware_kicad_pcb.md

Референс:
https://dl.sipeed.com/shareURL/TANG/Primer_20K/02_Schematic

MuratovAS, 2025-03-20:
проверил все шары. все сходится

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

MuratovAS, 2025-03-20:
Корпус проверял по модели отладки

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
