MuratovAS/KiCadLibrary/(commit log)

2020-02-28 первый коммит
    [8-wson 8x6_v1.step, mt7688_v1.step]
2020-02-29 Доработка структуры
2020-02-29 DC/DC Converter for IGBT driver
    [Murata_MGJ2_v1.step]
2020-03-01 Добавил FS200R12PT4
    [Econopack4.STEP]
2020-03-02 add SRR1208
    [SRR1208.stp]
2020-03-04 Транс БП
2020-03-05 add KLS2-EDR-5.08-02P-4
    [KLS2-EDR-5.08-02P-4.step]
2020-03-06 поправил УГО транса
2020-03-08 update footprint EconoPack4
2020-03-08 update footprint sup_trans
    контуры выреза в плате под феррит
2020-03-20 правка транса
2020-03-22 добавил несколько футпринтов
    - EconoPack4_wo_dwgs (без контура)
    - перемычки для мультиплат
2020-04-08 new net
    [8-wson 8x6_v1.step, Econopack4.STEP, KLS2-EDR-5.08-02P-4.step, Murata_MGJ2_v1.step, SRR1208.stp, mt7688_v1.step]
2020-04-08 add kicad_wks
2020-04-09 add elements
    KLS12-TL051-1x1-G/Y-1-03
    EECS0HD334H
    [EECS0HD334H.STEP, KLS12-TL051-1x1-GY-1-03.STEP]
2020-04-09 add info
    [AM1LS.stp]
2020-04-15 add NX3215SA-32.768K
    [Crystal_SMD_3215-2Pin_3.2x1.5mm.step, SRR0604.step]
2020-04-15 add 3d RJ12
    [RJ12_Amphenol_54601.step]
2020-04-16 add 3d model
    Crystal_SMD_3215-2Pin_3.2x1.5mm
    [Crystal_SMD_3215-2Pin_3.2x1.5mm.step]
2020-04-16 add Micro_SD_Card
    [microSD_HC_Wuerth_693072010801.stp]
2020-04-21 уменьшил диаметр падов на ethernet
    KLS12-TL051-1x1-GY-1-03
2020-05-05 fix all lib + add ssd1306
    [SSD1306_china_1_3.step]
2020-06-10 add NRP-07-C-05D
    [NRP-07-C-05D.STEP]
2020-06-11 add components
    KLS2-301-5.00-02P-2S
    SCT1.0A
    [KLS2-301-5.00-02P-2S.STEP, SCT1.0A.STEP]
2020-06-23 add ZMPT107-1
    [ZMPT107 -1.step]
2020-06-23 add TMH_2415D
    [TMH_2415D.STEP]
2020-07-05 fix NRP-07-C-05D
    уменьшил размеры пятаков
2020-07-31 add IRGP50B60PD1
    [TO-247_recumbent.step]
2020-07-31 add LNK306D
    [SO-8C.step]
2020-07-31 add elements
    -B82464G4105M
    -EK950V-02P
    -SN74LVC1G175DBVR
    [B82464G4105M.STEP, EK950V-02P.STEP]
2020-08-01 add B32654
    [B32654.step, JYC3D332MBF.STEP]
2020-08-02 add elements
    -JYC3D332MBF
    -B43640C5227M000
    -PVM4A
    [B43640C5227M000.STEP, JYC3D332MBF.STEP, PVM4.stp]
2020-08-02 add SQP_10W
    [SQP_10W.STEP]
2020-08-03 add elements
    -LRS1575
    -INA826AIDGKR
    [LRS1575.STEP]
2020-09-27 add elements
    -PWD13F60
    -ACS712
    -TLP350(LF5,TP5)
    [10-PowerVFQFN.step, 11-10C405S.stp]
2020-10-09 add B82726S2163
    [B82726S2163.STEP]
2020-10-14 add EK950V-03P
    [EK950V-03P.STEP]
2020-10-14 add FH-101C
    [FH-101C.stp]
2020-10-17 fix elements
    -LNK306D
    -10-PowerVFQFN footprint
2020-10-21 fix 10-PowerVFQFN
2021-04-08 Add KMB-0231
    Universal SCR Trigger Transformer
    [KMB-0231.step]
2021-04-09 Add STM32G431CBU6 and some fixes
    Fix: Swap pins in KMB-0231
2021-05-08 add DKA30B-15
    [DKA30.STEP]
2021-05-14 add KLS2-EDR-5.08-03P-4
    [KLS2-EDR-5.08-03P-4.step]
2021-05-25 add HS_115-110 HEATSINK
    [HS_115-100.STEP]
2021-05-26 add elements
    B57237
    Coilcraft_150
    epcos_n87_16x9x6
    potentiometer_THT
    [B57237.STEP, Coilcraft_150.STEP, epcos_n87_16x9x6.STEP, potentiometer_THT.STEP]
2021-06-26 add B66283-G-X187
    [B66283-G-X187.STEP]
2021-08-29 add symbols and footprint
    IIs2mdc dps310
    BMP
2021-08-30 УГО для blackmagicprobe
2021-09-04 Add vertical usb b
    [micro_usb_vetical.step]
2021-09-29 add 3314G-1
    [3314G-1.stp]
2021-10-16 add DRD16E04
    [DRD16E04.STEP]
2021-10-18 add FP SOIC-4
    [SOIC-4_4.55x3.7mm_P2.54mm.step]
2021-11-21 Add components
    QAW0x, 1ED31xxMU12H
    [PG-DSO-8_7.6x6.4mm_P1.27.step, QAW0x.step]
2022-01-05 update kicad6
2022-01-05 update path to 3d
    [10-PowerVFQFN.step, 11-10C405S.stp, 3314G-1.stp, 8-wson 8x6_v1.step, AM1LS.stp, B32654.step, B43640C5227M000.STEP, B57237.STEP]
2022-01-11 add B32652A3474J000
    [B32652A3474J000.STEP]
2022-04-18 Update .gitignore, fix kicad_sym
2022-04-20 Update MAS_IC_PowerSupply.kicad_sym and MAS_Transistors.kicad_sym
2022-04-21 Update MAS_IC_Analog.kicad_sym, MAS_IC_Logic.kicad_sym, and SMD-DIP-8_W9.53mm.kicad_mod
2022-04-21 fix MAS_IC_Analog.kicad_sym
2022-04-21 add DS1128-09-S8B8X
    [RJ45_DS1128-09-S8B8X.STEP]
2022-04-26 rename hole
2022-04-29 KiCAD scripting path added, xlsx_exporter/kicad_netlist_reader.py removed
2022-05-08 del PCB_trans.kicad_mod
2022-05-10 add SLO0540HxxxMTT
    [Power_inductor_SMD_0530.STEP]
2022-05-10 add B66285-G-X187.STEP and B66285-G-X187_EELP_22.STEP
    [B66285-G-X187.STEP, B66285-G-X187_EELP_22.STEP]
2022-05-19 add HCPL-060L, B0505S-1W
    [SIP-4.STEP]
2022-05-19 add KLS2-EDV-5.08-02P-4, KLS2-EDV-5.08-03P-4
    [KLS2-EDV-5.08-02P-4.STEP, KLS2-EDV-5.08-03P-4.STEP]
2022-06-10 add HFD 27/012-S
    [RELAY_HFD27_HNG.step]
2022-06-13 Update MAS_Mechanical.kicad_sym, HFD27 012-S.kicad_mod, and HFD27xx.kicad_mod
2022-06-14 Update HFD27
    [HFD27.stp, RELAY_HFD27_HNG.step]
2022-06-29 add SMMS0650
    [SMMS0650.stp]
2022-06-30 fix MAS_Connectors.kicad_sym
2022-09-30 fix MAS_IC_GateDriver.kicad_sym
2022-11-06 add 5016_Keystone
    [5016_Keystone.stp]
2022-11-06 fix FP and add new
    [CDRH104R.STEP]
2022-11-12 add con
    [430451214.stp, XT60Female.step, XT60Male.step]
2022-12-09 add element
    [18650-smd.step, DG308-2.54-03P-14-00AH.STEP, EC11-THT-15F-green.step, EC11-THT-15F-thread-green.step, EC11-THT-15K-green.step, EC11-THT-15K-thread-green.step, EC11-THT-15R-green.step, EC11-THT-15R-thread-green.step]
2022-12-09 add 3d
    [SSD1306-oled-0.91.stp]
2022-12-10 fix pin to DG308-2.54-03P-14-00A
2022-12-12 pni parts
    [DIP8_SMD.step, LGA10_2_0X2_0X0_95_BOS.step, MS4525DO-DS5x.step, TSFN1SM.stp]
2022-12-21 add MT7603E and osc SMD3225
    [QFN-56-1EP_7x7mm_P0.4mm_EP5.6x5.6mm.step, SMD3225-4P.step]
2022-12-29 components has been added
    [ACM2012-2P.step, ALT4532M.step, Littelfuse-Fuse Holders-MINI-FL1.stp, R-PDSO-G8.step]
2022-12-30 add oled 0.96
    [SSD1306-oled-0.96.stp]
2023-04-22 Update RJ45_B_1_4.step, MAS_Connectors.kicad_sym, and RJ45_B_1_4.kicad_mod
2023-04-22 add SK-12D02-G040
    [SK-12D02-G040.step]
2023-04-23 add G5002CG
    [G5002CG.step]
2023-05-09 add conn
    [G2405CE.stp, Molex_Micro-Fit_3.0_43045-0400_2x02_P3.00mm_Horizontal.stp, Molex_Micro-Fit_3.0_43045-0412_2x02_P3.00mm_Vertical.stp, Molex_Micro-Fit_3.0_43045-0600_2x03_P3.00mm_Horizontal.stp, Molex_Micro-Fit_3.0_43045-0612_2x03_P3.00mm_Vertical.stp, Molex_Micro-Fit_3.0_43045-0800_2x04_P3.00mm_Horizontal.stp, Molex_Micro-Fit_3.0_43045-0812_2x04_P3.00mm_Vertical.stp, Molex_Micro-Fit_3.0_43650-0200_1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]
2023-05-12 add conn 98424-G52-*
    [PinSocket_2x02_P2.00mm_Vertical_SMD.step, PinSocket_2x03_P2.00mm_Vertical_SMD.step, PinSocket_2x04_P2.00mm_Vertical_SMD.step, PinSocket_2x05_P2.00mm_Vertical_SMD.step, PinSocket_2x06_P2.00mm_Vertical_SMD.step]
2023-06-12 add f1C200s/f1C100s
    [QFN-88-1EP_10x10mm_P0.4mm.step]
2023-07-01 update lib
    [Crystal_SMD_5032-2Pin_5.0x3.2mm.step, Fuse_1032.step, RJ12_Vertical.stp, SOIC-8_7.5x5.85mm_P1.27mm.step, jst-10-2.54.stp, jst-11-2.54.stp, jst-12-2.54.stp, jst-2-2.54.stp]
2023-07-02 add microSD
    [microSD_XKB_XKTF-015-x.step]
2023-07-02 add ffc 50 pin
    [JUSHUO_AFC07-S50ECC-00_1x50-1MP_P0.5mm_Horizontal.stp]
2023-07-06 add Transformer_Ethernet_Halo_N5_SO-16_7.11x12.7mm
    [Transformer_Ethernet_Halo_N5_SO-16_7.11x12.7mm.step]
2023-08-07 add SolderJumper_Bridget_Pad0.5x0.8mm
2023-09-08 add m.2 and mPCI-e
    [BUS_M2_2242_B_M.step, BUS_M2_2260_B_M.step, BUS_PCI_Express_Mini_cardFull.step, BUS_PCI_Express_Mini_cardHalf.step, BUS_PCI_Express_Mini_con.step, BUS_PCI_Express_Mini_con2.step]
2023-09-10 add 1042240820
    [1042240820.stp]
2023-09-20 add DHVQFN-20 and TFBGA-387
    [DHVQFN-20-1EP_3.5x4.5mm_P0.5mm_EP2x3mm.step]
2023-09-23 add RTL8188CUS and U.FL-R-SMT-1 and WQFN-24
    [RTL8188CUS.step, U_FL-R-SMT-1.step, WQFN-24-1EP_4x4mm_P0.5mm_EP2.45x2.45mm.step]
2023-09-25 add DF40C_*DP
    [DF40C_100DP_0-4V.step, DF40C_30DP_0-4V.step, DF40C_30DS_0-4V.step, DF40C_50DP_0-4V.step, DF40C_50DS_0-4V.step, DF40C_60DP_0-4V.step, DF40C_60DS_0-4V.step, DF40C_70DP_0-4V.step]
2023-10-03 add MSK12C02, Bourns_3224W
    [Potentiometer_Bourns_3224W_Vertical.step, Slide-SW_SPDT.step]
2023-10-08 add PinHeader_3xX
    [PinHeader_3x15_P2.54mm_Horizontal.step, PinHeader_3x1_P2.54mm_Horizontal.step]
2023-10-25 add CA-IS3052W add BMP390
    [LGA-10_2x2x0.75mm_P0.5mm.step]
2023-10-25 add ADIS1647x
    [ADIS1647x.FCStd, ADIS1647x.step]
2023-10-29 add TS02002J474KSB0F0R add SQP25
    [SQP25.STEP, TS02002J474KSB0F0R.STEP]
2023-11-28 add JUSHUO_AFC07-S10ECC-00_1x10-1MP_P0.50mm_Horizontal
    [JUSHUO_AFC07-S10ECC-00_1x10-1MP_P0.50mm_Horizontal.step]
2024-01-08 add WJ25C-B-7.62-6P
    [WJ25C-B-7.62-6P.step]
2024-01-24 add FPC_1x50_P0.5mm
2024-02-08 add Buzzer_FUET-9650B and CA-IS3050W
    [Piez_9.6x9.6mm.step]
2024-02-10 add VPT87D and VPS8701
    [VPT87D.FCStd, VPT87D.step]
2024-02-19 add HDC1080 and PinSocket_End
    [HDC1080.step, PinSocket_2x05_P2.00mm_End.step]
2024-03-11 add BTS3410G add hdmi
    [HDMI_A_Kycon_KDMIX-SL1-NS-WS-B15_VerticalRightAngle.step]
2024-03-18 Added AYZ0202AGRLC
    2 pos switch
    [AYZ0202AGRLC.STEP]
2024-03-20 add Molex_Micro-Fit_3.0_44769-0401_2x02_P3.00mm_Vertical
    [Molex_Micro-Fit_3.0_44769-0401_2x02_P3.00mm_Vertical.stp]
2024-03-27 update silk to PinSocket_2xXX_P2.00mm
2024-04-22 add xt30
    [xt30u-f.step, xt30u-m.step]
2024-05-15 fix DF40HC
    [DF40HC(4.0)-60DS.step]
2024-05-16 add PinSocket_2x04_P2.00mm_Horizontal_SMD
    [PinSocket_2x04_P2.00mm_Horizontal_SMD.stp]
2024-06-27 update HLK-7688A
    [HLK-7688A.step]
2024-09-22 Add RV1106
    [QFN128_12.3x12.3_P0-35.step]
2024-09-24 add FE2.1 and Jack
    [USB_A_XUNPU_Horizontal_Stacked.step]
2024-09-25 Add AP6256
    [AP6XXX.step]
2024-09-29 add hdmi-a
    [HDMI_A_horizontal.step]
2024-10-01 add LM2587S and xt60pw
    [XT60PW-F.stp, XT60PW-M.stp]
2024-11-24 add ublox; add ws2812; micro fix
    [LED_WS2812B-2020_PLCC4_2.0x2.0mm.step, ublox-MAX.step]
2025-01-04 add `475710001` and `BMI088`
    [475710001.stp, LGA16_4.5x3mm_P0.5mm.step]
2025-01-05 add `jst sh1.0`
    [sh1.0_2pin_hori.step, sh1.0_3pin_hori.step, sh1.0_4pin_hori.step, sh1.0_5pin_hori.step, sh1.0_6pin_hori.step, sh1.0_8pin_hori.step, sh1.0_9pin_hori.step]
2025-01-16 add ANT_patch_25x25mm_4mm
    [ANT_patch_25x25mm_4mm.step]
2025-01-21 BL-M8812EU2
    Add Wifi-module
    [BL-M8812EU2 Long Range Wifi Module.STEP]
2025-01-22 fix BL-M8812EU2
    [BL-M8812EU2.step]
2025-02-02 add HR911130x
    [DF40HC(3.0)-100DS.step, HR911130A.step]
2025-02-19 add `MCX_Wuerth_60612102111406`
    [WR-MCX_Wuerth_60612102111406_Vertical.step]
2025-02-28 Add 'QSH/QTH-060', 'XR20M1172'
    'QSH-060-01-L-D-A', 'QTH-060-01-L-D-A', 'XR20M1172'
    [QSH-060-01-X-D-A.step, QTH-060-01-L-D-A.stp]
2025-02-28 fix fp `QSH/QTH-060`
    [QSH-060-01-x-x.step, QTH-060-01-x-x.step]
2025-03-04 Fix drill
2025-03-18 Start issues-3
    For create component GW2A-LV18PG256C8I7
    https://github.com/MuratovAS/KiCadLibrary/issues/3
2025-03-20 Finish issues-3
    For create component GW2A-LVxxPG256
    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
2025-03-20 Update MAS_IC_MCU.kicad_sym; close #3
2025-03-26 Create SMTSO20xx
    [SMTSO20xx_0.5.step, SMTSO20xx_1.5.step, SMTSO20xx_1.step, SMTSO20xx_10.step, SMTSO20xx_2.5.step, SMTSO20xx_2.step, SMTSO20xx_3.5.step, SMTSO20xx_3.step]
2025-03-26 Create SMTSO30xx
    [SMTSO30xx_1.5.step, SMTSO30xx_1.step, SMTSO30xx_10.step, SMTSO30xx_2.5.step, SMTSO30xx_2.step, SMTSO30xx_3.5.step, SMTSO30xx_3.step, SMTSO30xx_4.5.step]
2025-03-26 fix smtso and xt60; add AP40P04Q
    [SMTSO2005.step, SMTSO2010.step, SMTSO20100.step, SMTSO2015.step, SMTSO2020.step, SMTSO2025.step, SMTSO2030.step, SMTSO2035.step]
2025-03-28 Add 2450FM07A0029T and SX128x
    [CF_0402_4pin.step]
2025-03-29 Add RC01812
    [RC01812.step]
2025-05-07 add RM3100
    [PN13101.stp, PN13104.stp]
2025-06-16 add USL00-30L
    [USL00-30L.step, USL00-30LC.step]
2025-07-02 add MountingHole_3mmx4mm
2025-08-25 add HoT-0.25x1.5-8.2 and HoT-0.25x1.3-3.2
    + model
    [HoT-x-x.step]
2025-09-18 Add DIP Socket FP 4,6,8,10 + 3D models
    Reference
    98414-G06-04LF
    98414-G06-06LF
    98414-G06-08LF
    98414-G06-10LF
    [98414-X06-04XX.step, 98414-X06-06XX.step, 98414-X06-08XX.step, 98414-X06-10XX.step]
2025-10-19 Add BL-R8812AF1
    [BL-R8812AF1.step]
2025-11-05 add resistor 3920
    [R_3920.STEP]
2025-11-11 Correct IRM-30, 2EG082
    Add 3-d models
    Change 2EG08217-D2D-DF to 2EG082xx-D2D-x , correct FP
    Correct IRM-30 names + fp
    [MeanWell_IRM-30-x.step]
2025-11-14 correct AD7401, AMC1306, R_3920, MX1016B+3d models
    [MX1016B-10.16-03P.step]
2025-12-05 add TMH2412S footprint
    [TMH_2412S.STEP]
2026-01-09 Add Pogo_pin_TP
    add Pogo pin test point and 3d model for pogo
    [POGO_PIN_(C2842933).step]
2026-01-20 Add Pogo pin
2026-01-22 update 7460408 WP-BUCF
    [MP_Wurth_WP-BUCF_7460408.step]
2026-02-09 Update POGO_D1.2mm.kicad_mod, POGO_TestPoint_Pad_D1.2mm.kicad_mod
2026-03-02 Add DF40HC(3.0)-100DS-0.4V models
    [DF40HC(3.0)-100DS-0.4V.step]
2026-03-10 ADD RS70B08G3S03F
    [TFBGA-153(11.5x13).step]
2026-03-31 add CH224Q and DFN-10
    [DFN-10-1EP_2x2mm_P0.4mm_EP0.9x1.5mm.step]
2026-04-01 Add alternative pin to CH224Q
2026-05-25 Add MBS FP + model
    [MBS.step]
2026-05-27 Add DFN-8-3.3x3.3 FP + model
    [DFN-8L-1EP-S_3.3x3.3mm_P0.65mm_EP1.93x2.45mm.step]
2026-05-28 Add Fuse 4210
    [Fuse_2410.step]
2026-06-06 Update MAS_IC_Logic.kicad_sym and MAS_IC_Memory.kicad_sym
2026-06-10 Update AP6xxx.kicad_mod and QFN-128-1EP_12.3x12.3mm_P0.35mm_EP7x7mm.kicad_mod
2026-06-24 Add RJ45 Vertical step
    [RJ45_TE_1734577-1_Vertical.stp]
2026-06-24 Add Molex 436500415
    [Molex_Micro-Fit_3.0_43650-0415_1x04_P3.00mm_Vertical.stp]
2026-06-30 add Molex MF 3.0 Receptacle Housing, 1 Row, 4 Circuits step
    [Molex_Micro-Fit_3.0_43645-0400_1x04_P3.00mm.stp]
2026-07-03 add RJ45 Vertical 100616-X TE footprint
    [RJ45_TE_100616-X_Vertical.stp]
2026-07-22 add step MTJ-889X1-FSE
    [RJ45_AT-889X1-FSE_Vertical.step]
2026-07-25 Add URA_LD-30WR3 (sym+mod+stp)
    [TRACO_THR_40-72xWI.stp]
2026-07-28 Add symb. fp. 3D for SCH16T
    [SCH16T.stp]
2026-08-06 Add 3.81 2P and 11P (sym+mod+stp)
    [15EDGRC-3.81-11P.stp, DG381-3.81-02P-14-00AH.STEP]
2026-09-09 Update USB_C_Receptacle_HRO_TYPE-C-31-M-12.kicad_mod and MAS_RF.kicad_sym
2026-09-12 add some components
    add fp and 3d: standart SIP-8, TSSOP-28, M80-54004
    add scematics to VRB DC/DC<, ISOUSB211
    [M80-54004XX.step, SIP-8.stp, TSSOP-28_7.5x10.5mm_P0.65mm.stp]
2026-10-09 Update MAS_IC_Sensors.kicad_sym, MicroSD_Molex_475710001.kicad_mod, and SCH16T.kicad_mod
