MuratovAS/KiCadLibrary/(notices)

Notices in the files:
MAS_3DModel/QTH-060-01-x-x.step:
author */ ('License CC BY-ND 4.0'),
